MaslowCNC/Maslow_4/UI_UPDATED_DESIGN.md

# Connection Monitoring UI - Updated Design

## Changes Made (Based on PR Feedback)

1. ✅ Text is now static: "Connection Monitoring" (always the same)
2. ✅ Background color changes based on status
3. ✅ Warning icon "!" appears when there are issues
4. ✅ Detailed information moved to hover tooltip

## Visual Examples

### 1. Good Connection (Green - No Warning Icon)
```
┌─────────────────────────────┐
│   Connection Monitoring     │  <- Green background (#4aa85c)
└─────────────────────────────┘    White text, NO "!" icon

Hover tooltip shows:
┌──────────────────────────────────────┐
│ Connection Status: Good              │
│ Latency: 45ms                        │
│ Packet Loss: 0.5%                    │
│ Pings Sent: 124                      │
│ Pings Received: 123                  │
└──────────────────────────────────────┘
```

### 2. Degraded Connection (Orange - WITH Warning Icon)
```
┌─────────────────────────────┐
│   Connection Monitoring !   │  <- Orange background (#ffa500)
└─────────────────────────────┘    White text, WITH "!" icon

Hover tooltip shows:
┌──────────────────────────────────────┐
│ Connection Status: Degraded          │
│ Latency: 235ms                       │
│ Packet Loss: 8.2%                    │
│ Pings Sent: 200                      │
│ Pings Received: 183                  │
│ Pings Lost: 17                       │
└──────────────────────────────────────┘
```

### 3. Poor Connection (Dark Orange - WITH Warning Icon)
```
┌─────────────────────────────┐
│   Connection Monitoring !   │  <- Dark orange (#ff6600)
└─────────────────────────────┘    White text, WITH "!" icon

Hover tooltip shows:
┌──────────────────────────────────────┐
│ Connection Status: Poor              │
│ Packet Loss: 32.5%                   │
│ Pings Sent: 300                      │
│ Pings Received: 202                  │
│ Pings Lost: 98                       │
│                                      │
│ Consider checking your WiFi          │
│ connection.                          │
└──────────────────────────────────────┘
```

### 4. Connection Lost (Red - WITH Warning Icon)
```
┌─────────────────────────────┐
│   Connection Monitoring !   │  <- Red background (#ce654c)
└─────────────────────────────┘    White text, WITH "!" icon

Hover tooltip shows:
┌──────────────────────────────────────┐
│ Connection Status: LOST              │
│ Packet Loss: 78.3%                   │
│ Pings Sent: 150                      │
│ Pings Received: 32                   │
│ Pings Lost: 118                      │
│                                      │
│ Connection to machine may be lost!   │
└──────────────────────────────────────┘
```

### 5. Multiple Tabs Warning (Orange - WITH Warning Icon)
```
┌─────────────────────────────┐
│   Connection Monitoring !   │  <- Warning orange (#ff8c00)
└─────────────────────────────┘    White text, WITH "!" icon

Hover tooltip shows:
┌──────────────────────────────────────┐
│ WARNING: Multiple tabs detected!     │
│ 7 foreign pings received.            │
│ Only one tab should control the      │
│ machine at a time.                   │
└──────────────────────────────────────┘
```

### 6. Initializing (Starting - No Warning Icon)
```
┌─────────────────────────────┐
│   Connection Monitoring     │  <- Orange background (#ffa500)
└─────────────────────────────┘    White text, NO "!" icon

Hover tooltip shows:
┌──────────────────────────────────────┐
│ Initializing connection monitor...   │
└──────────────────────────────────────┘
```

## Key Improvements

### Before (Original Design):
- Text changed with every status update
- Hard to read at a glance
- Example: "✓ Connected (45ms, 0.5% loss)"
- Details always visible in button text

### After (Updated Design):
- Text is always "Connection Monitoring"
- Easy to identify at a glance
- Warning icon "!" clearly indicates issues
- Details hidden in tooltip (cleaner interface)
- Color-coded background for quick status check

## Color Scheme Summary

| Status | Background Color | Text Color | Warning Icon | Meaning |
|---|---|---|---|---|
| Good | Green (#4aa85c) | White | No | < 5% loss, < 500ms |
| Degraded | Orange (#ffa500) | White | Yes | 5-20% loss or 500-1000ms |
| Poor | Dark Orange (#ff6600) | White | Yes | 20-50% loss |
| Lost | Red (#ce654c) | White | Yes | > 50% loss |
| Multiple Tabs | Warning Orange (#ff8c00) | White | Yes | Foreign pings detected |
| Starting | Orange (#ffa500) | White | No | Initializing |

## User Experience Flow

1. **Normal Operation**: Green background, no warning icon, hover for details
2. **Minor Issues**: Orange background, warning icon appears, hover to see specifics
3. **Severe Issues**: Red background, warning icon, hover for troubleshooting info
4. **Critical Alert**: Orange with warning icon, hover shows multi-tab warning

The static text makes it clear what the indicator is for, while the color and warning icon provide immediate status feedback. Detailed metrics are available on hover for users who want to investigate further.
