MaslowCNC/Maslow_4/VISUAL_COMPARISON.md

# Visual Comparison: Before vs After

## BEFORE (Original Design)

The indicator text changed with every status update, making it harder to read:

```
┌──────────────────────────────────────────┐
│  ✓ Connected (45ms, 0.5% loss)          │  <- Text changes constantly
└──────────────────────────────────────────┘     Hard to read at a glance
    Green background, white text
```

```
┌──────────────────────────────────────────┐
│  ⚠️ Degraded (235ms, 8.2% loss)         │  <- Different text
└──────────────────────────────────────────┘     for each status
    Orange background, white text
```

```
┌──────────────────────────────────────────┐
│  ⚠️ Multiple tabs detected (7 foreign)  │  <- Long, detailed text
└──────────────────────────────────────────┘     in the button
    Orange background, white text
```

## AFTER (New Design) ✨

The indicator now has static text that's easy to read, with details on hover:

### Good Connection
```
┌──────────────────────────────┐
│   Connection Monitoring      │  <- Static, easy to read
└──────────────────────────────┘     
    🟢 Green background (#4aa85c)
    No warning icon

    Hover for tooltip:
    ┌────────────────────────────────┐
    │ Connection Status: Good        │
    │ Latency: 45ms                  │
    │ Packet Loss: 0.5%              │
    │ Pings Sent: 124                │
    │ Pings Received: 123            │
    └────────────────────────────────┘
```

### Degraded Connection (with Warning)
```
┌──────────────────────────────┐
│   Connection Monitoring !    │  <- Warning icon appears
└──────────────────────────────┘     
    🟠 Orange background (#ffa500)
    Warning icon "!" visible

    Hover for tooltip:
    ┌────────────────────────────────┐
    │ Connection Status: Degraded    │
    │ Latency: 235ms                 │
    │ Packet Loss: 8.2%              │
    │ Pings Sent: 200                │
    │ Pings Received: 183            │
    │ Pings Lost: 17                 │
    └────────────────────────────────┘
```

### Poor Connection (with Warning)
```
┌──────────────────────────────┐
│   Connection Monitoring !    │  <- Warning icon
└──────────────────────────────┘     
    🟠 Dark Orange background (#ff6600)
    Warning icon "!" visible

    Hover for tooltip:
    ┌────────────────────────────────┐
    │ Connection Status: Poor        │
    │ Packet Loss: 32.5%             │
    │ Pings Sent: 300                │
    │ Pings Received: 202            │
    │ Pings Lost: 98                 │
    │                                │
    │ Consider checking your WiFi    │
    │ connection.                    │
    └────────────────────────────────┘
```

### Connection Lost (with Warning)
```
┌──────────────────────────────┐
│   Connection Monitoring !    │  <- Warning icon
└──────────────────────────────┘     
    🔴 Red background (#ce654c)
    Warning icon "!" visible

    Hover for tooltip:
    ┌────────────────────────────────┐
    │ Connection Status: LOST        │
    │ Packet Loss: 78.3%             │
    │ Pings Sent: 150                │
    │ Pings Received: 32             │
    │ Pings Lost: 118                │
    │                                │
    │ Connection to machine may be   │
    │ lost!                          │
    └────────────────────────────────┘
```

### Multiple Tabs Warning
```
┌──────────────────────────────┐
│   Connection Monitoring !    │  <- Warning icon
└──────────────────────────────┘     
    🟠 Warning Orange (#ff8c00)
    Warning icon "!" visible

    Hover for tooltip:
    ┌────────────────────────────────┐
    │ WARNING: Multiple tabs         │
    │ detected!                      │
    │ 7 foreign pings received.      │
    │ Only one tab should control    │
    │ the machine at a time.         │
    └────────────────────────────────┘
```

## Key Improvements ✨

### ✅ Readability
- **Before**: Text like "✓ Connected (45ms, 0.5% loss)" was hard to read quickly
- **After**: "Connection Monitoring" is clear and easy to identify

### ✅ Consistency
- **Before**: Button text changed constantly, making it hard to find
- **After**: Static text makes it easy to locate the indicator

### ✅ Warning Visibility
- **Before**: Warning emoji mixed with other text
- **After**: Clean "!" icon that stands out clearly

### ✅ Information Density
- **Before**: All details crammed into button text
- **After**: Clean interface with details available on hover

### ✅ Professional Appearance
- **Before**: Looked cluttered with numbers and symbols
- **After**: Clean, professional status indicator

## Real-World Usage Example

### User Experience Flow:

1. **Quick Glance**: User sees green "Connection Monitoring" button
   - Status: Everything is OK ✓

2. **Notice Warning**: Color changes to orange, "!" appears
   - User immediately knows there's an issue
   - Text still readable: "Connection Monitoring !"

3. **Get Details**: User hovers over the button
   - Tooltip shows: "Latency: 235ms, Packet Loss: 8.2%"
   - User can diagnose the problem

4. **Take Action**: Based on tooltip info, user can:
   - Check WiFi signal
   - Close extra browser tabs
   - Move closer to router
   - Wait for connection to stabilize

## Technical Implementation

The JavaScript code now returns:
```javascript
{
    status: 'good',
    displayText: 'Connection Monitoring',  // Always the same
    tooltip: 'Connection Status: Good\n...',  // Details here
    color: '#4aa85c',  // Green
    showWarning: false  // No "!" icon
}
```

When issues are detected:
```javascript
{
    status: 'degraded',
    displayText: 'Connection Monitoring',  // Still the same
    tooltip: 'Connection Status: Degraded\n...',  // Details
    color: '#ffa500',  // Orange
    showWarning: true  // Show "!" icon
}
```

The UI code then:
1. Sets text: `displayText + (showWarning ? ' !' : '')`
2. Sets color: `indicator.style.backgroundColor = color`
3. Sets tooltip: `indicator.title = tooltip`

This creates a clean, professional interface that's easy to understand at a glance while still providing detailed information when needed.
