MaslowCNC/Maslow_4/.github/INDEXING_SUMMARY.md

# Repository Indexing Summary - Maslow_4

**Date**: 2024-12-04  
**Issue**: Request to refresh Copilot repository setup and re-index

## Important Information About Copilot Indexing

GitHub Copilot's repository indexing is **fully automatic** and happens when users interact with the repository through Copilot Chat. There is no manual "re-index" trigger or setup command.

### How to Get Updated Index (For Repository Users)

To ensure Copilot uses the latest repository state:

1. **Open Copilot Chat** in your IDE (VS Code, GitHub.com, etc.)
2. **Use repository context** (@workspace or repository selection)
3. **Start a conversation** - The index automatically refreshes in under 60 seconds

That's it! No configuration changes or setup commands are needed.

## Repository Configuration Status

This repository is properly configured for optimal Copilot performance:

### ✅ Language and Linter Configurations Present

- **`.clang-format`**: C++ code style definition (140 char limit, brace wrapping, etc.)
- **`.editorconfig`**: Universal editor settings (final newlines)
- **`.coderabbit.yaml`**: Automated code review with multiple linters enabled

### ✅ Copilot Instructions Available

- **`.github/copilot-instructions.md`**: Comprehensive 204-line guide covering:
  - Build system commands and timing (PlatformIO)
  - Project structure navigation
  - Development best practices
  - Testing and validation procedures
  - ESP32-S3 firmware specifics

### ✅ Repository Structure Documented

Primary source directories properly organized:
- `firmware/FluidNC/src/` - 311 C++ source files
- `firmware/` - ESP32 firmware and build system
- `docs/` - User documentation
- Python build scripts (8 files)

Build artifacts correctly excluded via `.gitignore`:
- `.pio/`, `build/`, `node_modules/`, `dist/`

## New Documentation Added

Created **`.github/COPILOT_INDEXING.md`** with detailed information about:
- How Copilot indexing works (automatic, instant refresh)
- Repository structure and file organization
- Language configurations and linters
- Best practices for using Copilot with this project
- Troubleshooting steps if indexing seems stale

## Action Items for Repository Owner

Since Copilot indexing is automatic, here's what you can do:

### Immediate Actions (Anyone with Copilot access)

1. **Test the refresh yourself**:
   - Open this repository in VS Code or GitHub.com
   - Start a new Copilot Chat session
   - Ask: "@workspace Can you explain the structure of firmware/FluidNC/src/?"
   - Copilot should index and provide accurate, current information

2. **Verify indexing is working**:
   - Ask Copilot about recent changes or newly added directories
   - Check if suggestions reference the correct file paths
   - Confirm it understands this is ESP32-S3 FluidNC firmware

### If Indexing Still Seems Stale

1. **Check indexing limits**:
   - Copilot Individual: 5 repositories max
   - Copilot Business: 50 repositories max
   - Copilot Enterprise: Unlimited
   - If at limit, may need to remove old indexes or upgrade

2. **Try troubleshooting steps**:
   - Restart IDE completely
   - Clear IDE cache
   - Log out and back into GitHub Copilot

3. **Contact GitHub Support** if issues persist:
   - Mention this is for the MaslowCNC/Maslow_4 repository
   - Describe what Copilot is getting wrong (outdated paths, missing directories, etc.)
   - Reference that indexing should be automatic but appears stuck

## Technical Details

### Languages Detected
- C/C++: Primary (311 files in src/)
- Python: Build scripts (8 files)
- JavaScript/HTML/CSS: Web UI
- YAML: Configuration files

### Build System
- **PlatformIO** for ESP32-S3 firmware
- **Node.js** for web UI build
- **Python** for build automation

### Code Style Enforced
- clang-format for C++ (configured)
- editorconfig for all files (basic)

## Conclusion

**No code changes are required to refresh Copilot indexing.** The indexing happens automatically when users interact with the repository via Copilot Chat.

This PR adds documentation to help users understand how indexing works and confirms that all repository configurations are in place for optimal Copilot performance.

### What This PR Does

✅ Adds comprehensive indexing documentation  
✅ Confirms language/linter configurations are present  
✅ Documents repository structure for reference  
✅ Provides troubleshooting guidance  

### What It Does NOT Do

❌ Does not trigger Copilot re-indexing (not possible via code changes)  
❌ Does not add new linters (existing ones are sufficient)  
❌ Does not change any source code (not necessary)  

The repository is ready for Copilot to index. Users just need to open Copilot Chat to trigger the automatic indexing process.
