MaslowCNC/Maslow_4/docs/calibration-simulation/data-parser.html

# Maslow Calibration Data Parser

Process real calibration measurements to find optimal anchor positions

### 📥 Calibration Data Input

Paste measurement data from your Maslow machine. Supports multiple formats:
• Plain: {tl:2051.76, tr:2053.05, bl:1942.31, br:1952.85},...
• CLBM: CLBM:[{bl:2960.58, br:3150.08, tr:3067.72, tl:3049.85},...]

Measurement Data:

Parse and Validate

### ⚓ Initial Anchor Positions

Starting estimates for anchor point positions. If the initial fitness is low or the frame is nearly square, the algorithm will automatically compute better starting positions using rectangular optimization (same as ESP3D-WEBUI).

Top Left X (mm)

Top Left Y (mm)

Top Right X (mm)

Top Right Y (mm)

Bottom Right X (mm)

### ⚙️ Computation

Compute Anchor Positions

#### 📊 Search Visualization

Red points: Phase 1 diagonal search | Blue points: Phase 2 arc search | Green star: Best configuration found

#### ✅ Optimized Anchor Positions

Top Left X

Top Left Y

Top Right X

Top Right Y

Bottom Right X

Fitness Score

### 📋 Output Log
