MaslowCNC/Maslow_4/firmware/FluidNC/data/maslow.yaml

board: Maslow
name: Maslow S3 Board
meta: 
Maslow_vertical: false
Maslow_calibration_grid_width_mm_X: 0.000000
Maslow_calibration_grid_height_mm_Y: 0.000000
Maslow_calibration_grid_size: 9
Maslow_Retract_Current_Threshold: 1300
Maslow_Acceptable_Calibration_Threshold: 0.450000
Maslow_Extend_Dist: 2600.000000
Maslow_Scale_X: 1.000000
Maslow_Scale_Y: 1.000000
Maslow_debugEnabled: false
MaslowAutoUpdate: false
MaslowUpdateURL: https://api.github.com/repos/BarbourSmith/FluidNC/releases/latest
Maslow_spoilboardThickness: 0.000000
Maslow_workThickness: 0.000000
Maslow_Park_Z: 2.000000
Maslow_Park_X: 0.000000
Maslow_Park_Y: 0.000000
stepping: 
  engine: Timed
  idle_ms: 240
  pulse_us: 4
  dir_delay_us: 0
  disable_delay_us: 0
  segments: 12

uart1: 
  txd_pin: gpio.1
  rxd_pin: gpio.2
  rts_pin: NO_PIN
  cts_pin: NO_PIN
  baud: 115200
  mode: 8N1

spi: 
  miso_pin: gpio.13
  mosi_pin: gpio.11
  sck_pin: gpio.12

sdcard: 
  cs_pin: gpio.10
  card_detect_pin: NO_PIN
  frequency_hz: 8000000

kinematics: 
  MaslowKinematics: 
    tlX: 139.199997
    tlY: 3230.600098
    tlZ: 100.000000
    trX: 4308.899902
    trY: 3230.699951
    trZ: 56.000000
    blX: 0.000000
    blY: 0.000000
    blZ: 34.000000
    brX: 4340.399902
    brY: 0.000000
    brZ: 78.000000
    beltEndExtension: 30.000000
    armLength: 123.400002
    beltToothSpacing: 1.998800
    encoderTeeth: 22.000000
    maxSegmentLength: 5.000000
    fixedZ: false

axes: 
  shared_stepper_disable_pin: NO_PIN
  shared_stepper_reset_pin: NO_PIN
  a: 
    steps_per_mm: 80.000000
    max_rate_mm_per_min: 2000.000000
    acceleration_mm_per_sec2: 50.000000
    max_travel_mm: 4000.000000
    soft_limits: false
    homing: 
      cycle: -1
      allow_single_axis: true
      positive_direction: true
      mpos_mm: 0.000000
      feed_mm_per_min: 50.000000
      seek_mm_per_min: 200.000000
      settle_ms: 250
      seek_scaler: 1.100000
      feed_scaler: 1.100000

    motor0: 
      limit_neg_pin: NO_PIN
      limit_pos_pin: NO_PIN
      limit_all_pin: NO_PIN
      hard_limits: false
      pulloff_mm: 1.000000
      null_motor: 

  b: 
    steps_per_mm: 80.000000
    max_rate_mm_per_min: 2000.000000
    acceleration_mm_per_sec2: 50.000000
    max_travel_mm: 4000.000000
    soft_limits: false
    homing: 
      cycle: -1
      allow_single_axis: true
      positive_direction: true
      mpos_mm: 0.000000
      feed_mm_per_min: 50.000000
      seek_mm_per_min: 200.000000
      settle_ms: 250
      seek_scaler: 1.100000
      feed_scaler: 1.100000

    motor0: 
      limit_neg_pin: NO_PIN
      limit_pos_pin: NO_PIN
      limit_all_pin: NO_PIN
      hard_limits: false
      pulloff_mm: 1.000000
      null_motor: 

  c: 
    steps_per_mm: 80.000000
    max_rate_mm_per_min: 2000.000000
    acceleration_mm_per_sec2: 50.000000
    max_travel_mm: 4000.000000
    soft_limits: false
    homing: 
      cycle: -1
      allow_single_axis: true
      positive_direction: true
      mpos_mm: 0.000000
      feed_mm_per_min: 50.000000
      seek_mm_per_min: 200.000000
      settle_ms: 250
      seek_scaler: 1.100000
      feed_scaler: 1.100000

    motor0: 
      limit_neg_pin: NO_PIN
      limit_pos_pin: NO_PIN
      limit_all_pin: NO_PIN
      hard_limits: false
      pulloff_mm: 1.000000
      null_motor: 

  d: 
    steps_per_mm: 80.000000
    max_rate_mm_per_min: 2000.000000
    acceleration_mm_per_sec2: 50.000000
    max_travel_mm: 4000.000000
    soft_limits: false
    homing: 
      cycle: -1
      allow_single_axis: true
      positive_direction: true
      mpos_mm: 0.000000
      feed_mm_per_min: 50.000000
      seek_mm_per_min: 200.000000
      settle_ms: 250
      seek_scaler: 1.100000
      feed_scaler: 1.100000

    motor0: 
      limit_neg_pin: NO_PIN
      limit_pos_pin: NO_PIN
      limit_all_pin: NO_PIN
      hard_limits: false
      pulloff_mm: 1.000000
      null_motor: 

  z: 
    steps_per_mm: 100.000000
    max_rate_mm_per_min: 400.000000
    acceleration_mm_per_sec2: 10.000000
    max_travel_mm: 100.000000
    soft_limits: false
    homing: 
      cycle: -1
      allow_single_axis: true
      positive_direction: true
      mpos_mm: 0.000000
      feed_mm_per_min: 50.000000
      seek_mm_per_min: 200.000000
      settle_ms: 250
      seek_scaler: 1.100000
      feed_scaler: 1.100000

    motor0: 
      limit_neg_pin: NO_PIN
      limit_pos_pin: NO_PIN
      limit_all_pin: NO_PIN
      hard_limits: false
      pulloff_mm: 1.000000
      null_motor:

    motor1: 
      limit_neg_pin: NO_PIN
      limit_pos_pin: NO_PIN
      limit_all_pin: NO_PIN
      hard_limits: false
      pulloff_mm: 1.000000
      null_motor:

control: 
  safety_door_pin: NO_PIN
  reset_pin: NO_PIN
  feed_hold_pin: NO_PIN
  cycle_start_pin: NO_PIN
  macro0_pin: NO_PIN
  macro1_pin: NO_PIN
  macro2_pin: NO_PIN
  macro3_pin: NO_PIN

coolant: 
  flood_pin: NO_PIN
  mist_pin: NO_PIN
  delay_ms: 0

probe: 
  pin: NO_PIN
  check_mode_start: true

macros: 
  startup_line0: 
  startup_line1: 
  macro0: 
  macro1: 
  macro2: 
  macro3: 

start: 
  must_home: true
  deactivate_parking: false
  check_limits: false

parking: 
  enable: false
  axis: Z
  target_mpos_mm: -5.000000
  rate_mm_per_min: 800.000000
  pullout_distance_mm: 5.000000
  pullout_rate_mm_per_min: 250.000000

user_outputs: 
  analog0_pin: NO_PIN
  analog1_pin: NO_PIN
  analog2_pin: NO_PIN
  analog3_pin: NO_PIN
  analog0_hz: 5000
  analog1_hz: 5000
  analog2_hz: 5000
  analog3_hz: 5000
  digital0_pin: NO_PIN
  digital1_pin: NO_PIN
  digital2_pin: NO_PIN
  digital3_pin: NO_PIN
  digital4_pin: NO_PIN
  digital5_pin: NO_PIN
  digital6_pin: NO_PIN
  digital7_pin: NO_PIN

SpindleBoard:
  phase_deg_per_mm: 45.000000
  max_rpm: 14000
  suction_power: 100
  tool_num: 0
  speed_map: 0=0.000% 14000=100.000%
  off_on_alarm: true
  uart:
    txd_pin: gpio.15
    rxd_pin: gpio.16
    rts_pin: NO_PIN
    cts_pin: NO_PIN
    baud: 115200
    mode: 8N1

arc_tolerance_mm: 0.002000
junction_deviation_mm: 0.010000
verbose_errors: false
report_inches: false
enable_parking_override_control: false
use_line_numbers: false
planner_blocks: 16
