MaslowCNC/Maslow_4/spindle/src/config.h

#pragma once

#include <Arduino.h>

// Motor parameters
const int   POLE_PAIRS = 1;
const float SUPPLY_VOLTAGE = 24.0f;

// Which way the spindle turns.  The two motors always run in OPPOSITE senses (the spindle is
// driven by the difference of their angles); this flips both at once, which reverses the
// spindle.  The Z axis is unaffected: it comes from the phase OFFSET, which updatePhaseOffset()
// applies as the same delta to both motors without consulting these signs, so homing, tool
// load and tool removal keep their existing directions.  Flip to +1 to spin the other way.
const int SPINDLE_DIRECTION = -1;

// Voltage limits
const float BASE_VOLTAGE = 1.3f;
// Open-loop ceiling, raised to the full 24V bus to give the sweep room up to 18,000 RPM.
// NOTE this also required raising the DRIVER limit to SUPPLY_VOLTAGE in motor_controller.cpp -
// BLDCDriver6PWM::setPwm() clamps every phase to driver.voltage_limit, which was
// SUPPLY_VOLTAGE*0.8 = 19.2V, so a 24V ceiling here alone would simply have been clipped there.
//
// Physical reality above ~12V: with SinePWM on a 24V bus the largest UNCLIPPED q-axis amplitude
// is voltage_power_supply/2 = 12V.  Past that the waveform clips, and at full square wave the
// fundamental tops out near (4/pi)(Vdc/2) = 15.3V.  So requesting 18-24V buys progressively less
// speed and progressively more harmonic current and heat - which is also what trips the
// MP6541A's fixed 16-20A OCP.  Expect the top of the LUT to flatten out somewhere in here.
// The calibration LUT must be rebuilt (run "CAL") after changing this.
const float MAX_VOLTAGE = 24.0f;

// PWM configuration.  The MP6541A adds no dead time of its own (HSx+LSx both high simply
// gives Hi-Z), so the dead zone below is the only shoot-through margin.
// NOTE: on the DRV8316 board these two values were assigned AFTER the driver was initialized,
// so they never reached SimpleFOC and the PWM actually ran at its 20kHz default - which is
// what the calibration LUT below was measured at.  They now take effect, so the value here is
// set to that same 20kHz to keep commutation identical to the old board.  Note the practical
// ceiling is ~26.7kHz, NOT the 50kHz that _constrain() in _configure6PWM suggests: the timer
// period is then clamped to _PWM_RES_MIN = 3000 counts, giving 160MHz/(2*3000).  Anything above
// that is silently rounded down to it.  Raise deliberately and re-run CAL, remembering that a
// higher carrier shrinks the ripple the sweep measures, so the same current target then
// corresponds to a higher real fundamental current.
const long  PWM_FREQUENCY = 20000;   // 20 kHz
const float DEAD_ZONE = 0.02f;       // ~2% deadtime

// Phase current sensing (MP6541A SOx -> board termination -> ESP32 ADC).
// SOx sources/sinks ILOAD/11000 into a 3.3k/3.3k divider across 3V3, so Rref = 1.65k and the
// nominal mid-point is 1.65V:  V = Vref + Rref * ILOAD / 11000  ->  0.15 V/A.
// (The preliminary MPQ6541 datasheet quotes 1/10,000, which would be 0.165 V/A - verify on
// the bench against a clamp meter before trusting the current-based trip points below.)
const float CSA_RREF_OHMS   = 1650.0f;
const float CSA_RATIO       = 11000.0f;
const float CSA_GAIN_V_PER_A = CSA_RREF_OHMS / CSA_RATIO;   // 0.15 V/A
const float CSA_VREF        = 1.65f;   // nominal zero-current level; measured at boot

// Fan PWM configuration
const long FAN_PWM_FREQUENCY = 25000;
const int  FAN_PWM_RESOLUTION_BITS = 8;
const int  FAN_PWM_CHANNEL = 7;
const uint8_t FAN_MIN_DUTY = 80;
const uint8_t FAN_MAX_DUTY = 255;
const int FAN_LEVEL_COUNT = 100;
const float FAN_PWM_RAMP_UNITS_PER_SEC = 320.0f;

// Velocity ramping
const float VELOCITY_RAMP_RATE = 20.0f;   // rad/s per second, used during calibration
// Spindle spin-up/down uses a single uniform ramp rate (matching the reference firmware, which
// reaches 14,000 RPM cleanly with one rate), applied by rampVelocity() every FOC iteration.
// The earlier speed-dependent dual-rate ramp was removed: it added complexity without being the
// cause of the high-speed fault.
const float SPINDLE_RAMP_RATE  = 500.0f;  // rad/s per second, spindle on/off spin-up/down rate

// --- FOC loop scheduling ---
// The FOC update (loopFOC + move) runs on its OWN task pinned to core 1 with nothing else in the
// loop body, so open-loop commutation runs at the highest, most uniform rate possible.  Everything
// that is not time-critical for commutation - current sensing (six analogReads, ~0.5 ms), the
// calibration sweep, serial command dispatch, fault checks, the tool state machine, fan, telemetry
// and status reporting - runs on a SEPARATE housekeeping task pinned to core 0, ticking every
// FOC_HOUSEKEEPING_INTERVAL_MS.  This keeps the expensive/slow work entirely off the FOC core so it
// can never lengthen a commutation step (the ~1.8 kHz-with-hiccups single-task design pulled the
// open-loop rotor out of sync at high RPM and tripped the driver's hardware OCP even with voltage
// headroom).
const uint32_t FOC_HOUSEKEEPING_INTERVAL_MS = 2;     // core-0 housekeeping task period

// Phase offset ramping
const float PHASE_OFFSET_STEP = 45.0f * PI / 180.0f;          // 45 deg per keypress
const float PHASE_OFFSET_RAMP_RATE = 400.0f * PI / 180.0f;    // 400 deg/s ramp

// Inter-board link (UART to FluidNC XY board)
const long    LINK_BAUD = 115200;          // baud rate for the XY <-> spindle link
const uint32_t LINK_STATUS_INTERVAL_MS = 50;  // how often to report status to the XY board
const int     MAX_COMMAND_RPM = 18000;     // clamp for spindle speed commands; keep in step with
                                           // CAL_MAX_RAD so the whole LUT is reachable over the link

// On-demand WiFi OTA.  The board normally keeps its radio off; when the XY board sends
// the 'W' link command (in response to $Spindle/EnableOTA) it joins the XY board's WiFi
// network and runs an ArduinoOTA server so it can be reflashed wirelessly with:
//   pio run -e esp32-s3-devkitc-1-ota -t upload
const char*    const OTA_HOSTNAME                = "maslow-spindle";  // mDNS -> maslow-spindle.local
const uint32_t       OTA_WIFI_CONNECT_TIMEOUT_MS = 20000;   // give up joining WiFi after 20 s
const uint32_t       OTA_IDLE_TIMEOUT_MS         = 300000;  // drop WiFi/OTA after 5 min idle
const int            OTA_RECEIVE_TIMEOUT_MS      = 15000;   // tolerate 15 s data gaps mid-flash
// The OTA request is persisted to NVS and the board reboots to service it from a clean,
// freshly booted state (the only state that reliably survives the WiFi radio's power-up
// current surge on 24 V-only power).  Each boot is one attempt: a bring-up that resets mid-surge
// OR a transfer that fails (which also reboots, since ArduinoOTA won't cleanly retry on the same
// boot) consumes one.  The flag survives across reboots so setup() resumes automatically, up to
// this many attempts before giving up so a truly unreachable network can't boot-loop forever.
const uint8_t        OTA_BOOT_MAX_ATTEMPTS       = 10;

// Current filtering
const float CURRENT_FILTER_ALPHA = 0.001f;      // Slow filter for DC-equivalent telemetry
const float PROTECTION_FILTER_ALPHA = 0.1f;     // Fast filter for stall detection

// Overcurrent protection
const float OVERCURRENT_THRESHOLD = 6.0f;       // Phase-RMS trip point (A), same during calibration
const int   OVERCURRENT_CONSECUTIVE_TRIPS = 100;

// Motor run timeout
const uint32_t MOTOR_RUN_DURATION = 6000000;     // 60 seconds in ms

// Z-axis (phase-offset) hold power-down.  When the spindle is not spinning, the two
// BLDC drivers only hold the Z position with current, which keeps them (and the
// cooling fan) energized even though nothing is moving.  Once the XY board reports the
// machine is idle (the 'D' command) and the phase ramp has settled to within this
// tolerance of its target, the drivers are powered down.
const float PHASE_MOVE_COMPLETE_EPS_RAD = 0.001f;   // within ~0.06 deg of target = move done

// Extra motor voltage applied while the relative phase between the two motors is
// changing (i.e. the Z axis is moving).  Changing the phase fights extra mechanical
// resistance in the Z drive, so give the drivers a little more headroom while moving.
const float Z_MOVE_VOLTAGE_BOOST = 1.0f;            // volts added during phase (Z) moves

// --- Z-axis power-up homing (top-of-travel beam break) ---
// On power-up, an already-blocked beam makes the Z lower until the beam clears.  Otherwise,
// the Z raises until the top-of-travel beam is interrupted, which establishes the home
// position and confirms a tool is loaded.  The Z is driven by the relative phase between
// the two BLDC motors; the XY board uses 45 deg of phase per mm of Z travel (its
// phase_deg_per_mm), so the mm limit below is converted with the same constant.  If the Z
// raises further than Z_HOMING_MAX_MM without the beam breaking, no tool is loaded.
const float PHASE_DEG_PER_MM   = 45.0f;   // must match the XY board's phase_deg_per_mm
const float Z_HOMING_MAX_MM    = 70.0f;   // give up (no tool loaded) past this much travel
const float Z_HOMING_PHASE_DIR = +1.0f;   // +1 raises the Z; flip to -1 if homing drives it down
const float Z_HOMING_MAX_RAD =
    Z_HOMING_MAX_MM * PHASE_DEG_PER_MM * PI / 180.0f;  // travel limit as a phase offset (rad)

// Delay the power-up Z-homing raise so the shared 24V rail and the other boards have time to
// come up first.  The homing raise energizes both BLDC motors (a heavy current surge); doing
// it the instant the app starts can sag a marginal supply.  Only the initial boot homing is
// delayed - an operator re-home ('G') happens long after boot so it is unaffected.
const uint32_t BOOT_HOMING_DELAY_MS = 1000;  // wait this long after boot before homing

// --- Z-axis tool loading (reverse of homing) ---
// While homing has left the board in the "no tool loaded" state, the top-of-travel beam
// is monitored.  When the operator inserts a tool it interrupts the beam, which starts a
// tool-loading move: the Z is lowered (opposite the homing direction) until the beam is no
// longer broken, at which point a tool is considered loaded.  The lowering move gives up
// (leaving the tool not loaded) once it travels this far without the beam clearing.
const float Z_TOOL_LOAD_MAX_MM = 200.0f;  // give up lowering past this much travel
const float Z_TOOL_LOAD_MAX_RAD =
    Z_TOOL_LOAD_MAX_MM * PHASE_DEG_PER_MM * PI / 180.0f;  // travel limit as a phase offset (rad)
// As the operator inserts a tool the beam can flicker (blocked, briefly clear, blocked) before
// the tool is pulled fully down and seated.  The lowering move keeps going until the beam has
// stayed clear for this long; any re-interruption during the window restarts the timer, so a
// momentary clear while the tool is still entering the beam is not mistaken for a seated tool.
const uint32_t Z_TOOL_LOAD_CONFIRM_MS = 400;  // beam must stay clear this long to finish loading

// --- Z-axis tool removal (raise to eject) ---
// Triggered on demand by the XY board's 'R' command (web UI "Remove Tool" button).  With a
// tool loaded the top-of-travel beam is interrupted; the Z raises (the homing direction)
// until the beam transitions from blocked (tool present) to clear (tool removed), at which
// point the board returns to the "no tool loaded" state.  The move gives up and stops once
// it travels this far without the beam clearing.
const float Z_TOOL_REMOVE_MAX_MM = 150.0f;  // give up raising past this much travel
const float Z_TOOL_REMOVE_MAX_RAD =
    Z_TOOL_REMOVE_MAX_MM * PHASE_DEG_PER_MM * PI / 180.0f;  // travel limit as a phase offset (rad)
// After the beam first clears the Z keeps raising for this long to confirm a clean removal;
// if the beam is interrupted again at any point during the window the timer restarts, so a
// tool flickering right on the edge of the beam is not mistaken for a completed removal.
const uint32_t Z_TOOL_REMOVE_CONFIRM_MS = 500;  // beam must stay clear this long to finish

// Calibration LUT
const int   CAL_LUT_SIZE = 180;                                     // 100, 200, ... 18000 RPM
const float CAL_TARGET_CURRENT = 2.625f;                            // Target phase-RMS current (A).
                                                                    // 75% of the 3.5A used on the DRV8316 board: the
                                                                    // MP6541A's hardware OCP is fixed at 16-20A (the
                                                                    // DRV8316 was configured for 24A), so the sweep
                                                                    // hunts to a lower current to keep the spin-up
                                                                    // transient clear of that lower ceiling.
const float CAL_CHECKPOINT_STEP_RAD = 100.0f * 2.0f * PI / 60.0f;  // 100 RPM step in rad/s
const float CAL_MAX_RAD = 18000.0f * 2.0f * PI / 60.0f;            // 18000 RPM in rad/s
const uint32_t CAL_SETTLE_MS = 500;                                 // ms to wait after reaching speed
const float CAL_HUNT_VOLTAGE_MARGIN = 0.9f;                         // Max extra volts above seeded LUT at each step
const float CAL_RAMP_VOLT_PER_RAD = 0.0025f;                        // Open-loop spin-floor slope (volts per rad/s).
                                                                    // Kept BELOW the real current-limited curve so the hunt
                                                                    // can converge; spin-up between steps relies on the
                                                                    // previous step's voltage carried forward, not this floor.
const uint32_t CAL_COOLDOWN_MS = 8000;                              // How long to coast (motor de-energized) after the driver
                                                                    // thermally shuts down before continuing the sweep.  At low
                                                                    // RPM the open-loop current sits on one or two FETs long
                                                                    // enough to heat the die (the package can still feel cool);
                                                                    // coasting to cool before advancing stops the heat cascading
                                                                    // up through the rest of the sweep.  The MP6541A has no
                                                                    // over-temperature WARNING and nFAULT is released once the
                                                                    // drivers sleep, so the die temperature cannot be polled
                                                                    // while cooling - this is a fixed wait.

// MP6541A fault detection (nFAULT, one open-drain pin per driver).
// The MP6541A reports two things on nFAULT, distinguished by shape rather than by any status
// register: an OVER-CURRENT disables the outputs and auto-retries after ~2ms, so it appears as
// a burst of falling EDGES (counted by an ISR - a 100ms poll would miss the pulses), while an
// OVER-TEMPERATURE shutdown holds the pin LOW continuously until the die cools by ~25C.
// Over-voltage and UVLO are NOT reported on nFAULT at all, so they can no longer be observed
// in firmware; the MP6541A still protects itself in hardware.
const int OCP_CONSEC_LIMIT = 5;  // 5 x 100ms = 500ms of repeated OCP retries -> disable
// An over-temperature must be seen held low across this many 100ms samples before it is
// treated as a genuine (latching) serious fault, so that the brief low of an over-current
// retry sampled at just the wrong moment is not mistaken for a thermal shutdown.
const int SERIOUS_CONSEC_LIMIT = 3;  // 3 x 100ms = 300ms sustained OT -> latch

// Over-current response: the motors run open-loop, so an over-current means the rotor has
// already slipped.  There is nothing to retry - the spindle stops at 0 RPM, latches fault
// code 2 (which alarms the XY board and stops a running job), and invalidates the Z reference
// until a homing cycle re-establishes it.  A fresh speed command is the deliberate restart.
