MaslowCNC/Maslow_4/firmware/FluidNC/src/Kinematics/MaslowKinematics.cpp

// Copyright (c) 2024 - Maslow CNC. All rights reserved.
// Use of this source code is governed by a GPLv3 license that can be found in the LICENSE file.

#include "MaslowKinematics.h"

#include "../Machine/MachineConfig.h"
#include "../Limit.h"
#include "../Machine/Homing.h"
#include "../Protocol.h"
#include "../System.h"
#include <cstring>
#include "../NutsBolts.h"
#include "../MotionControl.h"
#include <cmath>
#include <algorithm>
#include "../Maslow/Maslow.h"

/*
Default configuration for Maslow CNC:

kinematics:
  MaslowKinematics:
    tlX: -27.6
    tlY: 2064.9
    tlZ: 100.0
    trX: 2924.3
    trY: 2066.5
    trZ: 56.0
    blX: 0.0
    blY: 0.0
    blZ: 34.0
    brX: 2953.2
    brY: 0.0
    brZ: 78.0
    beltEndExtension: 30.0
    armLength: 123.4
    beltToothSpacing: 1.9988  # mm between adjacent belt teeth
    encoderTeeth: 22.0        # tooth count on the encoder roller
    spoilboardThickness: 0.0
    workThickness: 0.0
    maxSegmentLength: 5.0

This implements the cable-driven kinematics for the Maslow CNC system.
The system has 5 axes:
- A, B, C, D (belt motors: TL, TR, BL, BR mapped to motors 0-3)
- Z (cartesian Z coordinate mapped to motor 4)

The spoilboardThickness and workThickness parameters account for material thickness
placed on the cutting surface. Both values are added to all anchor point Z coordinates
during belt length calculations, effectively raising the reference height for all belts.

The maxSegmentLength parameter controls belt length synchronization during long moves.
Moves longer than this distance (in mm) will be automatically segmented to ensure
correct belt lengths are computed at intermediate points, preventing belt slack.
*/

namespace Kinematics {

    // Global pointer to the current MaslowKinematics instance
    static MaslowKinematics* g_maslowKinematics = nullptr;

    void MaslowKinematics::init() {
        calculateCenter();
        g_maslowKinematics = this;  // Set global pointer for access
        init_position();
    }

    void MaslowKinematics::init_position() {
        auto n_axis = config->_axes->_numberAxis;
        for (axis_t axis = X_AXIS; axis < n_axis; axis++) {
            set_steps(axis, 0);  // Set to zeros
        }
    }

    void MaslowKinematics::calculateCenter() {
        // Calculate center point of the frame for coordinate system transformation
        // Find the intersection of the diagonals of the rectangle (proper geometric center)
        float A = (anchor_location[_TR][Coord_Y] - anchor_location[_BL][Coord_Y]) /
                  (anchor_location[_TR][Coord_X] - anchor_location[_BL][Coord_X]);
        float B = (anchor_location[_BR][Coord_Y] - anchor_location[_TL][Coord_Y]) /
                  (anchor_location[_BR][Coord_X] - anchor_location[_TL][Coord_X]);
        _centerX = (anchor_location[_BR][Coord_Y] - (B * anchor_location[_BR][Coord_X]) + (A * anchor_location[_TR][Coord_X]) -
                    anchor_location[_TR][Coord_Y]) /
                   (A - B);
        _centerY = A * (_centerX - anchor_location[_TR][Coord_X]) + anchor_location[_TR][Coord_Y];

        //log_info("Maslow center calculated: X=" << _centerX << " Y=" << _centerY);
    }

    void MaslowKinematics::getFrameSize(float& width, float& height) const {
        width  = std::min(anchor_location[_TR][Coord_X] - anchor_location[_TL][Coord_X],
                         anchor_location[_BR][Coord_X] - anchor_location[_BL][Coord_X]);
        height = std::min(anchor_location[_TL][Coord_Y] - anchor_location[_BL][Coord_Y],
                          anchor_location[_TR][Coord_Y] - anchor_location[_BR][Coord_Y]);
    }

    void MaslowKinematics::getWorkArea(float& width, float& height) const {
        width  = Maslow.workAreaX;
        height = Maslow.workAreaY;
        if (width > 0 && height > 0) {
            return;
        }
        //Auto: about a 4x8 sheet on a standard ~3000 x 2100 mm frame
        float frameWidth, frameHeight;
        getFrameSize(frameWidth, frameHeight);
        if (width <= 0) {
            width = std::max(frameWidth * 0.8f, 0.0f);
        }
        if (height <= 0) {
            height = std::max(frameHeight * 0.6f, 0.0f);
        }
    }

    bool MaslowKinematics::cartesian_to_motors(float* target, plan_line_data_t* pl_data, float* position) {
        auto n_axis = config->_axes->_numberAxis;

        // Ensure we have the expected number of axes (5: A, B, C, D, Z)
        if (n_axis < 5) {
            log_error("MaslowKinematics requires at least 5 axes");
            return false;
        }

        // Apply work area constraints to the target position
        // Calculate work area bounds
        float workWidth, workHeight;
        getWorkArea(workWidth, workHeight);
        float halfWidth  = workWidth / 2.0f;
        float halfHeight = workHeight / 2.0f;
        float minX       = -halfWidth + Maslow.workAreaCenterOffsetX;
        float maxX       = halfWidth + Maslow.workAreaCenterOffsetX;
        float minY       = -halfHeight + Maslow.workAreaCenterOffsetY;
        float maxY       = halfHeight + Maslow.workAreaCenterOffsetY;

        // Constrain X and Y to work area
        if (target[X_AXIS] < minX) {
            target[X_AXIS] = minX;
        } else if (target[X_AXIS] > maxX) {
            target[X_AXIS] = maxX;
        }

        if (target[Y_AXIS] < minY) {
            target[Y_AXIS] = minY;
        } else if (target[Y_AXIS] > maxY) {
            target[Y_AXIS] = maxY;
        }

        // Calculate cartesian distance of the move (X,Y,Z only)
        float cartesian_distance = vector_distance(target, position, 3);  // Only X,Y,Z for cartesian

        // Check if this is a Z-only move by examining X,Y changes
        float xy_distance    = sqrt((target[X_AXIS] - position[X_AXIS]) * (target[X_AXIS] - position[X_AXIS]) +
                                 (target[Y_AXIS] - position[Y_AXIS]) * (target[Y_AXIS] - position[Y_AXIS]));
        bool  is_z_only_move = (xy_distance < 0.001f);  // Consider moves < 0.001mm as Z-only

        // For long XY moves, segment the path to maintain belt length synchronization
        // This prevents linear interpolation in motor space from causing belt slack
        // Only segment if we're not already in a segmentation to prevent recursion
        // Apply to both feed moves and rapid moves to ensure consistent belt tension
        if (!_isSegmenting && !is_z_only_move && cartesian_distance > _maxSegmentLength) {
            // Calculate initial segments using base segment length
            uint16_t segments = uint16_t(ceilf(cartesian_distance / _maxSegmentLength));

            // For very long moves, ensure we don't exceed segment limit while maintaining reasonable segmentation
            if (segments > 1000) {
                // Cap at 1000 segments and adjust segment length accordingly
                segments = 1000;
            } else if (cartesian_distance > 100.0f && segments > 100) {
                // For long moves (>100mm), use finer segmentation to minimize belt slack
                // but ensure we don't create an excessive number of segments
                uint16_t desiredSegments = std::min(uint16_t(cartesian_distance / 2.0f), uint16_t(1000));
                segments                 = std::max(segments, desiredSegments);
            }

            if (segments > 1 && segments <= 1000) {  // Increased limit for better belt synchronization
                // Set flag to prevent recursion
                _isSegmenting = true;

                // Similar to arc segmentation in MotionControl.cpp
                // Multiply inverse feed_rate to compensate for the fact that this movement is approximated
                // by a number of discrete segments. The inverse feed_rate should be correct for the sum of
                // all segments.
                if (pl_data->motion.inverseTime) {
                    pl_data->feed_rate *= segments;
                    pl_data->motion.inverseTime = 0;  // Force as feed absolute mode over segments.
                }

                // Calculate increments per segment
                float increment_per_segment[MAX_N_AXIS];
                for (size_t axis = 0; axis < n_axis && axis < MAX_N_AXIS; axis++) {
                    increment_per_segment[axis] = (target[axis] - position[axis]) / segments;
                }

                // Current position for segmentation
                float segment_position[MAX_N_AXIS];
                for (size_t axis = 0; axis < n_axis && axis < MAX_N_AXIS; axis++) {
                    segment_position[axis] = position[axis];
                }

                float original_feedrate = pl_data->feed_rate;  // Save original for proper distribution

                // Submit each segment except the last one
                for (uint16_t i = 1; i < segments; i++) {
                    // Calculate intermediate target position
                    float intermediate_target[MAX_N_AXIS];
                    for (size_t axis = 0; axis < n_axis && axis < MAX_N_AXIS; axis++) {
                        intermediate_target[axis] = position[axis] + (increment_per_segment[axis] * i);
                    }

                    // Create a copy of plan data for this segment
                    plan_line_data_t segment_pl_data = *pl_data;
                    segment_pl_data.feed_rate        = original_feedrate;  // Reset to original before scaling

                    // Submit this segment to the motion controller in cartesian space
                    // This is similar to how arc segmentation works - use mc_linear()
                    // which will call cartesian_to_motors() for proper kinematics transformation
                    if (!mc_linear(intermediate_target, &segment_pl_data, segment_position)) {
                        return false;  // If any segment fails, fail the whole move
                    }

                    // Update segment position for next iteration
                    for (size_t axis = 0; axis < n_axis && axis < MAX_N_AXIS; axis++) {
                        segment_position[axis] = intermediate_target[axis];
                    }
                }

                // Fall through to handle the final segment to the target position
                // Update position to be the last segment position for final segment calculation
                for (size_t axis = 0; axis < n_axis && axis < MAX_N_AXIS; axis++) {
                    position[axis] = segment_position[axis];
                }

                // Reset feed rate for final segment
                pl_data->feed_rate = original_feedrate;

                // Clear the segmentation flag
                _isSegmenting = false;
            }
        }

        // Handle the final segment (or the entire move if no segmentation was needed)
        float motors[n_axis];
        transform_cartesian_to_motors(motors, target);

        // Feedrate scaling removed: feedrate now stays in XY coordinates
        // The machine will move at the set feedrate in XY coordinates rather than scaling to belt space

        return mc_move_motors(motors, pl_data);
    }

    void MaslowKinematics::motors_to_cartesian(float* cartesian, float* motors, axis_t n_axis) {
        /* 
        Forward kinematics for Maslow CNC - convert belt lengths back to X,Y,Z coordinates.
        
        With ABCDZX axis mapping:
        motors[0] = A axis = Top Left belt length
        motors[1] = B axis = Top Right belt length  
        motors[2] = C axis = Bottom Left belt length
        motors[3] = D axis = Bottom Right belt length
        motors[4] = Z axis = Router position
        motors[5] = X axis = (not used)
        */

        // The Z coordinate is straightforward - it's just the Z motor position
        cartesian[Z_AXIS] = motors[4];  // Z from Z axis (index 4 in ABCDZX)

        // For X,Y coordinates, we use the TL and TR belt lengths to solve the forward kinematics
        // We need to convert the raw belt lengths to XY plane distances first
        float tlBeltLength = motors[0];  // Top Left belt length (A axis)
        float trBeltLength = motors[1];  // Top Right belt length (B axis)

        // Calculate complete z-components including spoilboard and work thickness
        // This must match the z-component calculation used in forward kinematics
        float z        = motors[4];
        float tlTotalZ = 0.0f - (z + anchor_location[_TL][Coord_Z] + _spoilboardThickness + _workThickness);
        float trTotalZ = 0.0f - (z + anchor_location[_TR][Coord_Z] + _spoilboardThickness + _workThickness);

        // Convert angled belt measurements to XY plane distances using complete z-components
        float tlXYDistance = measurementToXYPlane(tlBeltLength, fabs(tlTotalZ));
        float trXYDistance = measurementToXYPlane(trBeltLength, fabs(trTotalZ));

        // Solve for X,Y position using intersection of circles
        float x, y;
        if (computeXYfromBeltLengths(tlXYDistance, trXYDistance, x, y) && !std::isnan(x) && !std::isnan(y)) {
            // Apply inverse scale factors to convert from scaled motor space back to cartesian space
            cartesian[X_AXIS] = x / Maslow.scaleX;
            cartesian[Y_AXIS] = y / Maslow.scaleY;
        } else {
            // If we can't solve the kinematics, fall back to (0,0)
            // This can happen if belt lengths are inconsistent or zero
            cartesian[X_AXIS] = 0.0f;
            cartesian[Y_AXIS] = 0.0f;
        }

        // Copy any additional axes directly (none expected beyond Z for now)
        for (int axis = 3; axis < n_axis && axis < MAX_N_AXIS; axis++) {
            if (axis < 3) {  // Only copy if within valid cartesian range
                cartesian[axis] = motors[axis];
            }
        }
    }

    bool MaslowKinematics::transform_cartesian_to_motors(float* motors, float* cartesian) {
        // In this implementation, FluidNC axis order is ABCDZX:
        // motors[0] = A axis = Top Left belt length
        // motors[1] = B axis = Top Right belt length
        // motors[2] = C axis = Bottom Left belt length
        // motors[3] = D axis = Bottom Right belt length
        // motors[4] = Z axis = Router position
        // motors[5] = X axis = (not used, keep as 0)

        // Extract X, Y, Z coordinates from cartesian space and apply scale factors
        float x = cartesian[X_AXIS] * Maslow.scaleX;  // Apply X scale factor
        float y = cartesian[Y_AXIS] * Maslow.scaleY;  // Apply Y scale factor
        float z = cartesian[Z_AXIS];                  // Z_AXIS = 2 (no scaling for Z)

        // Check if belts are ready to cut - if not, don't compute belt movements
        // This allows the Z-axis to move independently when belts are not calibrated
        if (Maslow.calibration.currentState == READY_TO_CUT) {
            // Compute belt lengths for each corner and assign to correct axis
            motors[0] = computeTL(x, y, z);  // Top Left -> A axis
            motors[1] = computeTR(x, y, z);  // Top Right -> B axis
            motors[2] = computeBL(x, y, z);  // Bottom Left -> C axis
            motors[3] = computeBR(x, y, z);  // Bottom Right -> D axis
        } else {
            // When belts are not ready, keep them at their current positions
            // This prevents the motion planner from synchronizing Z-axis with large belt movements
            motors[0] = steps_to_motor_pos(get_axis_steps(static_cast<axis_t>(0)), 0);  // Keep TL at current position
            motors[1] = steps_to_motor_pos(get_axis_steps(static_cast<axis_t>(1)), 1);  // Keep TR at current position
            motors[2] = steps_to_motor_pos(get_axis_steps(static_cast<axis_t>(2)), 2);  // Keep BL at current position
            motors[3] = steps_to_motor_pos(get_axis_steps(static_cast<axis_t>(3)), 3);  // Keep BR at current position
        }

        motors[4] = z;     // Z position -> Z axis (pass through)
        motors[5] = 0.0f;  // X axis not used

        // Handle any additional axes beyond the 6 we know about
        auto n_axis = config->_axes->_numberAxis;
        for (size_t axis = 6; axis < n_axis; axis++) {
            motors[axis] = cartesian[axis];
        }
        return true;
    }

    // Belt length calculation functions - moved from Maslow.cpp
    float MaslowKinematics::compute(int arm, float x, float y, float z) {
        // Move from lower left corner coordinates to centered coordinates
        x       = x + _centerX;
        y       = y + _centerY;
        float a = anchor_location[arm][Coord_X] - x;  // X dist from corner to router center
        float b = anchor_location[arm][Coord_Y] - y;  // Y dist from corner to router center
        // When fixedZ is true, don't use current Z position - only use fixed anchor Z values
        float effectiveZ = _fixedZ ? 0.0f : z;
        float c          = 0.0f - (effectiveZ + anchor_location[arm][Coord_Z] + _spoilboardThickness +
                          _workThickness);  // Z dist from corner to router center (includes material thickness)

        float XYlength = sqrt(a * a + b * b);  // Get the distance in the XY plane from the corner to the router center
        float XYBeltLength =
            XYlength - (_beltEndExtension + _armLength);           // Subtract the belt end extension and arm length to get the belt length
        float length = sqrt(XYBeltLength * XYBeltLength + c * c);  // Get the angled belt length

        return length;
    }

    bool MaslowKinematics::canHome(AxisMask axisMask) {
        // For Maslow CNC, homing is typically done by retracting all belts
        // until they reach full retraction, then calibrating the system
        return true;
    }

    // Forward kinematics - compute X,Y from belt lengths
    bool MaslowKinematics::computeXYfromBeltLengths(float tlLength, float trLength, float& x, float& y) const {
        // Find the intersection of two circles centered at TL and TR anchor points
        // with radii equal to the belt lengths

        double d = sqrt((anchor_location[_TL][Coord_X] - anchor_location[_TR][Coord_X]) *
                            (anchor_location[_TL][Coord_X] - anchor_location[_TR][Coord_X]) +
                        (anchor_location[_TL][Coord_Y] - anchor_location[_TR][Coord_Y]) *
                            (anchor_location[_TL][Coord_Y] - anchor_location[_TR][Coord_Y]));
        if (d > tlLength + trLength || d < abs(tlLength - trLength)) {
            // Don't spam the console when belts are at zero length - this is expected behavior
            if (!(tlLength == 0.0f || trLength == 0.0f)) {
                log_info("Unable to determine machine position from belt lengths");
            }
            return false;
        }

        double a    = (tlLength * tlLength - trLength * trLength + d * d) / (2 * d);
        double h    = sqrt(tlLength * tlLength - a * a);
        double x0   = anchor_location[_TL][Coord_X] + a * (anchor_location[_TR][Coord_X] - anchor_location[_TL][Coord_X]) / d;
        double y0   = anchor_location[_TL][Coord_Y] + a * (anchor_location[_TR][Coord_Y] - anchor_location[_TL][Coord_Y]) / d;
        double rawX = x0 + h * (anchor_location[_TR][Coord_Y] - anchor_location[_TL][Coord_Y]) / d;
        double rawY = y0 - h * (anchor_location[_TR][Coord_X] - anchor_location[_TL][Coord_X]) / d;

        // Adjust to the centered coordinates (convert from frame coordinates to centered coordinates)
        x = rawX - _centerX;
        y = rawY - _centerY;

        return true;
    }

    // Convert angled belt measurement to XY plane distance
    float MaslowKinematics::measurementToXYPlane(float measurement, float zHeight) const {
        float squaredDiff = measurement * measurement - zHeight * zHeight;
        if (squaredDiff < 0.0f) {
            // Belt length is shorter than z-height component - geometrically invalid.
            // Return 0 so computeXYfromBeltLengths will detect an impossible configuration
            // and fall back to a safe default position instead of producing NaN.
            return 0.0f;
        }
        float lengthInXY = sqrtf(squaredDiff);
        return lengthInXY + _beltEndExtension + _armLength;  // Add belt end extension and arm length
    }

    void MaslowKinematics::releaseMotors(AxisMask axisMask, MotorMask motors) {
        // Release the specified motors
        // This is handled by the base motor system
    }

    bool MaslowKinematics::limitReached(AxisMask& axisMask, MotorMask& motors, MotorMask limited) {
        // For Maslow CNC, limits are based on the frame boundaries and belt lengths
        // This is handled by the motor system and limit switches
        return false;
    }

    void MaslowKinematics::group(Configuration::HandlerBase& handler) {
        handler.item("tlX", anchor_location[_TL][Coord_X]);
        handler.item("tlY", anchor_location[_TL][Coord_Y]);
        handler.item("tlZ", anchor_location[_TL][Coord_Z]);
        handler.item("trX", anchor_location[_TR][Coord_X]);
        handler.item("trY", anchor_location[_TR][Coord_Y]);
        handler.item("trZ", anchor_location[_TR][Coord_Z]);
        handler.item("blX", anchor_location[_BL][Coord_X]);
        handler.item("blY", anchor_location[_BL][Coord_Y]);
        handler.item("blZ", anchor_location[_BL][Coord_Z]);
        handler.item("brX", anchor_location[_BR][Coord_X]);
        handler.item("brY", anchor_location[_BR][Coord_Y]);
        handler.item("brZ", anchor_location[_BR][Coord_Z]);
        handler.item("beltEndExtension", _beltEndExtension);
        handler.item("armLength", _armLength);
        handler.item("beltToothSpacing", _beltToothSpacing);
        handler.item("encoderTeeth", _encoderTeeth);
        handler.item("maxSegmentLength", _maxSegmentLength);
        handler.item("fixedZ", _fixedZ);
    }

    void MaslowKinematics::afterParse() {
        // Recalculate center coordinates after configuration has been loaded
        // This is important when calibration results are saved and reloaded
        calculateCenter();
        Maslow.setEncoderGeometry(_beltToothSpacing, _encoderTeeth);
        log_debug("Center coordinates recalculated after configuration load: X=" << _centerX << " Y=" << _centerY);
    }

    // Setter methods for calibration system to update frame parameters
    void MaslowKinematics::setFrameSize(float frameSize) {
        // Update anchor coordinates for a square frame of size frameSize x frameSize
        // Bottom anchors at Y=0, Top anchors at Y=frameSize
        // Left anchors at X=0, Right anchors at X=frameSize
        // Keep the same Z coordinates

        // Set X coordinates: left anchors at 0, right anchors at frameSize
        anchor_location[_BL][Coord_X] = 0.0f;
        anchor_location[_TL][Coord_X] = 0.0f;
        anchor_location[_BR][Coord_X] = frameSize;
        anchor_location[_TR][Coord_X] = frameSize;

        // Set Y coordinates: bottom anchors at 0, top anchors at frameSize
        anchor_location[_BL][Coord_Y] = 0.0f;
        anchor_location[_BR][Coord_Y] = 0.0f;
        anchor_location[_TL][Coord_Y] = frameSize;
        anchor_location[_TR][Coord_Y] = frameSize;

        // Recalculate center coordinates
        calculateCenter();
    }

    void MaslowKinematics::setCalibrationAnchors(float tlX, float tlY, float trX, float trY, float brX) {
        anchor_location[_TL][Coord_X] = tlX;
        anchor_location[_TL][Coord_Y] = tlY;
        anchor_location[_TR][Coord_X] = trX;
        anchor_location[_TR][Coord_Y] = trY;
        anchor_location[_BL][Coord_X] = 0.0f;
        anchor_location[_BL][Coord_Y] = 0.0f;
        anchor_location[_BR][Coord_X] = brX;
        anchor_location[_BR][Coord_Y] = 0.0f;
        calculateCenter();
    }

    void MaslowKinematics::setSpoilboardThickness(float thickness) {
        if (_spoilboardThickness != thickness) {
            _spoilboardThickness = thickness;
            log_info("Spoilboard thickness set to " << thickness << " mm");
        }
    }

    void MaslowKinematics::setWorkThickness(float thickness) {
        if (_workThickness != thickness) {
            _workThickness = thickness;
            log_info("Work thickness set to " << thickness << " mm");
        }
    }

    void MaslowKinematics::validate() {
        validateAndCorrectAnchorCoordinates();
    }

void MaslowKinematics::validateAndCorrectAnchorCoordinates() {
    const float TOLERANCE            = 0.1f;  // Allow small floating point differences
    bool        coordinatesCorrected = false;

    // Default reasonable values (rounded for clarity that these are placeholder values)
    const float DEFAULT_TLX = -30.0f;
    const float DEFAULT_TLY = 2100.0f;
    const float DEFAULT_TRX = 2950.0f;
    const float DEFAULT_TRY = 2100.0f;
    const float DEFAULT_BLX = 0.0f;
    const float DEFAULT_BLY = 0.0f;
    const float DEFAULT_BRX = 3000.0f;
    const float DEFAULT_BRY = 0.0f;

    // Check that blX, blY, and brY should be zero (or very close to zero)
    if (std::abs(anchor_location[_BL][Coord_X]) > TOLERANCE) {
        log_warn("Bottom left X coordinate (blX) should be 0.0, but is " << anchor_location[_BL][Coord_X] << ". Correcting to 0.0.");
        anchor_location[_BL][Coord_X] = 0.0f;
        coordinatesCorrected          = true;
    }

    if (std::abs(anchor_location[_BL][Coord_Y]) > TOLERANCE) {
        log_warn("Bottom left Y coordinate (blY) should be 0.0, but is " << anchor_location[_BL][Coord_Y] << ". Correcting to 0.0.");
        anchor_location[_BL][Coord_Y] = 0.0f;
        coordinatesCorrected          = true;
    }

    if (std::abs(anchor_location[_BR][Coord_Y]) > TOLERANCE) {
        log_warn("Bottom right Y coordinate (brY) should be 0.0, but is " << anchor_location[_BR][Coord_Y] << ". Correcting to 0.0.");
        anchor_location[_BR][Coord_Y] = 0.0f;
        coordinatesCorrected          = true;
    }

    // Check that tlX < trX (left should be to the left of right)
    if (anchor_location[_TL][Coord_X] >= anchor_location[_TR][Coord_X]) {
        log_warn("Top left X coordinate (tlX=" << anchor_location[_TL][Coord_X] << ") should be less than top right X coordinate (trX="
                                               << anchor_location[_TR][Coord_X] << "). Correcting to reasonable defaults.");
        anchor_location[_TL][Coord_X] = DEFAULT_TLX;
        anchor_location[_TR][Coord_X] = DEFAULT_TRX;
        coordinatesCorrected          = true;
    }

    // Check that top points are above bottom points
    if (anchor_location[_TL][Coord_Y] <= anchor_location[_BL][Coord_Y] || anchor_location[_TR][Coord_Y] <= anchor_location[_BR][Coord_Y]) {
        char* buffer = getLogBuffer();
        snprintf(buffer,
                 1400,
                 "Top anchor points should be above bottom anchor points. tlY=%g should be > blY=%g, trY=%g should be > brY=%g. "
                 "Correcting to reasonable defaults.",
                 anchor_location[_TL][Coord_Y],
                 anchor_location[_BL][Coord_Y],
                 anchor_location[_TR][Coord_Y],
                 anchor_location[_BR][Coord_Y]);
        log_warn(buffer);
        releaseLogBuffer();
        anchor_location[_TL][Coord_Y] = DEFAULT_TLY;
        anchor_location[_TR][Coord_Y] = DEFAULT_TRY;
        coordinatesCorrected          = true;
    }

    // Check side lengths - minimum 400mm, maximum 5500mm
    const float MIN_SIDE_LENGTH = 400.0f;
    const float MAX_SIDE_LENGTH = 5500.0f;

    // Calculate distances for each side of the frame
    float topSideLength = sqrt(
        (anchor_location[_TR][Coord_X] - anchor_location[_TL][Coord_X]) * (anchor_location[_TR][Coord_X] - anchor_location[_TL][Coord_X]) +
        (anchor_location[_TR][Coord_Y] - anchor_location[_TL][Coord_Y]) * (anchor_location[_TR][Coord_Y] - anchor_location[_TL][Coord_Y]));
    float rightSideLength = sqrt(
        (anchor_location[_BR][Coord_X] - anchor_location[_TR][Coord_X]) * (anchor_location[_BR][Coord_X] - anchor_location[_TR][Coord_X]) +
        (anchor_location[_BR][Coord_Y] - anchor_location[_TR][Coord_Y]) * (anchor_location[_BR][Coord_Y] - anchor_location[_TR][Coord_Y]));
    float bottomSideLength = sqrt(
        (anchor_location[_BR][Coord_X] - anchor_location[_BL][Coord_X]) * (anchor_location[_BR][Coord_X] - anchor_location[_BL][Coord_X]) +
        (anchor_location[_BR][Coord_Y] - anchor_location[_BL][Coord_Y]) * (anchor_location[_BR][Coord_Y] - anchor_location[_BL][Coord_Y]));
    float leftSideLength = sqrt(
        (anchor_location[_TL][Coord_X] - anchor_location[_BL][Coord_X]) * (anchor_location[_TL][Coord_X] - anchor_location[_BL][Coord_X]) +
        (anchor_location[_TL][Coord_Y] - anchor_location[_BL][Coord_Y]) * (anchor_location[_TL][Coord_Y] - anchor_location[_BL][Coord_Y]));

    // Check if any side length is outside the valid range
    if (topSideLength < MIN_SIDE_LENGTH || topSideLength > MAX_SIDE_LENGTH || rightSideLength < MIN_SIDE_LENGTH ||
        rightSideLength > MAX_SIDE_LENGTH || bottomSideLength < MIN_SIDE_LENGTH || bottomSideLength > MAX_SIDE_LENGTH ||
        leftSideLength < MIN_SIDE_LENGTH || leftSideLength > MAX_SIDE_LENGTH) {
        // Frame dimensions are out of bounds - this is a critical error that cannot be auto-corrected
        // Operating with incorrect anchor points could damage the machine
        char* buffer = getLogBuffer();
        snprintf(buffer,
                 1400,
                 "Frame side lengths are outside valid range (400-5500mm). "
                 "Top=%gmm, Right=%gmm, Bottom=%gmm, Left=%gmm. Calibration cannot proceed with these dimensions.",
                 topSideLength,
                 rightSideLength,
                 bottomSideLength,
                 leftSideLength);
        log_error(buffer);
        releaseLogBuffer();
        String errorMsg = "Frame dimensions out of bounds. Top=" + String(topSideLength, 1) + "mm, Right=" + String(rightSideLength, 1) +
                          "mm, Bottom=" + String(bottomSideLength, 1) + "mm, Left=" + String(leftSideLength, 1) + "mm";
        Maslow.eStop(errorMsg);
    }

    // Sanity check for reasonable coordinate values (not negative for most coordinates, not excessively large)
    const float MAX_REASONABLE_COORD = 10000.0f;  // 10 meters should be more than enough for any Maslow frame

    if (anchor_location[_TL][Coord_Y] < 0 || anchor_location[_TR][Coord_Y] < 0 || anchor_location[_TL][Coord_Y] > MAX_REASONABLE_COORD ||
        anchor_location[_TR][Coord_Y] > MAX_REASONABLE_COORD || anchor_location[_BL][Coord_X] < 0 || anchor_location[_BR][Coord_X] < 0 ||
        anchor_location[_BR][Coord_X] > MAX_REASONABLE_COORD) {
        log_warn("Anchor coordinates contain unrealistic values. Resetting to reasonable defaults.");
        anchor_location[_TL][Coord_X] = DEFAULT_TLX;
        anchor_location[_TL][Coord_Y] = DEFAULT_TLY;
        anchor_location[_TR][Coord_X] = DEFAULT_TRX;
        anchor_location[_TR][Coord_Y] = DEFAULT_TRY;
        anchor_location[_BL][Coord_X] = DEFAULT_BLX;
        anchor_location[_BL][Coord_Y] = DEFAULT_BLY;
        anchor_location[_BR][Coord_X] = DEFAULT_BRX;
        anchor_location[_BR][Coord_Y] = DEFAULT_BRY;
        coordinatesCorrected          = true;
    }

    if (coordinatesCorrected) {
        char* buffer = getLogBuffer();
        snprintf(buffer,
                 1400,
                 "Anchor coordinates corrected. New values: tlX=%g tlY=%g trX=%g trY=%g blX=%g blY=%g brX=%g brY=%g",
                 anchor_location[_TL][Coord_X],
                 anchor_location[_TL][Coord_Y],
                 anchor_location[_TR][Coord_X],
                 anchor_location[_TR][Coord_Y],
                 anchor_location[_BL][Coord_X],
                 anchor_location[_BL][Coord_Y],
                 anchor_location[_BR][Coord_X],
                 anchor_location[_BR][Coord_Y]);
        log_info(buffer);
        releaseLogBuffer();
        // Recalculate center coordinates after correction
        calculateCenter();
    }
}

// Destructor - clear global pointer
MaslowKinematics::~MaslowKinematics() {
    if (g_maslowKinematics == this) {
        g_maslowKinematics = nullptr;
    }
}

// Configuration registration
namespace {
    KinematicsFactory::InstanceBuilder<MaslowKinematics> registration("MaslowKinematics");
}

// Global accessor function to get the current MaslowKinematics instance
MaslowKinematics* getMaslowKinematics() {
    return g_maslowKinematics;
}
}
