MaslowCNC/Maslow_4/firmware/FluidNC/src/MotionControl.cpp

// Copyright (c) 2014-2016 Sungeun K. Jeon for Gnea Research LLC
// Copyright (c) 2009-2011 Simen Svale Skogsrud
// Copyright (c) 2018 -	Bart Dring
// Use of this source code is governed by a GPLv3 license that can be found in the LICENSE file.

#include "MotionControl.h"

#include "Machine/MachineConfig.h"
#include "Machine/Homing.h"  // run_cycles
#include "Limit.h"           // limits_soft_check
#include "Report.h"          // report_over_counter
#include "Protocol.h"        // protocol_execute_realtime
#include "Planner.h"         // plan_reset, etc
#include "Platform.h"        // WEAK_LINK
#include "Settings.h"        // coords
#include "State.h"           // State

#include <cmath>

// M_PI is not defined in standard C/C++ but some compilers
// support it anyway.  The following suppresses Intellisense
// problem reports.
#ifndef M_PI
#    define M_PI 3.14159265358979323846
#endif

// mc_pl_data_inflight keeps track of a jog command sent to mc_move_motors() so we can cancel it.
// this is needed if a jogCancel comes along after we have already parsed a jog and it is in-flight.
static volatile void* mc_pl_data_inflight;  // holds a plan_line_data_t while mc_move_motors has taken ownership of a line motion

static volatile bool mc_drop_motion = false;  // see mc_set_drop_motion()
void                 mc_set_drop_motion(bool drop) {
    mc_drop_motion = drop;
}

void mc_init() {
    mc_pl_data_inflight = NULL;
}

// Execute linear motor motion in absolute millimeter coordinates. Feed rate given in
// millimeters/second unless invert_feed_rate is true.
// Then the feed_rate means that the motion should be completed in (1 minute)/feed_rate time.
//
// NOTE: This operates in the motor space rather than cartesian space. If a cartesian linear motion
// is desired, please see mc_linear() which will translate from cartesian to motor operations via
// kinematics.
//
// NOTE: This is the primary gateway to the planner. All line motions, including arc line
// segments, must pass through this routine before being passed to the planner. The separation of
// mc_linear and plan_buffer_line is done primarily to place non-planner-type functions from being
// in the planner and to let backlash compensation or canned cycle integration simple and direct.
// returns true if line was submitted to planner, or false if intentionally dropped.
bool mc_move_motors(float* target, plan_line_data_t* pl_data) {
    bool submitted_result = false;
    // A paused job was stopped: the rest of the line it was in the middle of must not move.
    if (mc_drop_motion) {
        return submitted_result;
    }
    // store the plan data so it can be cancelled by the protocol system if needed
    mc_pl_data_inflight = pl_data;

    // If in check gcode mode, prevent motion by blocking planner. Soft limits still work.
    if (state_is(State::CheckMode)) {
        mc_pl_data_inflight = NULL;
        return submitted_result;  // Bail, if system abort.
    }
    // NOTE: Backlash compensation may be installed here. It will need direction info to track when
    // to insert a backlash line motion(s) before the intended line motion and will require its own
    // plan_check_full_buffer() and check for system abort loop. Also for position reporting
    // backlash steps will need to be also tracked, which will need to be kept at a system level.
    // There are likely some other things that will need to be tracked as well. However, we feel
    // that backlash compensation should NOT be handled by the firmware itself, because there are a myriad
    // of ways to implement it and can be effective or ineffective for different CNC machines. This
    // would be better handled by the interface as a post-processor task, where the original g-code
    // is translated and inserts backlash motions that best suits the machine.
    // NOTE: Perhaps as a middle-ground, all that needs to be sent is a flag or special command that
    // indicates to the firmware what is a backlash compensation motion, so that the move is executed
    // without updating the machine position values. Since the position values used by the g-code
    // parser and planner are separate from the system machine positions, this is doable.
    // If the buffer is full: good! That means we are well ahead of the robot.
    // Remain in this loop until there is room in the buffer.

    while (plan_check_full_buffer()) {
        // While we are waiting for room in the buffer, look for realtime
        // commands and other situations that could cause state changes.
        protocol_execute_realtime();
        protocol_auto_cycle_start();  // Auto-cycle start when buffer is full.
        if (sys.abort() || mc_drop_motion) {
            mc_pl_data_inflight = NULL;
            return submitted_result;  // Bail, if system abort or the job was stopped.
        }
    }

    // Plan and queue motion into planner buffer
    if (mc_pl_data_inflight == pl_data && !mc_drop_motion) {
        plan_buffer_line(target, pl_data);
        submitted_result = true;
    }
    mc_pl_data_inflight = NULL;
    return submitted_result;
}

void mc_cancel_jog() {
    if (mc_pl_data_inflight != NULL && ((plan_line_data_t*)mc_pl_data_inflight)->is_jog) {
        mc_pl_data_inflight = NULL;
    }
}

// Execute linear motion in absolute millimeter coordinates. Feed rate given in millimeters/second
// unless invert_feed_rate is true. Then the feed_rate means that the motion should be completed in
// (1 minute)/feed_rate time.

// mc_linear_no_check() is used by mc_arc() which pre-checks the arc limits using
// a fast algorithm, so checking each segment is unnecessary.
static bool mc_linear_no_check(float* target, plan_line_data_t* pl_data, float* position) {
    return config->_kinematics->cartesian_to_motors(target, pl_data, position);
}
bool mc_linear(float* target, plan_line_data_t* pl_data, float* position) {
    if (!pl_data->is_jog && !pl_data->limits_checked) {  // soft limits for jogs have already been dealt with
        if (config->_kinematics->invalid_line(target)) {
            return false;
        }
    }
    return mc_linear_no_check(target, pl_data, position);
}

// Execute an arc in offset mode format. position == current xyz, target == target xyz,
// offset == offset from current xyz, axis_X defines circle plane in tool space, axis_linear is
// the direction of helical travel, radius == circle radius, isclockwise boolean. Used
// for vector transformation direction.
// The arc is approximated by generating a huge number of tiny, linear segments. The chordal tolerance
// of each segment is configured in the arc_tolerance setting, which is defined to be the maximum normal
// distance from segment to the circle when the end points both lie on the circle.
void mc_arc(float*            target,
            plan_line_data_t* pl_data,
            float*            position,
            float*            offset,
            float             radius,
            axis_t            axis_0,
            axis_t            axis_1,
            axis_t            axis_linear,
            bool              is_clockwise_arc,
            uint32_t          rotations) {
    float center[3] = { position[axis_0] + offset[axis_0], position[axis_1] + offset[axis_1], 0 };

    // The first two axes are the circle plane and the third is the orthogonal plane
    axis_t caxes[3] = { axis_0, axis_1, axis_linear };
    if (config->_kinematics->invalid_arc(target, pl_data, position, center, radius, caxes, is_clockwise_arc, rotations)) {
        return;
    }

    // Radius vector from center to current location
    float radii[2] = { -offset[axis_0], -offset[axis_1] };
    float rt[2]    = { target[axis_0] - center[0], target[axis_1] - center[1] };

    auto n_axis = Axes::_numberAxis;

    float previous_position[MAX_N_AXIS] = { 0.0f };
    for (size_t i = 0; i < n_axis; i++) {
        previous_position[i] = position[i];
    }

    // CCW angle between position and target from circle center. Only one atan2() trig computation required.
    float angular_travel = atan2f(radii[0] * rt[1] - radii[1] * rt[0], radii[0] * rt[0] + radii[1] * rt[1]);
    if (is_clockwise_arc) {  // Correct atan2 output per direction
        if (angular_travel >= -ARC_ANGULAR_TRAVEL_EPSILON) {
            angular_travel -= 2 * float(M_PI);
        }
        // See https://linuxcnc.org/docs/2.6/html/gcode/gcode.html#sec:G2-G3-Arc
        // The P word specifies the number of extra rotations.  Missing P, P0 or P1
        // is just the programmed arc.  Pn adds n-1 rotations
        if (rotations > 1) {
            angular_travel -= (rotations - 1) * 2 * float(M_PI);
        }
    } else {
        if (angular_travel <= ARC_ANGULAR_TRAVEL_EPSILON) {
            angular_travel += 2 * float(M_PI);
        }
        if (rotations > 1) {
            angular_travel += (rotations - 1) * 2 * float(M_PI);
        }
    }

    // NOTE: Segment end points are on the arc, which can lead to the arc diameter being smaller by up to
    // (2x) arc_tolerance. For 99% of users, this is just fine. If a different arc segment fit
    // is desired, i.e. least-squares, midpoint on arc, just change the mm_per_arc_segment calculation.
    // For most uses, this value should not exceed 2000.
    uint16_t segments =
        uint16_t(floorf(fabsf(0.5F * angular_travel * radius) / sqrtf(config->_arcTolerance * (2 * radius - config->_arcTolerance))));
    if (segments) {
        // Multiply inverse feed_rate to compensate for the fact that this movement is approximated
        // by a number of discrete segments. The inverse feed_rate should be correct for the sum of
        // all segments.
        if (pl_data->motion.inverseTime) {
            pl_data->feed_rate *= segments;
            pl_data->motion.inverseTime = 0;  // Force as feed absolute mode over arc segments.
        }
        float theta_per_segment = angular_travel / segments;
        float linear_per_segment[MAX_N_AXIS];
        linear_per_segment[axis_linear] = (target[axis_linear] - position[axis_linear]) / segments;
        for (size_t i = A_AXIS; i < n_axis; i++) {
            linear_per_segment[i] = (target[i] - position[i]) / segments;
        }
        /* Vector rotation by transformation matrix: r is the original vector, r_T is the rotated vector,
           and phi is the angle of rotation. Solution approach by Jens Geisler.
               r_T = [cos(phi) -sin(phi);
                      sin(phi)  cos(phi] * r ;

           For arc generation, the center of the circle is the axis of rotation and the radius vector is
           defined from the circle center to the initial position. Each line segment is formed by successive
           vector rotations. Single precision values can accumulate error greater than tool precision in rare
           cases. So, exact arc path correction is implemented. This approach avoids the problem of too many very
           expensive trig operations [sin(),cos(),tan()] which can take 100-200 usec each to compute.

           Small angle approximation may be used to reduce computation overhead further. A third-order approximation
           (second order sin() has too much error) holds for most, if not, all CNC applications. Note that this
           approximation will begin to accumulate a numerical drift error when theta_per_segment is greater than
           ~0.25 rad(14 deg) AND the approximation is successively used without correction several dozen times. This
           scenario is extremely unlikely, since segment lengths and theta_per_segment are automatically generated
           and scaled by the arc tolerance setting. Only a very large arc tolerance setting, unrealistic for CNC
           applications, would cause this numerical drift error. However, it is best to set N_ARC_CORRECTION from a
           low of ~4 to a high of ~20 or so to avoid trig operations while keeping arc generation accurate.

           This approximation also allows mc_arc to immediately insert a line segment into the planner
           without the initial overhead of computing cos() or sin(). By the time the arc needs to be applied
           a correction, the planner should have caught up to the lag caused by the initial mc_arc overhead.
           This is important when there are successive arc motions.
        */
        // Computes: cos_T = 1 - theta_per_segment^2/2, sin_T = theta_per_segment - theta_per_segment^3/6) in ~52usec
        float cos_T = 2.0f - theta_per_segment * theta_per_segment;
        float sin_T = theta_per_segment * 0.16666667f * (cos_T + 4.0f);
        cos_T *= 0.5;
        float    sin_Ti;
        float    cos_Ti;
        uint16_t i;
        size_t   count             = 0;
        float    original_feedrate = pl_data->feed_rate;  // Kinematics may alter the feedrate, so save an original copy
        for (i = 1; i < segments; i++) {                  // Increment (segments-1).
            if (count < N_ARC_CORRECTION) {
                // Apply vector rotation matrix. ~40 usec
                float ri = radii[0] * sin_T + radii[1] * cos_T;
                radii[0] = radii[0] * cos_T - radii[1] * sin_T;
                radii[1] = ri;
                count++;
            } else {
                // Arc correction to radius vector. Computed only every N_ARC_CORRECTION increments. ~375 usec
                // Compute exact location by applying transformation matrix from initial radius vector(=-offset).
                cos_Ti   = cosf(i * theta_per_segment);
                sin_Ti   = sinf(i * theta_per_segment);
                radii[0] = -offset[axis_0] * cos_Ti + offset[axis_1] * sin_Ti;
                radii[1] = -offset[axis_0] * sin_Ti - offset[axis_1] * cos_Ti;
                count    = 0;
            }
            // Update arc_target location
            position[axis_0] = center[0] + radii[0];
            position[axis_1] = center[1] + radii[1];
            position[axis_linear] += linear_per_segment[axis_linear];
            for (size_t i = A_AXIS; i < n_axis; i++) {
                position[i] += linear_per_segment[i];
            }
            pl_data->feed_rate = original_feedrate;  // This restores the feedrate kinematics may have altered
            mc_linear(position, pl_data, previous_position);
            previous_position[axis_0]      = position[axis_0];
            previous_position[axis_1]      = position[axis_1];
            previous_position[axis_linear] = position[axis_linear];
            // Bail mid-circle on system abort. Runtime command check already performed by mc_linear.

            if (sys.abort() || state_is(State::Alarm)) {
                return;
            }
        }
    }
    // Ensure last segment arrives at target location.
    mc_linear(target, pl_data, previous_position);
}

// Execute dwell in seconds.
bool mc_dwell(int32_t milliseconds) {
    if (milliseconds < 0 || state_is(State::CheckMode)) {
        return false;
    }
    protocol_buffer_synchronize();
    return dwell_ms(milliseconds, DwellMode::Dwell);
}

volatile bool probing;

bool probe_succeeded = false;

// Perform tool length probe cycle. Requires probe switch.
// NOTE: Upon probe failure, the program will be stopped and placed into ALARM state.
GCUpdatePos mc_probe_cycle(float* target, plan_line_data_t* pl_data, bool away, bool no_error, AxisMask offsetAxis, float offset) {
    if (!config->_probe->exists()) {
        log_error("Probe pin is not configured");
        return GCUpdatePos::None;
    }
    // TODO: Need to update this cycle so it obeys a non-auto cycle start.
    if (state_is(State::CheckMode)) {
        return config->_probe->_check_mode_start ? GCUpdatePos::None : GCUpdatePos::Target;
    }
    // Finish all queued commands and empty planner buffer before starting probe cycle.
    protocol_buffer_synchronize();
    if (sys.abort()) {
        return GCUpdatePos::None;  // Return if system reset has been issued.
    }

    Stepping::beginLowLatency();

    // Initialize probing control variables
    probe_succeeded = false;  // Re-initialize probe history before beginning cycle.
    config->_probe->set_direction(away);
    // After syncing, check if probe is already triggered. If so, halt and issue alarm.
    // NOTE: This probe initialization error applies to all probing cycles.
    if (config->_probe->tripped()) {
        send_alarm(ExecAlarm::ProbeFailInitial);
        protocol_execute_realtime();
        Stepping::endLowLatency();
        return GCUpdatePos::None;  // Nothing else to do but bail.
    }
    // Setup and queue probing motion. Auto cycle-start should not start the cycle.
    mc_linear(target, pl_data, gc_state.position);
    // Activate the probing state monitor in the stepper module.
    probing = true;
    // Perform probing cycle. Wait here until probe is triggered or motion completes.
    protocol_send_event(&cycleStartEvent);
    do {
        protocol_execute_realtime();
        if (sys.abort()) {
            Stepping::endLowLatency();
            return GCUpdatePos::None;  // Check for system abort
        }
    } while (!state_is(State::Idle));

    Stepping::endLowLatency();

    // Probing cycle complete!
    // Set state variables and error out, if the probe failed and cycle with error is enabled.
    if (probing) {
        if (no_error) {
            get_steps(probe_steps);
        } else {
            send_alarm(ExecAlarm::ProbeFailContact);
        }
    } else {
        probe_succeeded = true;  // Indicate to system the probing cycle completed successfully.
    }
    probing = false;              // Ensure probe state monitor is disabled.
    protocol_execute_realtime();  // Check and execute run-time commands
    // Reset the stepper and planner buffers to remove the remainder of the probe motion.
    Stepper::reset();      // Reset step segment buffer.
    plan_reset();          // Reset planner buffer. Zero planner positions. Ensure probing motion is cleared.
    plan_sync_position();  // Sync planner position to current machine position.
    if (MESSAGE_PROBE_COORDINATES) {
        // All done! Output the probe position as message.
        report_probe_parameters(allChannels);
    }

    if (probe_succeeded) {
        if (offset != __FLT_MAX__) {
            auto  n_axis = Axes::_numberAxis;
            float coord_data[MAX_N_AXIS];
            float probe_contact[MAX_N_AXIS];

            steps_to_mpos(probe_contact, probe_steps);
            coords[gc_state.modal.coord_select]->get(coord_data);  // get a copy of the current coordinate offsets
            for (axis_t axis = X_AXIS; axis < n_axis; axis++) {    // find the axis specified. There should only be one.
                if (offsetAxis & (1 << axis)) {
                    coord_data[axis] = probe_contact[axis] - offset;
                    break;
                }
            }
            log_info("Probe offset applied:");
            coords[gc_state.modal.coord_select]->set(coord_data);  // save it
            copyAxes(gc_state.coord_system, coord_data);
            report_wco_counter = 0;
        }

        return GCUpdatePos::System;  // Successful probe cycle.
    } else {
        return GCUpdatePos::Target;  // Failed to trigger probe within travel. With or without error.
    }
}

void mc_override_ctrl_update(Override override_state) {
    // Finish all queued commands before altering override control state
    protocol_buffer_synchronize();
    if (sys.abort()) {
        return;
    }
    sys.set_override_ctrl(override_state);
}

// Method to ready the system to reset by setting the realtime reset command and killing any
// active processes in the system. This also checks if a system reset is issued while in
// motion state. If so, kills the steppers and sets the system alarm to flag position
// lost, since there was an abrupt uncontrolled deceleration. Called at an interrupt level by
// realtime abort command and hard limits. So, keep to a minimum.
void mc_critical(ExecAlarm alarm) {
    if (inMotionState() || sys.step_control.executeHold || sys.step_control.executeSysMotion) {
        Stepper::reset();  // Stop stepping immediately, possibly losing position
        //        Stepper::stop_stepping();  // Stop stepping immediately, possibly losing position
    }
    send_alarm(alarm);
}
