MaslowCNC/Maslow_4/firmware/FluidNC/src/Maslow/Maslow.h

// Copyright (c) 2024 Maslow CNC. All rights reserved.
// Use of this source code is governed by a GPLv3 license that can be found in the LICENSE file with
// following exception: it may not be used for any reason by MakerMade or anyone with a business or personal connection to MakerMade

#pragma once
#include <Arduino.h>
#include <string>
#include "MaslowEnums.h"
#include "MotorUnit.h"
#include "Calibration.h"
#include "../System.h"  // sys.*
#include "../Planner.h"
#include <nvs.h>
#include "FreeRTOS.h"
#include "semphr.h"

#define TCAADDR 0x70

// Set to 1 to bench-test the controller without motors and encoders attached.
// When 1, the boot self-test does not latch an error for missing hardware, and
// the runtime encoder-read watchdog is suppressed (no spammy failure warnings and
// no panic when encoders cannot be read). Set back to 0 for normal operation.
#ifndef MASLOW_DISABLE_BOOT_SELFTEST
#    define MASLOW_DISABLE_BOOT_SELFTEST 0
#endif

#define CALIBRATION_GRID_SIZE_MAX (10 * 10) + 2

#define MASLOW_TELEM_FILE "M4_telemetry.bin"

// Common Default strings - especially used by config
const std::string M = "Maslow";
// Non-volatile storage name
//const char * nvs_t = "maslow";

struct TelemetryFileHeader {
    unsigned int structureSize;  // 4 bytes
    char         version[10];    // 10
    // if you add to the header take bytes from this
    char _unused[64];  // 64 bytes
};

struct TelemetryData {
    unsigned long timestamp;
    // motors - indexed by MaslowArm enum
    double Current[ARM_COUNT];
    double Power[ARM_COUNT];
    double Speed[ARM_COUNT];
    double Pos[ARM_COUNT];
    int    State[ARM_COUNT];
    bool   extended[ARM_COUNT];

    bool extendingALL;
    bool complyALL;
    bool takeSlack;

    bool   safetyOn;
    double targetX;
    double targetY;
    double targetZ;
    double x;
    double y;
    double z;

    bool          test;
    int           pointCount;
    int           waypoint;
    int           calibrationGridSize;
    unsigned long holdTimer;
    bool          holding;
    unsigned long holdTime;
    float         centerX;
    float         centerY;
    unsigned long lastCallToPID;
    unsigned long lastMiss;
    unsigned long lastCallToUpdate;
    unsigned long extendCallTimer;
    unsigned long complyCallTimer;
    unsigned int  panicCount;
};

class Maslow_ {
private:
    Maslow_() = default;  // Make constructor private

public:
    static Maslow_& getInstance();  // Accessor for singleton instance

    Maslow_(const Maslow_&)            = delete;  // no copying
    Maslow_& operator=(const Maslow_&) = delete;

public:
    //main utility functions
    void   begin(void (*sys_rt)());
    void   update();
    void   blinkIPAddress();
    void   print_motor_currents();
    bool   updateEncoderPositions();
    void   setTargets(float xTarget, float yTarget, float zTarget, bool tl = true, bool tr = true, bool bl = true, bool br = true);
    void   setEncoderGeometry(float beltToothSpacing, float encoderTeeth);
    double getTargetX();
    double getTargetY();
    double getTargetZ();
    void   recomputePID();

    //Save and load z-axis position, set z-stop
    void saveZPos();
    void loadZPos();
    void logLoadZPosDebug();
    /** Sets the 'bottom' Z position, this is a 'stop' beyond which travel cannot continue */
    void setZStop();

    //Save and load belt positions
    void saveBeltPositions();
    void loadBeltPositions();
    void markBeltPositionsStale();

    void stopMotors();
    /** Switches the spindle off as M5 would (used by every stop path) */
    void stopSpindle();
    /** Raises Z axis to Z home + 2mm to prevent workpiece damage after stop */
    void raiseZ();
    // The non-blocking first half of raiseZ(): end the job, clear the planner and stepper, hold the
    // belts where they are, clear any feed hold and go Idle.  Safe to call from inside the hold.
    void haltMotion();
    // Make the belt step counts match the encoders and clear the belt PIDs, so the next move
    // starts from where the belts really are.  Call with stepping stopped.
    void syncBeltsToEncoders();
    // True if this belt's length is known (see Maslow.cpp); reported in the status report's BL.
    bool beltLengthKnown(int arm);
    // Belts whose saved length was restored at boot (loadBeltPositions); each is checked alone.
    bool beltRestored[ARM_COUNT] = { false, false, false, false };
    // The belt lengths and encoder angles saved in NVS, as read at boot.  Apply Tension from
    // UNKNOWN uses them to restore the belts that weren't restored at boot.
    float   savedBeltPos[ARM_COUNT]       = { 0, 0, 0, 0 };
    int32_t savedBeltAngle[ARM_COUNT]     = { 0, 0, 0, 0 };
    bool    savedBeltAvailable[ARM_COUNT] = { false, false, false, false };
    bool    savedAngleAvailable[ARM_COUNT] = { false, false, false, false };
    // Restore one belt's length from its saved value if its encoder is within 1/4 turn of the
    // saved angle (the difference is added).  Returns false, leaving the belt alone, otherwise.
    bool restoreBeltFromSaved(int arm);
    // Whether Apply Tension can recover the unknown belts from UNKNOWN; if not, why.
    bool beltRecoveryPossible(std::string& why);

    void   stop();
    void   eStop(String message = "Emergency stop triggered.");
    void   panic();
    void   resetUpdateWatchdog();
    unsigned long lastUpdateMs() const { return lastCallToUpdate; }  // millis() of the last update() or watchdog reset

    /** Clears a latched error or watchdog condition and turns the red LED off.
     *  Called when the user clears the alarm with $X.  Returns true if a latched
     *  condition was actually cleared.  Before this existed both latches were
     *  permanent and the only recovery was a power cycle. */
    bool   clearError();

    /** True while a latched error or a fired watchdog is making update() return before the
     *  motion state machine runs.  Commands that start motion ask this first: without it
     *  they are accepted, switch the state to Homing, and then sit there forever because
     *  nothing downstream ever runs. */
    bool   motionBlocked() const { return error || watchdogFired; }

    /** Why motion is blocked, phrased for the user and ending in the recovery step. */
    String motionBlockedReason() const;

    // Set true during file/firmware uploads to suppress the update-loop watchdog.
    // Flash write operations stall both CPU cores; without this flag the 100 ms
    // watchdog fires spuriously and latches the red LED until a power cycle.
    volatile bool uploadInProgress = false;
    String axis_id_to_label(int axis_id);
    void   safety_control();
    bool   axis_homed[4] = { false, false, false, false };

    bool extended[ARM_COUNT] = { false, false, false, false };

    bool takeSlack = false;

    bool safetyOn = true;

    Calibration calibration;

    void getInfo();
    bool telemetry_enabled = false;
    // TODO: probably need to use this for all fields in telemetry, but we'll try without first
    // SemaphoreHandle_t telemetry_mutex = xSemaphoreCreateMutex();
    TelemetryData get_telemetry_data();
    // turns on or off telemetry gathering
    void set_telemetry(bool enabled);
    void dump_telemetry(const char* filename);
    // writes whatever is in teh telemetry buffer to SD card
    void write_telemetry_buffer(uint8_t* buffer, size_t length);

    //These are the current targets set by the setTargets function used for moving the machine during normal operations
    double targetX = 0;
    double targetY = 0;
    double targetZ = 0;

    MotorUnit axis[ARM_COUNT];

    bool readingFromSD = false;  //Used to turn off reading from the encoders when reading from the - i dont think we need this anymore TODO
    bool using_default_config = false;
    // Set once begin() has completed; update() is a no-op before that because
    // protocol_execute_realtime() can pump update() during setup, before the
    // I2C bus and motor units exist.
    bool initialized = false;
    // Diagnostics: how many times update() has run, and how far it got
    volatile uint32_t updateCount = 0;
    volatile uint32_t homeCallCount = 0;

    // Consumed by the Maslow web UI / updater; parsed here so the keys in
    // maslow.yaml are recognized by the config system.
    bool        autoUpdate = true;
    std::string updateURL  = "";
    QWIICMUX I2CMux;

    bool   error = false;
    String errorMessage;
    // errorMessage used to be wiped as soon as it was logged, which left nothing to tell the
    // user why motion was refused minutes later.  Keep the text and track the logging
    // separately so the reason survives for as long as the latch does.
    bool errorMessageLogged = false;

    void test_();
    void reset_all_axis();
    //keep track of where Maslow actually is
    double x;
    double y;
    float  scaleX = 1.0;
    float  scaleY = 1.0;

    // Work area constraints. 0 (the default) sizes that axis from the frame, see MaslowKinematics::getWorkArea()
    float workAreaX             = 0.0;
    float workAreaY             = 0.0;
    float workAreaCenterOffsetX = 0.0;
    float workAreaCenterOffsetY = 0.0;

    // Park position (machine coordinates, Z moved first)
    float parkZ = 2.0;
    float parkX = 0.0;
    float parkY = 0.0;

    // Dust collection fan speed (0-100, 0 = off) used whenever the fan runs: during moves and
    // while the spindle is on.  Streamed live to the spindle board, so changes apply at once.
    int32_t dustFanSpeed = 100;

    bool test         = false;
    bool debugEnabled = false;

private:
    //Used to keep track of how often the PID controller is updated
    unsigned long lastCallToPID    = millis();
    unsigned long lastMiss         = millis();
    unsigned long lastCallToUpdate = millis();
    unsigned long extendCallTimer  = millis();
    unsigned long complyCallTimer  = millis();
    unsigned int  panicCount       = 0;
    bool          watchdogFired    = false;

    //Servo fault pin state, so the fault is reported when it starts and ends rather than every PID cycle
    bool          servoFaultActive  = false;
    unsigned long servoFaultStartMs = 0;

    //Stores a reference to the global system runtime function to be called when blocking operations are needed
    void (*_sys_rt)() = nullptr;

    // Stream Z, the fan level and the belt-cooling request to the spindle board and read its replies.
    void updateSpindleBoard(bool beltMotionActive);

    //Used to overide and drive motors directly...dangerous
    bool          TLIOveride   = false;
    bool          TRIOveride   = false;
    bool          BLIOveride   = false;
    bool          BRIOveride   = false;
    bool          TLOOveride   = false;
    bool          TROOveride   = false;
    bool          BLOOveride   = false;
    bool          BROOveride   = false;
    unsigned long overideTimer = millis();

    bool HeartBeatEnabled = true;
    void log_telem_hdr_csv();
    void log_telem_pt_csv(TelemetryData data);
    float currentZHome() const;
};

extern Maslow_& Maslow;

// actual task loop for gathering telemetry data (runs on utility core)
void telemetry_loop(void* unused);

// Shared scratch buffer for snprintf-style log formatting, protected by a
// mutex.  Kept from the pre-merge Maslow logging code; upstream FluidNC no
// longer provides these.
char* getLogBuffer();
void  releaseLogBuffer();
