MaslowCNC/Maslow_4/ESP3D-WEBUI/www/js/toolpath-displayer.js

// Display the XY-plane projection of a GCode toolpath on a 2D canvas

var root = window;

const canvas = document.getElementById("small-toolpath");
const scale = window.devicePixelRatio;
const width = window.innerWidth;
canvas.width = width * scale;
canvas.height = (width / 2) * scale;
var tp = canvas.getContext("2d", { willReadFrequently: true });
var tpRect;

tp.lineWidth = 0.1;
tp.lineCap = 'round';
tp.strokeStyle = 'black';

// Arc detection epsilon - matches FluidNC firmware (Config.h:179, MotionControl.cpp:144,154)
// See firmware/FluidNC/src/Config.h:179 and MotionControl.cpp:142-160
var ARC_ANGULAR_TRAVEL_EPSILON = 5e-7;

// Constants for arc calculations
const TWO_PI = Math.PI * 2;
const CARDINAL_ANGLES = [0, Math.PI/2, Math.PI, 3*Math.PI/2]; // 0°, 90°, 180°, 270°

var cameraAngle = 2; // Default to top-down view

// Default fallback values (will be replaced by actual configuration values)
var tlX = -8.339;
var tlY = 2209;
var trX = 3505;
var trY = 2209;
var blX = 0;
var blY = 0;
var brX = 3505;
var brY = 0;

// Function to update anchor points from configuration
function updateAnchorPointsFromConfig() {
    if (globalThis.initialGuess) {
        if (globalThis.initialGuess.tl) {
            tlX = globalThis.initialGuess.tl.x || tlX;
            tlY = globalThis.initialGuess.tl.y || tlY;
        }
        if (globalThis.initialGuess.tr) {
            trX = globalThis.initialGuess.tr.x || trX;
            trY = globalThis.initialGuess.tr.y || trY;
        }
        if (globalThis.initialGuess.bl) {
            blX = globalThis.initialGuess.bl.x || blX;
            blY = globalThis.initialGuess.bl.y || blY;
        }
        if (globalThis.initialGuess.br) {
            brX = globalThis.initialGuess.br.x || brX;
            brY = globalThis.initialGuess.br.y || brY;
        }
    }
}

//Draw buttons
const tlC = document.getElementById("tlBtn").getContext("2d");
tlC.fillStyle = "#b69fcb";
tlC.fillRect(0, 0, 500, 500);
tlC.beginPath();
tlC.moveTo(90, 40);
tlC.lineTo(90, 140);
tlC.lineTo(230, 40);
tlC.lineTo(90, 40);
tlC.closePath();
tlC.lineWidth = 5;
tlC.strokeStyle = 'white';
tlC.fillStyle = 'white';
tlC.fill();
tlC.stroke();

const trC = document.getElementById("trBtn").getContext("2d");
trC.fillStyle = "#b69fcb";
trC.fillRect(0, 0, 500, 500);
trC.beginPath();
trC.moveTo(90, 40);
trC.lineTo(230, 140);
trC.lineTo(230, 40);
trC.lineTo(90, 40);
trC.closePath();
trC.lineWidth = 5;
trC.strokeStyle = 'white';
trC.fillStyle = 'white';
trC.fill();
trC.stroke();

const blC = document.getElementById("blBtn").getContext("2d");
blC.fillStyle = "#b69fcb";
blC.fillRect(0, 0, 500, 500);
blC.beginPath();
blC.moveTo(90, 40);
blC.lineTo(230, 140);
blC.lineTo(90, 140);
blC.lineTo(90, 40);
blC.closePath();
blC.lineWidth = 5;
blC.strokeStyle = 'white';
blC.fillStyle = 'white';
blC.fill();
blC.stroke();

const brC = document.getElementById("brBtn").getContext("2d");
brC.fillStyle = "#b69fcb";
brC.fillRect(0, 0, 500, 500);
brC.beginPath();
brC.moveTo(90, 140);
brC.lineTo(230, 140);
brC.lineTo(230, 40);
brC.lineTo(90, 140);
brC.closePath();
brC.lineWidth = 5;
brC.strokeStyle = 'white';
brC.fillStyle = 'white';
brC.fill();
brC.stroke();

const upC = document.getElementById("upBtn").getContext("2d");
upC.fillStyle = "#9d88c0";
upC.fillRect(0, 0, 500, 500);
// #rect441
upC.beginPath();
upC.fillStyle = 'white';
upC.lineWidth = 1;
upC.rect(60+49.213840, 99.622299, 93.976021, 74.721062);
upC.fill();

// #path608
upC.beginPath();
upC.strokeStyle = 'white';
upC.lineWidth = 1;
upC.lineCap = 'butt';
upC.lineJoin = 'miter';
upC.moveTo(60+5.109692, 104.666810);
upC.lineTo(60+94.679220, 4.145211);
upC.lineTo(60+189.305070, 103.959000);
upC.lineTo(60+5.109692, 104.666810);
upC.closePath();
upC.stroke();
upC.fill();



const dnC = document.getElementById("dnBtn").getContext("2d");
dnC.fillStyle = "#9d88c0";
dnC.fillRect(0, 0, 500, 500);
// #rect441
dnC.save();
dnC.transform(1.000000, 0.000000, 0.000000, -1.000000, 0.000000, 0.000000);
dnC.fillStyle = 'white';
dnC.lineWidth = 1;
dnC.rect(60 + 49.213840, -75.901474, 93.976021, 74.721062);
dnC.fill();
dnC.restore();

// #path608
dnC.beginPath();
dnC.strokeStyle = 'white';
dnC.fillStyle = 'white';
dnC.lineWidth = 1;
dnC.lineCap = 'butt';
dnC.lineJoin = 'miter';
dnC.moveTo(60 + 5, 70 - 20);
dnC.lineTo(60 + 94, 171 - 20);
dnC.lineTo(60 + 189, 71 - 20);
dnC.lineTo(60 + 5, 70 - 20);
dnC.closePath();
dnC.stroke();
dnC.fill();

const rC = document.getElementById("rBtn").getContext("2d");
rC.fillStyle = "#9d88c0";
rC.fillRect(0, 0, 500, 500);
// #g1100
rC.save();
rC.transform(0.000000, 1.000000, -1.000000, 0.000000, 187.481000, 0.273690);

// #rect441
rC.fillStyle = 'white';
rC.lineWidth = 1;
rC.rect(-20 + 49.213840, 99.622299 - 80, 93.976021, 74.721062);
rC.fill();

// #path608
rC.beginPath();
rC.strokeStyle = 'white';
rC.lineWidth = 1;
rC.lineCap = 'butt';
rC.lineJoin = 'miter';
rC.moveTo(-20+5.109692, 104.666810 - 80);
rC.lineTo(-20+94.679220, 4.145213 - 80);
rC.lineTo(-20+189.305070, 103.959000 - 80);
rC.closePath();
rC.stroke();
rC.fill();
rC.restore();


const lC = document.getElementById("lBtn").getContext("2d");
lC.fillStyle = "#9d88c0";
lC.fillRect(0, 0, 500, 500);
// #g1100
lC.save();
lC.transform(0.000000, 1.000000, 1.000000, 0.000000, 11.957500, 0.273690);

// #rect441
lC.fillStyle = 'white';
lC.lineWidth = 1;
lC.rect(-20 + 49.213840, 99.622299, 93.976021, 74.721062);
lC.fill();

// #path608
lC.beginPath();
lC.strokeStyle = 'white';
lC.lineWidth = 1;
lC.lineCap = 'butt';
lC.lineJoin = 'miter';
lC.moveTo(-20 + 5.109692, 104.666810);
lC.lineTo(-20 + 94.679220, 4.145213);
lC.lineTo(-20 + 189.305070, 103.959000);
lC.closePath();
lC.stroke();
lC.fill();
lC.restore();

const hC = document.getElementById("hBtn").getContext("2d");

const xO = 55;
const yO = -45;

// #path5094
hC.beginPath();
hC.fillStyle = 'rgb(183, 161, 208)';
hC.strokeStyle = 'rgb(0, 0, 0)';
hC.lineWidth = 0.472615;
hC.lineCap = 'butt';
hC.lineJoin = 'miter';
hC.moveTo(xO + 55.719343, 197.549650 + yO);
hC.lineTo(xO + 152.150650, 197.549650 + yO);
hC.lineTo(xO + 152.609520, 74.078285 + yO);
hC.lineTo(xO + 132.404810, 73.680279 + yO);
hC.lineTo(xO + 131.393420, 110.310850 + yO);
hC.lineTo(xO + 103.475730, 84.035976 + yO);
hC.lineTo(xO + 54.341657, 131.433070 + yO);
hC.fill();
hC.stroke();

// #rect1898
hC.beginPath();
hC.fillStyle = 'rgb(218, 208, 230)';
hC.lineWidth = 0.472615;
hC.rect(xO + 74.087212, 146.169600 + yO, 29.847790, 50.981743);
hC.fill();

// #path13430
hC.beginPath();
hC.fillStyle = 'rgb(151, 132, 181)';
hC.strokeStyle = 'rgb(0, 0, 0)';
hC.lineWidth = 0.472615;
hC.lineCap = 'butt';
hC.lineJoin = 'miter';
hC.moveTo(xO + 103.475730, 84.035976 + yO);
hC.lineTo(xO + 167.304170, 144.974770 + yO);
hC.lineTo(xO + 181.080090, 132.229340 + yO);
hC.lineTo(xO + 103.016580, 56.951581 + yO);
hC.lineTo(xO + 24.953156, 131.432760 + yO);
hC.lineTo(xO + 40.565818, 144.974770 + yO);
hC.fill();
hC.stroke();

//---------------------------

const playC = document.getElementById("playBtn").getContext("2d");
playC.fillStyle = "#4aa85c";
playC.fillRect(0, 0, 500, 500);

playC.beginPath();
playC.strokeStyle = 'white';
playC.fillStyle = 'white';
playC.lineWidth = 1;
playC.lineCap = 'butt';
playC.lineJoin = 'miter';
playC.moveTo(60 + 44.053484, 147.608260 - 35);
playC.lineTo(60 + 44.053484, 68.502834 - 35);
playC.lineTo(60 + 112.311470, 106.828610 - 35);
playC.closePath();
playC.fill();
playC.stroke();


const stopC = document.getElementById("stopBtn").getContext("2d");
stopC.fillStyle = "#cd654c";
stopC.fillRect(0, 0, 500, 500);

stopC.strokeStyle = 'white';
stopC.fillStyle = 'white';
stopC.beginPath();
stopC.fillStyle = 'white';
stopC.lineWidth = 1;
stopC.rect(60 + 44, 65 - 35, 100, 80);
stopC.fill();
stopC.stroke();

var tpUnits = 'G21';

var tpBbox = {
    min: {
        x: Infinity,
        y: Infinity,
        z: Infinity
    },
    max: {
        x: -Infinity,
        y: -Infinity,
        z: -Infinity
    }
};

// Bounding box for the work area rectangle only (excludes belt anchor points)
var workAreaBbox = {
    min: { x: Infinity, y: Infinity },
    max: { x: -Infinity, y: -Infinity }
};

// Separate tracking for just the job/gcode bounding box (excluding machine bounds)
var jobBbox = {
    min: {
        x: Infinity,
        y: Infinity,
        z: Infinity
    },
    max: {
        x: -Infinity,
        y: -Infinity,
        z: -Infinity
    }
};

// Storage for toolpath points to compute convex hull
var jobToolpathPoints = [];
var jobEnvelopePoints = []; // Simplified convex hull points (up to 100)

var bboxIsSet = false;
var jobBboxIsSet = false;
var initialMovesForBbox = true; // Track if we're still in initial positioning phase
var findAnchorsTracePoints = [];

var clearFindAnchorsTrace = function() {
    findAnchorsTracePoints = [];
}

var addFindAnchorsTracePoint = function(x, y) {
    if (!isFinite(x) || !isFinite(y)) {
        return;
    }

    const lastPoint = findAnchorsTracePoints[findAnchorsTracePoints.length - 1];
    if (lastPoint && lastPoint.x === x && lastPoint.y === y) {
        return;
    }

    findAnchorsTracePoints.push({ x: x, y: y });
}

var includeFindAnchorsTraceInBbox = function() {
    if (findAnchorsTracePoints.length === 0) {
        return;
    }

    for (let i = 0; i < findAnchorsTracePoints.length; i++) {
        const p = projection({ x: findAnchorsTracePoints[i].x, y: findAnchorsTracePoints[i].y, z: 0 });
        tpBbox.min.x = Math.min(tpBbox.min.x, p.x);
        tpBbox.min.y = Math.min(tpBbox.min.y, p.y);
        tpBbox.max.x = Math.max(tpBbox.max.x, p.x);
        tpBbox.max.y = Math.max(tpBbox.max.y, p.y);
        bboxIsSet = true;
    }
}

var resetBbox = function() {
    tpBbox.min.x = Infinity;
    tpBbox.min.y = Infinity;
    tpBbox.min.z = Infinity;
    tpBbox.max.x = -Infinity;
    tpBbox.max.y = -Infinity;
    tpBbox.max.z = -Infinity;
    bboxIsSet = false;

    // Reset work area bbox
    workAreaBbox.min.x = Infinity;
    workAreaBbox.min.y = Infinity;
    workAreaBbox.max.x = -Infinity;
    workAreaBbox.max.y = -Infinity;

    // Also reset job bounding box
    jobBbox.min.x = Infinity;
    jobBbox.min.y = Infinity;
    jobBbox.min.z = Infinity;
    jobBbox.max.x = -Infinity;
    jobBbox.max.y = -Infinity;
    jobBbox.max.z = -Infinity;
    jobBboxIsSet = false;
    initialMovesForBbox = true;

    // Reset toolpath points
    jobToolpathPoints = [];
    jobEnvelopePoints = [];
}

// Helper functions for job bounding box
var jobBboxExists = function() {
    return jobBboxIsSet &&
           isFinite(jobBbox.min.x) && isFinite(jobBbox.min.y) && isFinite(jobBbox.min.z) &&
           isFinite(jobBbox.max.x) && isFinite(jobBbox.max.y) && isFinite(jobBbox.max.z);
}

var getJobBoundingBox = function() {
    if (!jobBboxExists()) {
        return null;
    }
    return {
        min: { x: jobBbox.min.x, y: jobBbox.min.y, z: jobBbox.min.z },
        max: { x: jobBbox.max.x, y: jobBbox.max.y, z: jobBbox.max.z }
    };
}

// Convex Hull algorithm (Andrew's monotone chain)
var computeConvexHull = function(points) {
    if (points.length < 3) {
        return points;
    }

    // Sort points lexicographically (first by x, then by y)
    var sorted = points.slice().sort(function(a, b) {
        return a.x !== b.x ? a.x - b.x : a.y - b.y;
    });

    // Build lower hull
    var lower = [];
    for (var i = 0; i < sorted.length; i++) {
        while (lower.length >= 2 &&
               crossProduct(lower[lower.length - 2], lower[lower.length - 1], sorted[i]) <= 0) {
            lower.pop();
        }
        lower.push(sorted[i]);
    }

    // Build upper hull
    var upper = [];
    for (var i = sorted.length - 1; i >= 0; i--) {
        while (upper.length >= 2 &&
               crossProduct(upper[upper.length - 2], upper[upper.length - 1], sorted[i]) <= 0) {
            upper.pop();
        }
        upper.push(sorted[i]);
    }

    // Remove last point of each half because it's repeated
    lower.pop();
    upper.pop();

    return lower.concat(upper);
}

// Cross product for convex hull
var crossProduct = function(o, a, b) {
    return (a.x - o.x) * (b.y - o.y) - (a.y - o.y) * (b.x - o.x);
}

// Douglas-Peucker algorithm for simplifying polylines
var simplifyPolyline = function(points, maxPoints) {
    if (points.length <= maxPoints) {
        return points;
    }

    // Use iterative approach to reduce points to maxPoints
    var epsilon = 0.1; // Start with small tolerance
    var simplified = points;

    // Increase epsilon until we have <= maxPoints
    while (simplified.length > maxPoints && epsilon < 1000) {
        simplified = douglasPeucker(points, epsilon);
        epsilon *= 1.5;
    }

    return simplified;
}

// Douglas-Peucker recursive algorithm
var douglasPeucker = function(points, epsilon) {
    if (points.length < 3) {
        return points;
    }

    // Find the point with maximum distance
    var dmax = 0;
    var index = 0;
    var end = points.length - 1;

    for (var i = 1; i < end; i++) {
        var d = perpendicularDistance(points[i], points[0], points[end]);
        if (d > dmax) {
            index = i;
            dmax = d;
        }
    }

    // If max distance is greater than epsilon, recursively simplify
    var result = [];
    if (dmax > epsilon) {
        var recResults1 = douglasPeucker(points.slice(0, index + 1), epsilon);
        var recResults2 = douglasPeucker(points.slice(index), epsilon);

        // Concatenate results
        result = recResults1.slice(0, -1).concat(recResults2);
    } else {
        result = [points[0], points[end]];
    }

    return result;
}

// Calculate perpendicular distance from point to line
var perpendicularDistance = function(point, lineStart, lineEnd) {
    var dx = lineEnd.x - lineStart.x;
    var dy = lineEnd.y - lineStart.y;

    var mag = Math.sqrt(dx * dx + dy * dy);
    if (mag === 0) {
        return Math.sqrt((point.x - lineStart.x) * (point.x - lineStart.x) +
                        (point.y - lineStart.y) * (point.y - lineStart.y));
    }

    var u = ((point.x - lineStart.x) * dx + (point.y - lineStart.y) * dy) / (mag * mag);

    var ix = lineStart.x + u * dx;
    var iy = lineStart.y + u * dy;

    return Math.sqrt((point.x - ix) * (point.x - ix) + (point.y - iy) * (point.y - iy));
}

// Compute the job envelope from collected toolpath points
var computeJobEnvelope = function() {
    if (jobToolpathPoints.length < 3) {
        jobEnvelopePoints = [];
        return;
    }

    // Compute convex hull
    var hull = computeConvexHull(jobToolpathPoints);

    // Simplify to at most 100 points
    jobEnvelopePoints = simplifyPolyline(hull, 100);
}

// Project the 3D toolpath onto the 2D Canvas
// The coefficients determine the type of projection
// Matrix multiplication written out
var xx = 0.707;
var xy = 0.707;
var xz = 0.0;
var yx = -0.707/2;
var yy = 0.707/2;
var yz = 1.0;
var isoView = function() {
    xx = 0.707;
    xy = 0.707;
    xz = 0.0;
    yx = -0.707;
    yy = 0.707;
    yz = 1.0;
}
var obliqueView = function() {
    xx = 0.707;
    xy = 0.707;
    xz = 0.0;
    yx = -0.707/2;
    yy = 0.707/2;
    yz = 1.0;
}
var topView = function() {
    xx = 1.0;
    xy = 0.0;
    xz = 0.0;
    yx = 0.0;
    yy = 1.0;
    yz = 0.0;
}
const projection = (wpos) => ({ x: wpos.x * xx + wpos.y * xy + wpos.z * xz, y: wpos.x * yx + wpos.y * yy + wpos.z * yz });

var formatLimit = function(mm) {
    return (tpUnits == 'G20') ? (mm/25.4).toFixed(3)+'"' : mm.toFixed(2)+'mm';
}

var toolX = null;
var toolY = null;
var toolSave = null;
var toolRadius = 6;
var toolRectWH = toolRadius*2 + 4;  // Slop to encompass the entire image area

var drawTool = function(dpos) {
    // Convert work coordinates to machine coordinates if WCO is available
    // This ensures the tool position stays consistent when home position changes
    const wco = WCO;
    let toolPos;

    if (wco && Array.isArray(wco) && wco.length >= 2) {
        // WCO is available, convert WPOS to MPOS: MPOS = WPOS + WCO
        const mpos = {
            x: dpos.x + wco[0],
            y: dpos.y + wco[1],
            z: dpos.z + (wco[2] || 0)
        };
        toolPos = projection(mpos);
    } else {
        // WCO not available, project work coordinates directly (original behavior)
        toolPos = projection(dpos);
    }

    pp = toolPos;
    toolX = xToPixel(pp.x)-toolRadius-2;
    toolY = yToPixel(pp.y)-toolRadius-2;

    // Validate coordinates before calling getImageData to prevent canvas errors
    if (!isFinite(toolX) || !isFinite(toolY)) {
        return; // Skip drawing if coordinates are invalid
    }

    toolSave = tp.getImageData(toolX, toolY, toolRectWH, toolRectWH);

    tp.beginPath();
    tp.strokeStyle = 'magenta';
    tp.fillStyle = 'magenta';
    tp.arc(pp.x, pp.y, toolRadius/scaler, 0, Math.PI*2, true);
    tp.fill();
    tp.stroke();
}

var drawOrigin = function(radius) {
    // Work origin is at WPOS (0,0,0) on the work surface
    // Convert to MPOS if WCO is available: MPOS = WPOS + WCO
    // Always use Z=0 for work surface plane regardless of WCO[2]
    const wco = WCO;
    let originPos;

    if (wco && Array.isArray(wco) && wco.length >= 2) {
        // WCO available, work origin is at MPOS = WCO, but Z=0 for work surface
        const originMPOS = {x: wco[0], y: wco[1], z: 0};
        originPos = projection(originMPOS);
    } else {
        // WCO not available, project work origin directly at work surface (original behavior)
        originPos = projection({x: 0, y: 0, z: 0});
    }

    po = originPos;
    tp.beginPath();
    tp.strokeStyle = 'red';
    tp.lineWidth = 2.0 / scaler;
    tp.arc(po.x, po.y, radius, 0, Math.PI*2, false);
    tp.moveTo(po.x - radius*1.5, po.y);
    tp.lineTo(po.x + radius*1.5, po.y);
    tp.moveTo(po.x, po.y - radius*1.5);
    tp.lineTo(po.x, po.y + radius*1.5);
    tp.stroke();
}

var drawFindAnchorsTrace = function() {
    if (findAnchorsTracePoints.length === 0) {
        return;
    }

    tp.beginPath();
    tp.strokeStyle = '#ff7f0e';
    tp.lineWidth = 2.0 / scaler;

    const firstPoint = projection({ x: findAnchorsTracePoints[0].x, y: findAnchorsTracePoints[0].y, z: 0 });
    tp.moveTo(firstPoint.x, firstPoint.y);

    for (let i = 1; i < findAnchorsTracePoints.length; i++) {
        const p = projection({ x: findAnchorsTracePoints[i].x, y: findAnchorsTracePoints[i].y, z: 0 });
        tp.lineTo(p.x, p.y);
    }
    tp.stroke();

    tp.fillStyle = '#ff7f0e';
    for (let i = 0; i < findAnchorsTracePoints.length; i++) {
        const p = projection({ x: findAnchorsTracePoints[i].x, y: findAnchorsTracePoints[i].y, z: 0 });
        tp.beginPath();
        tp.arc(p.x, p.y, 3.0 / scaler, 0, Math.PI * 2);
        tp.fill();
    }

    tp.lineWidth = 0.5 / scaler;
}

var drawJobBoundingBox = function() {
    if (!bboxIsSet || !jobBboxExists()) {
        return;
    }

    // Get the job bounding box
    var bbox = getJobBoundingBox();
    if (!bbox) {
        return;
    }

    // Convert work coordinates to machine coordinates if WCO is available
    const wco = WCO;
    const hasWCO = wco && Array.isArray(wco) && wco.length >= 2;

    // Use envelope points if available (shaped boundary), otherwise fall back to rectangle
    if (jobEnvelopePoints.length > 0) {
        // Draw the shaped envelope
        tp.beginPath();
        tp.strokeStyle = 'blue';
        tp.lineWidth = 2.0 / scaler;

        // Project and draw the first point
        let firstPoint;
        if (hasWCO) {
            const firstMPOS = {x: jobEnvelopePoints[0].x + wco[0], y: jobEnvelopePoints[0].y + wco[1], z: bbox.min.z + (wco[2] || 0)};
            firstPoint = projection(firstMPOS);
        } else {
            firstPoint = projection({x: jobEnvelopePoints[0].x, y: jobEnvelopePoints[0].y, z: bbox.min.z});
        }
        tp.moveTo(firstPoint.x, firstPoint.y);

        // Draw lines to all other envelope points
        for (var i = 1; i < jobEnvelopePoints.length; i++) {
            let p;
            if (hasWCO) {
                const pMPOS = {x: jobEnvelopePoints[i].x + wco[0], y: jobEnvelopePoints[i].y + wco[1], z: bbox.min.z + (wco[2] || 0)};
                p = projection(pMPOS);
            } else {
                p = projection({x: jobEnvelopePoints[i].x, y: jobEnvelopePoints[i].y, z: bbox.min.z});
            }
            tp.lineTo(p.x, p.y);
        }

        // Close the path
        tp.lineTo(firstPoint.x, firstPoint.y);
        tp.stroke();
    } else {
        // Fallback to simple rectangle
        // Project the corners of the job bounding box
        let p0, p1, p2, p3;
        if (hasWCO) {
            // Convert WPOS to MPOS: MPOS = WPOS + WCO
            p0 = projection({x: bbox.min.x + wco[0], y: bbox.min.y + wco[1], z: bbox.min.z + (wco[2] || 0)});
            p1 = projection({x: bbox.max.x + wco[0], y: bbox.min.y + wco[1], z: bbox.min.z + (wco[2] || 0)});
            p2 = projection({x: bbox.max.x + wco[0], y: bbox.max.y + wco[1], z: bbox.min.z + (wco[2] || 0)});
            p3 = projection({x: bbox.min.x + wco[0], y: bbox.max.y + wco[1], z: bbox.min.z + (wco[2] || 0)});
        } else {
            p0 = projection({x: bbox.min.x, y: bbox.min.y, z: bbox.min.z});
            p1 = projection({x: bbox.max.x, y: bbox.min.y, z: bbox.min.z});
            p2 = projection({x: bbox.max.x, y: bbox.max.y, z: bbox.min.z});
            p3 = projection({x: bbox.min.x, y: bbox.max.y, z: bbox.min.z});
        }

        // Draw the bounding box rectangle
        tp.beginPath();
        tp.strokeStyle = 'blue';
        tp.lineWidth = 2.0 / scaler;
        tp.moveTo(p0.x, p0.y);
        tp.lineTo(p1.x, p1.y);
        tp.lineTo(p2.x, p2.y);
        tp.lineTo(p3.x, p3.y);
        tp.lineTo(p0.x, p0.y);
        tp.stroke();
    }

    // Restore line width
    tp.lineWidth = 0.5 / scaler;
}
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
