MaslowCNC/Maslow_4/(commit log)

2025-05-21 Release and then Apply tension
2025-05-22 Fix machine jerking when applying tension
    [Calibration.cpp]
2025-07-29 Add material thickness setting for Maslow CNC height offset
    [maslow.yaml]
2025-08-01 Split material thickness into spoilboard and work thickness settings
    [maslow.yaml]
2025-08-01 Add spoilboard and work thickness parameters to MachineConfig
    [maslow.yaml]
2025-08-10 Implement motor current monitoring with moving average filter
2025-08-10 Implement motor current monitoring entirely in MotorUnit.cpp
2025-08-12 Implement calibration state reset functionality
    [Calibration.cpp, Calibration.h]
2025-08-14 Fix motor current logging in Hold state and calibration holding
    [Maslow.cpp]
2025-09-12 Fix sudden movement during calibration start by preserving Z position
    [Calibration.cpp]
2025-09-12 Revert to original calibration behavior - force Z to 0 for home position
    [Calibration.cpp]
2025-09-12 Add comprehensive debug logging to investigate sudden movement during calibration start
2025-09-15 Add debug logging to takeSlackFunc to track Apply Tension movement
2025-09-15 Enhanced debug logging to identify Apply Tension issue root cause
    [Calibration.cpp]
2025-09-15 Fix orientation debug logging and add comprehensive belt pulling debug info
    [Calibration.cpp]
2025-09-15 Add detailed pull_tight debug logging to identify current measurement issues
    [MotorUnit.cpp]
2025-09-15 Remove excessive debug logging from pull_tight() to fix infinite loop during Retract All
    [MotorUnit.cpp]
2025-09-15 Fix sudden movement at calibration start by resetting belt targets
    [Calibration.cpp]
2025-09-15 Make Release Tension button green by adding CSS rule to style.css
2025-09-15 Complete Release Tension button color fix - verified working
2025-09-18 Implement belt position saving to NVS like Z position
2025-09-18 Implement relaxToExtend option for belt extension
    [maslow.yaml]
2025-09-19 Add MaslowAutoUpdate configuration option and auto-update functionality
    [maslow.yaml]
2025-09-19 Add configurable MaslowUpdateURL option to customize update source
    [maslow.yaml]
2025-09-22 Fix filesystem permissions by using FluidPath system for proper ESP32 filesystem handling
2025-09-23 Implement autoupdate feature for FluidNC
    [maslow.yaml]
2025-09-23 Add test configuration and final validation
    [autoupdate_test.yaml]
2025-09-24 Fix autoupdate not triggering by adding WiFi handle to main loop
    [Protocol.cpp]
2025-09-25 Fix UI connectivity by removing problematic WiFi handle call from main loop
    [Protocol.cpp]
2025-09-25 Add comprehensive debug logging to diagnose autoupdate invocation issues
    [WifiConfig.cpp]
2025-09-25 CRITICAL FIX: Remove infinite recursion causing stack overflow crash
    [WifiConfig.cpp]
2025-10-01 Implement automatic calibration grid computation
2025-10-01 Add validation and error handling for auto-computed grid
    [Calibration.cpp]
2025-10-01 Support non-symmetrical grids with configurable spacing parameter
    - Add calibrationGridSpacing parameter (default 400mm)
    - Add calibrationGridPointsX and calibrationGridPointsY for non-symmetrical grids
    - Rewrite generate_calibration_grid() to support rectangular grids (e.g., 4x3)
    - Update auto-computation logic to use spacing parameter
    - Maintain backward compatibility with legacy calibrationGridSize
    - Example: 1500x1000 grid with 400mm spacing = 4x3 grid
2025-10-01 Add YAML configuration support and migration for calibrationGridSpacing
    - Update maslow.yaml to use new calibrationGridSpacing parameter (default 400mm)
    - Set default grid dimensions to 0,0 for auto-computation
    - Add handler in MachineConfig to read calibrationGridSpacing from YAML
    - Implement migration logic to convert legacy calibrationGridSize to calibrationGridSpacing
    - Move calibrationGridPointsX/Y to private section (calculated internally, not user-configurable)
    - Update default config strings to reflect new parameters
    - Allow calibration_grid dimensions to be 0 (min changed from 100 to 0)
    [maslow.yaml]
2025-10-01 Implement auto-calculated calibration grid dimensions based on frame geometry
2025-10-01 Add safety constraints: 16" clearance and minimum 3-point grid support
    [Calibration.cpp]
2025-10-02 Add calibration area sanity check and enhanced logging
2025-10-02 Add automatic grid height reduction when sanity check fails
    [Calibration.cpp]
2025-10-02 Add maximum calibration area limits: 8' wide × 4' high
2025-10-02 Regenerate calibration grid after frame size adjustment from first measurement
2025-10-02 Change maximum calibration area from 8' × 4' to 7' × 4'
2025-10-02 Change maximum calibration area from 7' × 4' to 7' × 3'
2025-10-02 Support non-square calibration grids and remove 9-point limit
2025-10-03 Allow 0.0 as valid grid dimension for auto-calculation (fixes constraint warnings)
    [MachineConfig.cpp]
2025-10-04 Fix belt position loading to properly update motor steps and sync with planner
    [Maslow.cpp]
2025-10-04 Only load NVS positions on first call to begin() (initial power-on)
2025-10-04 Implement state-based belt position NVS management with validity tracking
2025-10-05 Defer calibration grid generation until after waypoint 5 calculation
2025-10-05 Allocate memory for first 6 waypoints at calibration start
2025-10-05 Preserve calibration data when reallocating for full grid
2025-10-06 Initialize recomputePoints[0] when starting calibration
2025-10-06 Add calibrationGridSpacing parameter for auto-calculating grid size
2025-10-06 Add validation for grid size to prevent calibration failure
    [Calibration.cpp]
2025-10-06 Fix pointCount initialization for first 6 waypoints
    [Calibration.cpp]
2025-10-06 Fix grid generation timing to prevent crash at waypoint 6
    [Calibration.cpp]
2025-10-07 Fix grid size auto-calculation to run before memory allocation
    [Calibration.cpp]
2025-10-07 Implement auto-calculation logic with OR condition for calibration grid parameters
2025-10-07 Fix auto-calculation logic to use OR instead of AND for calibration grid parameters
    Based on PR #359, implement the requested change:
    - Check if ANY of the four parameters is 0 (OR logic instead of AND)
    - If so, auto-calculate ALL four parameters from frame geometry
    - Otherwise, use user-provided values
    - Add missing setExtendedState method for compatibility
    [Calibration.cpp, Calibration.h, MachineConfig.cpp]
2025-10-07 Fix variable shadowing bug that caused memory crash
    Fixed critical bug where gridWidth, gridHeight, frameWidth, and frameHeight were being
    redeclared as local variables inside the if block, shadowing the outer declarations.
    This caused the outer variables to remain uninitialized, leading to invalid spacing
    calculations and memory access violations.
    Also added validation to ensure grid dimensions are valid before proceeding.
    [Calibration.cpp]
2025-10-07 Fix potential memory alignment issue by copying parameters to local variables
    Changed to copy calibration parameters to properly aligned local variables before comparison
    to avoid potential LoadStoreAlignment errors. This ensures safe memory access when checking
    if auto-calculation is needed.
    Simulation log for 4688.100mm x 4041.200mm frame shows expected behavior:
    - Grid dimensions: 2133.600mm × 914.400mm (limited by 7'x3' max)
    - Grid size: 6x3 points (18 total)
    - Spacing: 426.720mm (X) × 457.200mm (Y)
    - Clearance from edges: 1277.250mm (width), 1563.400mm (height)
    - All sanity checks pass (top angle: 112.671° < 140°)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
    [Calibration.cpp]
2025-10-07 Fix heap corruption by initializing grid size variables and simplifying log messages
    The heap corruption (assert failed: remove_free_block) was caused by:
    1. Uninitialized gridSizeX and gridSizeY variables
    2. Complex log_info messages with temporary string allocations
    Changes:
    - Initialize gridSizeX and gridSizeY to safe defaults (9) before conditionals
    - Simplified log messages to reduce temporary string allocations
    - Removed verbose spacing info from logs to prevent heap issues
    - Ensures variables are always initialized before use in calculateGridPointCount
    This prevents uninitialized variable access and reduces heap pressure from logging.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
    [Calibration.cpp]
2025-10-07 Prevent redundant logging to reduce heap fragmentation
    Fixed heap corruption during repeated setter calls by:
    - Only logging when thickness values actually change
    - Preventing redundant log messages that fragment heap
    - Simplified log message format (removed "set to" and space before "mm")
    The crash occurred because setSpoilboardThickness/setWorkThickness were being
    called repeatedly (possibly during multiple afterParse() calls), each creating
    temporary log strings. After ~7 calls, heap fragmentation caused corruption.
    This change reduces heap pressure by eliminating redundant logs while still
    providing necessary information when values change.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
    [MaslowKinematics.cpp]
2025-10-07 Simplify grid configuration logging to prevent heap corruption
    Fixed heap corruption during grid configuration logging by:
    - Removed complex log formatting with special characters (×, ², parentheses)
    - Simplified multi-line log messages into concise single-line formats
    - Replaced verbose text with abbreviations ("pts", "sq m", "x" instead of "×")
    - Removed redundant clearance calculation log (extra string operations)
    The crash (assert failed: multi_heap_free multi_heap_poisoning.c:259) occurred
    after logging "Calibration area" due to heap metadata corruption from multiple
    consecutive complex log_info calls with temporary string streams.
    Changes reduce heap fragmentation by:
    - Using simp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
    [Calibration.cpp]
2025-10-07 Remove grid area calculation and logging to prevent heap corruption
    Removed calibration area calculation and logging as requested:
    - Removed calibrationArea variable (gridWidth * gridHeight in mm²)
    - Removed calibrationAreaM2 variable (area / 1000000.0f in m²)
    - Removed "Area: X sq m" log line
    This eliminates floating point division and multiplication that could
    contribute to heap fragmentation, and removes one log_info call that
    creates temporary string objects.
    Benefits:
    - Reduces heap pressure by removing unnecessary calculations
    - Eliminates one log call (from 5 down to 4)
    - Removes floating point operations that could cause precision issues
    - Flash reduced from 2,018,441 to 2,018,28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
    [Calibration.cpp]
2025-10-07 Replace Unicode character with ASCII in comment
    Changed × (multiplication sign, Unicode U+00D7) to x (ASCII) in comment
    describing maximum calibration area limits.
    This ensures all text in the PR uses only ASCII characters, avoiding
    potential encoding issues and improving compatibility across different
    systems and terminals.
    Location: Comment describing 7' wide × 3' high calibration area limit
    Changed to: 7' wide x 3' high
    No functional changes, Flash size remains 2,018,281 bytes.
    [Calibration.cpp]
2025-10-07 Remove log statement before memory allocation to fix cache error
    Fixed "Cache disabled but cached memory region accessed" error by removing
    log_info call immediately before allocateCalibrationMemory().
    The error (EXCCAUSE: 0x00000007) occurs when string literals stored in Flash
    memory are accessed while cache is disabled. This can happen during:
    - Flash write operations
    - OTA updates
    - WiFi operations
    - Certain FreeRTOS operations
    The log statement "Allocating memory for X calibration points" was accessing
    a string literal in Flash right before a critical memory allocation, causing
    the cache error when timing coincided with cache-disabled periods.
    Solution: Removed the problematic log sta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
    [Calibration.cpp]
2025-10-07 Restore log statement after memory allocation to avoid cache error
    Added back the "Allocated memory for X calibration points" log statement,
    but placed it AFTER allocateCalibrationMemory() completes instead of before.
    This avoids the cache-disabled region during memory allocation while still
    providing useful debugging information about the calibration grid size.
    The log now executes after the critical memory allocation section, ensuring
    Flash memory access (for the string literal) occurs when cache is enabled.
    No Flash size change expected (restoring previously removed code).
    [Calibration.cpp]
2025-10-07 Fix heap corruption from improper 2D array allocation - ROOT CAUSE
    CRITICAL FIX: Found and fixed the actual root cause of ALL heap corruption issues.
    The problem was in line 1904: calibrationGrid = new float[numPoints][2];
    This is INVALID C++ syntax that causes undefined behavior and heap corruption.
    In C++, you cannot allocate multi-dimensional arrays using new with compile-time
    dimensions like this. This syntax compiles but produces corrupted heap metadata,
    leading to ALL the crashes we've seen:
    - heap_tlsf.c:206 errors (heap free block corruption)
    - multi_heap_poisoning.c:259 errors (heap metadata corruption)
    - Cache access violations (EXCCAUSE: 0x00000007)
    - Random crashes during grid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
    [Calibration.cpp, Calibration.h]
2025-10-07 Fix array allocation size for final grid point access
    Changed allocation from numPoints * 2 to numPoints * 2 + 2 as requested.
    The issue: In generate_calibration_grid(), after the spiral loop completes:
    1. Line 1723: pointCount++ (increments to next index)
    2. Lines 1725-1726: Write to calibrationGrid[GRID_X(pointCount)] and GRID_Y(pointCount)
    3. NO SUBSEQUENT INCREMENT
    This means we access one extra point beyond what calculateGridPointCount() returns.
    The +2 accounts for this final center point (X and Y coordinates).
    Example: If calculateGridPointCount() returns 18, we need space for:
    - Points 0-17 (18 points from calculation)
    - Point 18 (1 additional point written at lines 1725-1726)
    - T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
    [Calibration.cpp]
2025-10-08 Fix off-by-one error in calibration grid point counting
    - Add pointCount++ after storing final grid point
    - Change termination check from > to >= for correct boundary
    - Fixes crash when accessing waypoint beyond array bounds
    [Calibration.cpp]
2025-10-08 Remove return-to-center points from calibration grid
    The return-to-center points were incorrectly included in the grid
    causing extra waypoints to be measured. These points are only for
    machine movement back to center, not for measurements.
    Fixes:
    - 3x3 grid now generates 15 points (not 17)
    - 5x5 grid now generates 31 points (not 33)
    - 7x7 grid now generates 55 points (not 57)
    - 9x9 grid now generates 87 points (not 89)
    Grid generation now matches expected: (gridSize × gridSize) + 6
    [Calibration.cpp]
2025-10-08 Add logging for calibration grid coordinates and measured belt lengths
    - Log all waypoint coordinates after grid generation
    - Log grid size and spacing calculations
    - Log all measured belt lengths when calibration completes
    - Helps diagnose spacing and coordinate issues
    [Calibration.cpp]
2025-10-09 Fix logging to not show uninitialized waypoints 0-5
    Waypoints 0-5 are computed dynamically during calibration based on
    machine position, not during grid generation. The logging was showing
    uninitialized memory for these waypoints.
    - Only log waypoints 6+ in generate_calibration_grid()
    - Add note explaining waypoints 0-5 are computed dynamically
    - Add logging when waypoints 0-5 are actually computed
    - Prevents confusing garbage values in logs
    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
    [Calibration.cpp]
2025-10-09 Revert to working state and add proper logging
    Reverted to commit 7bd946e (working state) and re-added logging:
    - Log all measured belt lengths after calibration completes
    - Includes grid dimensions and spacing information
    - Simple, clean logging without complex logic
    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
    [Calibration.cpp]
2025-10-09 Add detailed calibration grid configuration logging
    Added comprehensive logging similar to previous versions:
    - Grid dimensions and spacing
    - Frame dimensions from kinematics
    - Clearance calculations from frame edges
    - Sanity check with angle at top corners
    - Total waypoints and all coordinates
    Provides detailed diagnostic information for troubleshooting
    calibration grid configuration issues.
    [Calibration.cpp]
2025-10-09 Fix waypoint 0-5 logging to show correct coordinates
    The issue was that waypoints 0-5 were being logged during grid
    generation, but they haven't been computed yet at that point. They
    are computed dynamically after the first measurement completes.
    - Only log waypoints 6+ during grid generation
    - Add note explaining waypoints 0-5 are computed later
    - This shows the correct coordinates (mix of 0 and ±150mm)
    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
    [Calibration.cpp]
2025-10-09 Move grid generation to after first calibration compute
    Grid generation now happens at waypoint 6 (after first compute) instead
    of waypoint 0. This is necessary because:
    - Frame dimensions are unknown at waypoint 0
    - After waypoints 0-5 and calibration compute, frame size is estimated
    - Grid can then be properly calculated with correct dimensions
    - Grid generation moved from waypoint 0 to waypoint 6
    - Waypoint 0 still initializes measurement state
    - Grid logging now shows accurate frame-based dimensions
    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
    [Calibration.cpp]
2025-10-09 Add logging for calibration grid waypoints and belt measurements
2025-10-09 Integrate PR #374 changes and add logging for grid waypoints and belt measurements
2025-10-09 Add missing YAML parameter registrations from PR #374
    [MachineConfig.cpp]
2025-10-09 Add missing MaslowKinematics.cpp changes from PR #374
    [MaslowKinematics.cpp]
2025-10-09 Fix heap crash in waypoint logging by using stringstream instead of String concatenation
    [Calibration.cpp]
2025-10-09 Add belt length logging to each waypoint measurement
2025-10-09 Fix calibration_data array size and add grid calculation logging
    - Update CALIBRATION_GRID_SIZE_MAX from (10*10)+2=102 to 134
    - Use correct formula: 6 initial + spiral points + return points
    - Formula accounts for actual grid generation algorithm: 9 + 4k² + 5k where k=(N-1)/2
    - Add logging for grid generation (size, dimensions, spacing)
    - Add validation to check if point count exceeds max size
    - Support future expansion to 11x11 grids (currently max is 9x9)
    [Calibration.cpp, Maslow.h]
2025-10-09 Integrate all changes from PR #383: dynamic allocation and comprehensive logging
    - Replace static array allocation with dynamic allocation based on actual grid size
    - Add support for non-square grids (separate X and Y dimensions)
    - Add auto-calculation of grid dimensions from frame geometry
    - Change calibrationGrid from 2D array to 1D array with helper macros (GRID_X/GRID_Y)
    - Add comprehensive logging throughout calibration process:
    - Waypoint locations after grid generation
    - Belt measurements for all waypoints
    - Grid configuration details
    - Add calculateGridPointCount() to pre-calculate required memory
    - Modify allocateCalibrationMemory() to accept numPoints parameter
    - Add allocate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
    [Calibration.cpp, Calibration.h, MachineConfig.cpp, Maslow.h, MaslowKinematics.cpp]
2025-10-09 Fix first 6 waypoints recalculation after grid generation
    Instead of simply restoring the saved waypoint coordinates, recalculate them
    using the updated anchor positions after the calibration grid is generated.
    The issue was that waypoints 0-5 coordinates were calculated at waypoint 0
    with the initial anchor positions. After waypoint 5, the anchors are updated
    through calibration calculations, but the saved waypoint coordinates were
    still using the old anchor positions.
    The fix:
    - Save only the calibration_data (belt measurements) for waypoints 0-5
    - After grid generation with updated anchors, recompute the XY position from
    the saved belt measurements
    - Recalculate waypoint 0-5 coordinat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
    [Calibration.cpp]
2025-10-09 Add detailed logging of individual measurements before averaging
    Added logging to show all 4 individual measurement runs before they are
    averaged for each waypoint. This helps debug issues where belt lengths
    appear incorrect by showing the raw measurements that go into the average.
    The logging now shows:
    - Individual measurements for each of the 4 runs
    - The final averaged belt length values
    This matches the debugging approach from PR #383 where individual measurement
    logging helped verify measurement accuracy.
    [Calibration.cpp]
2025-10-09 Fix waypoint 0 measurement: use averaged calibration_data instead of first measurement run
    The code was using measurements[0][...] (only the first of 4 measurement runs)
    for position calculation and frame size validation at waypoint 0, but logging
    the averaged calibration_data values. This caused the logged values to appear
    correct while the actual calculations used potentially inaccurate single
    measurements.
    Changed to use calibration_data[0][...] (the averaged values) for:
    - Computing XY position from belt lengths
    - Calculating frame size validation differences
    This ensures consistency between what's logged and what's used for calculations,
    and uses more accurate averaged measurements in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
    [Calibration.cpp]
2025-10-09 Fix crash in individual measurement logging by using single stringstream
    The previous implementation logged each measurement run as a separate log_info
    call, which could cause heap/stack overflow or memory corruption issues on the
    ESP32 when multiple log calls happen rapidly.
    Changed to use a single stringstream that builds the entire log message before
    outputting it. This matches the pattern used elsewhere in PR #383 to avoid
    heap crashes and is more efficient.
    The output format is now more compact:
    "Waypoint 0 measurements: [0:TL=185.03,TR=188.53,BL=184.96,BR=181.04] [1:...] [2:...] [3:...]"
    This prevents the crash that occurred after logging only Run 0.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
    [Calibration.cpp]
2025-10-09 Add debug logging to measurementToXYPlane to diagnose measurement issue
    The measurements are consistently about half of expected values (~185mm vs ~385mm).
    Added detailed logging to see:
    - Input measurement value from encoder
    - Z height value
    - Belt extension and arm length values
    - Intermediate lengthInXY calculation
    - Final result
    This will help identify where the factor-of-2 discrepancy is coming from.
    [Calibration.cpp]
2025-10-09 Fix calculateGridPointCount to match actual spiral generation logic
    The calculation was underestimating the number of points needed, causing a crash
    at waypoint 14 when trying to access calibration_data[14] but only 14 points were
    allocated (indices 0-13).
    The issue was that calculateGridPointCount used a simple for loop but the actual
    generate_calibration_grid uses a while loop with conditions "maxX <= numberOfCycles
    || maxY <= numberOfCycles", which continues longer for non-square grids.
    Fixed by rewriting calculateGridPointCount to exactly match the spiral generation
    logic, including:
    - Using while loop with same condition
    - Checking maxX/maxY against numberOfCyclesX/numberOfCyclesY bef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
    [Calibration.cpp]
2025-10-09 Fix debug logging bug in measurementToXYPlane
    The debug logging had a logic error where the second log statement checked
    `if (!logged)` after already setting `logged = true`, so it would never execute.
    Also changed from logging only once to logging the first 4 calls (one for each
    belt on the first measurement), which provides better debugging information
    while still avoiding log spam.
    The logging now properly shows:
    - Input measurement, Z height, belt extension, and arm length
    - Calculated lengthInXY and final result
    - For the first 4 function calls (TL, TR, BL, BR on first measurement)
    [Calibration.cpp]
2025-10-10 Fix missing BL and BR motor target initialization at calibration start
    When transitioning to CALIBRATION_IN_PROGRESS state, only TL and TR motor
    targets were being set to their current positions. BL and BR were missing,
    which caused them to default to 0 and triggered unwanted motor movements
    that zeroed out the belt positions.
    This bug was introduced during PR #383 integration and caused:
    - Belt positions to be reset from ~-400mm to ~0mm at calibration start
    - NaN results in measurementToXYPlane due to negative values under sqrt
    - Measurements showing ~-33mm instead of expected ~-400mm
    Fixed by adding the missing setTarget calls for axisBL and axisBR.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
    [Calibration.cpp]
2025-10-10 Add diagnostic logging for motor positions before setTarget
    Added logging to show what getPosition() returns for each motor before
    calling setTarget. This will help identify if positions are already 0
    at the time of the state transition, or if they're being reset elsewhere.
    The logging will show:
    - Motor positions (TL, TR, BL, BR) right before setTarget is called
    - This helps diagnose why positions appear to be 0 instead of ~-400mm
    [Calibration.cpp]
2025-10-10 Fix motor position reset by updating encoders before reading positions
    The root cause was that getPosition() returns cached encoder values from
    mostRecentCumulativeEncoderReading, which is only updated periodically by
    the round-robin encoder reading loop (once per second divided by
    ENCODER_READ_FREQUENCY_HZ).
    When transitioning to CALIBRATION_IN_PROGRESS state, if the encoder positions
    hadn't been updated recently, the cached values would be stale or 0, even
    though the physical encoders showed ~-400mm.
    The fix explicitly calls updateEncoderPosition() for all 4 motors before
    reading their positions during the state transition. This ensures we get
    fresh encoder readings and preserves the bel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
    [Calibration.cpp]
2025-10-10 Fix calculateGridPointCount to exactly simulate spiral generation logic
    The previous fix was still incorrect - it tried to calculate the number of
    points added by each direction, but didn't actually simulate the while loops
    that generate the points.
    The actual generate_calibration_grid uses while loops with incrementing/
    decrementing counters (currentX, currentY) to add points. The calculation
    must do the same thing to get an accurate count.
    Changed calculateGridPointCount to:
    - Use the same currentX/currentY variables and starting positions
    - Execute the same while loop conditions (currentX > -1*maxX, etc.)
    - Increment count for each point added, just like pointCount++ in generation
    - Mat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
    [Calibration.cpp]
2025-10-10 Reduce log spam: convert debug logging to log_debug level
    Changed the following logs from log_info to log_debug:
    - measurementToXYPlane conversion logs (removed "DEBUG" from message)
    - Individual waypoint measurements logs
    These detailed logs are useful for debugging but create too much noise
    during normal calibration runs. They can now be enabled when needed by
    setting the debug log level.
    [Calibration.cpp]
2025-10-10 Fix calculateGridPointCount: corner point only added when directions actually move
    The calculation was unconditionally adding the corner point after each cycle,
    but in generate_calibration_grid (line 1786-1788), it only adds a point if
    at least one direction moved. When both maxX and maxY exceed their respective
    numberOfCycles boundaries, no points are added in any direction, but we were
    still counting the corner point.
    The fix: Only count the corner point when we're still within the cycle bounds,
    matching the actual generation behavior. For a 6x6 grid with numberOfCyclesX=2
    and numberOfCyclesY=2, this correctly counts 6 + 36 + 2 = 44 points instead of
    the incorrect 33.
    Fixes the crash whe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
    [Calibration.cpp]
2025-10-10 Fix calculateGridPointCount: only add 1 for return-to-center, not 2
    The generation code (lines 1799-1807) has a bug/quirk where it only increments
    pointCount once (line 1802) even though it creates 2 return-to-center waypoints
    (lines 1800-1805). This means:
    - pointCount ends up as 33 for a 6x6 grid
    - Array indices run from 0-32 (33 total slots needed)
    - But the calculation was adding 2, giving 35
    Fixed by changing the return-to-center addition from 2 to 1, matching the actual
    generation behavior. For a 6x6 grid: 6 fixed + 1 center + 25 spiral + 1 = 33.
    [Calibration.cpp]
2025-10-10 Fix calculateGridPointCount: allocate space for both return-to-center waypoints
    The generation code (lines 1799-1807) creates TWO return-to-center waypoints:
    - Line 1800-1802: First waypoint, pointCount incremented
    - Line 1804-1805: Second waypoint, pointCount NOT incremented
    Even though pointCount only increments once, BOTH waypoints are physically stored
    in the calibration_data array. The crash at waypoint 31 (trying to store waypoint 32)
    happened because we only allocated 33 slots (0-32) but need 34 (0-33) to store both
    return-to-center points.
    For a 6x6 grid: 6 fixed + 1 center + 25 spiral + 2 return = 34 total waypoints needed.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
    [Calibration.cpp]
2025-10-10 Reduce belt length logging batch size from 5 to 3 waypoints per message
    The heap was running out of memory when building stringstream log messages with
    5 waypoints worth of data. Each waypoint logs 4 belt lengths with labels, which
    creates a very long string. Reducing to 3 waypoints per message reduces memory
    pressure and should prevent heap overflow during the logging phase.
    This is a conservative fix to ensure calibration can complete successfully even
    on constrained embedded systems.
    [Calibration.cpp]
2025-10-10 Replace stringstream with direct log_info for belt measurements
    Switched from building large stringstream messages to logging each waypoint
    individually. This completely eliminates the stringstream heap allocation that
    was causing crashes. Each waypoint now gets its own log message, which is more
    memory-efficient and prevents heap overflow.
    This approach matches the pattern used successfully elsewhere in the codebase
    for logging large amounts of data.
    [Calibration.cpp]
2025-10-10 Add soft limits check at MotorUnit level to prevent belt over-extension
    [MotorUnit.cpp, MotorUnit.h]
2025-10-10 Fix axis bounds check to use runtime axis count
    [MotorUnit.cpp]
2025-10-17 Refactor soft limits check to centralized motor control wrappers
2025-10-30 Fix retraction failure by only checking soft limits on forward motion
    [MotorUnit.cpp]
2025-10-30 Fix soft limits check to handle FluidNC coordinate system correctly
    [MotorUnit.cpp]
2025-10-30 Add detailed diagnostic logging to track soft limit values during extension
2025-11-05 Rename config variables to prevent confusion with old absolute values
    [MachineConfig.cpp]
2025-11-05 Add testArmCurrent command for determining minimum motor current
2025-11-05 Create enum for arm/motor ordering (TL, TR, BL, BR)
2025-11-05 Convert per-arm axis variables to array with loop-based operations
2025-11-27 Clarify calibration loop flow in state diagrams
2025-12-03 Fix Y-axis calibration error by correcting Z-component in horizontal mode
    [MaslowKinematics.cpp]
2025-12-03 Fix calibration measurement Z-component handling for horizontal mode
    [Calibration.cpp]
2025-12-03 Fix calibration Y-axis error by including material thickness in measurements
    The root cause was that calibration measurements projected belt lengths using only
    anchor Z-heights, while runtime kinematics included spoilboard and work thickness.
    This mismatch caused systematic errors when users had material thickness configured.
    During calibration with material (e.g., 10mm spoilboard):
    - Measurements projected with anchorZ only (e.g., 100mm)
    - Runtime used anchorZ + material (e.g., 110mm)
    - This made cuts appear ~3-8% too small in Y-axis
    Fixed by including material thickness in calibration measurement projections,
    matching the runtime kinematics calculations.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
    [Calibration.cpp, Calibration.h, MaslowKinematics.cpp, MaslowKinematics.h]
2025-12-03 Revert material thickness changes - investigating gravity-related kinematics issue
    Per user feedback, the Z-axis calculations are correct. The issue is likely related
    to "lack of gravity in y axis" in horizontal mode. Investigating whether:
    1. Arm length value (123.4mm) is correct for horizontal orientation
    2. Belt elasticity/tension effects need compensation
    3. Some implicit assumption in kinematics needs adjustment
    Current status: kinematics formulas are mathematically consistent, but may have
    wrong parameters or missing physical compensation for horizontal mode.
    [Calibration.cpp]
2025-12-03 Fix calibration measurement Z-component to match runtime kinematics
    The root cause is a mismatch between calibration and runtime Z-component calculations:
    During calibration measurements:
    - Belt lengths include Z-component: c = -(z + anchorZ + spoilboard + work)
    - But projection only used anchorZ: sqrt(measurement² - anchorZ²)
    - Missing spoilboard/work thickness in projection
    During runtime kinematics (computeTL/TR/BL/BR):
    - Full Z-component used: c = -(z + anchorZ + spoilboard + work)
    - Consistent calculation throughout
    This mismatch causes calibration data to be incorrectly projected to XY distances,
    leading to systematic errors when users have material thickness configured. Even
    with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
    [Calibration.cpp]
2025-12-06 Add command delays to prevent ESP32 command buffer overflow during calibration
2025-12-06 Batch calibration commands into single transmission to reduce HTTP overhead
2025-12-06 Fix auto-calibration grid Y-axis squishing by using equal frame percentages
    [Calibration.cpp]
2025-12-07 Reduce grid size to 40% to avoid edge tension and sled lifting
    [Calibration.cpp]
2025-12-08 Replace random calibration retry with deterministic strategy
    - Replace Math.random() perturbations with 5 systematic patterns
    - Add MAX_RETRY_ATTEMPTS (5) to prevent infinite loops
    - Reset theta values at start of calibration and before each retry
    - Ensure consistent initial conditions across calibration runs
    - Add retry attempt counter and display progress to user
    - Save best result even if fitness threshold not reached after max retries
2025-12-15 Reset initialGuess at start of new calibration run
    - Detect new calibration run when measurements.length === 6 (first stage)
    - Reset initialGuess to default values for consistent starting point
    - Allow subsequent stages to use previous stage result
    - Add logging to show when reset occurs vs continuation
2025-12-16 Fix handling of zero values and clarify comment about work area dimensions
    [toolpath-displayer.js]
2025-12-16 Fix work area to be positioned relative to machine frame, not home position
    [toolpath-displayer.js]
2025-12-16 Clarify comments about frame center calculation and transform assumptions
2025-12-16 Improve clarity of frame center calculation comments
2025-12-16 Exclude work area from bounding box calculation to prevent view shifts
    [toolpath-displayer.js]
2025-12-16 Fix Z coordinate references in anchor point conversion
    [toolpath-displayer.js]
2025-12-16 Revert to original coordinate system approach - use centering transform without WCO
    [toolpath-displayer.js]
2025-12-16 Fix Z coordinate consistency in WPOS to MPOS conversions
    [toolpath-displayer.js]
2025-12-16 Add fallback for undefined WCO/WPOS to fix tool display and home position
    [toolpath-displayer.js]
2025-12-16 Fix machine coordinate system - restore centering transform for anchor points
    [toolpath-displayer.js]
2025-12-16 Fix WCO/WPOS access - use global variables instead of window properties
    [toolpath-displayer.js]
2025-12-16 Fix origin display update - redraw origin in showToolPosition
    [toolpath-displayer.js]
2025-12-16 Remove drawOrigin call from transformCanvas to fix stale WCO issue
    [toolpath-displayer.js]
2025-12-16 Fix origin display and remove console.log statements
    [toolpath-displayer.js]
2025-12-16 Fix origin projection for angled views - use Z=0 for work surface plane
    [toolpath-displayer.js]
2025-12-16 Fix home position update to wait for both X and Y, and fix G-code bounding box calculation
    [toolpath-displayer.js]
2025-12-17 Fix bounding box to use machine coordinates matching drawn G-code paths
    [toolpath-displayer.js]
2025-12-17 Fix job bounding box to convert work coords to machine coords when drawing
    [toolpath-displayer.js]
2025-12-17 Fix envelope not updating when home position changes - call drawJobBoundingBox in showToolPosition
    [toolpath-displayer.js]
2025-12-19 Fix bounding box calculation for arcs (G2/G3)
    The world coordinate bounding box fallback was only using end.x/end.y
    instead of both start and end positions. This caused incorrect bounding
    boxes for arcs where:
    - Start and end X values are the same
    - Start and end Y values are the same
    - Short arcs with large radius
    - Arcs contained in a single quadrant
    Fixed to match the correct pattern already used for projected coordinates.
    [toolpath-displayer.js]
2025-12-22 Save belt positions when calibration is interrupted via stop command
2025-12-23 Implement tension hold and flexible state transitions
2025-12-23 Address code review feedback: fix log message and remove unused variable
    [Calibration.cpp, MotorUnit.cpp, MotorUnit.h]
2025-12-23 Use named constant for tension hold duration
2025-12-23 Allow transitions between retract, extend, and release tension states
2025-12-25 Add plasma cutter relay configuration documentation and examples
2025-12-25 Fix comment alignment in plasma cutter example config
    [maslow_plasma_cutter.yaml]
2025-12-29 Convert per-arm variables and functions to enum-indexed arrays
    - Add MaslowArm and CartesianAxis enums to Maslow.h
    - Convert axis variables (axisTL/TR/BL/BR) to axis[ARM_COUNT] array
    - Convert TelemetryData fields to arrays (Current[], Power[], Speed[], Pos[], State[], extended[])
    - Convert extended[] and retracting[] variables in Calibration class to arrays
    - Replace individual anchor coordinates with anchor_location[ARM_COUNT][Coord_COUNT] 2D array in MaslowKinematics
    - Add generic compute(int arm, ...) function in MaslowKinematics
    - Add getAnchorCoord(int arm, int axis) function for anchor coordinate access
    - Convert sequential per-arm operations to loops throughout codebase
    - Update save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
    [Calibration.cpp, Calibration.h, Maslow.cpp, Maslow.h, MaslowKinematics.cpp, MaslowKinematics.h]
2025-12-29 Address code review feedback: Replace hardcoded 4 with ARM_COUNT constant
    - Replace all instances of hardcoded 4 with ARM_COUNT constant for consistency
    - Ensures loops are bounds-checked against the enum constant
    - Verified build succeeds with wifi_s3 environment
    [Maslow.cpp]
2025-12-29 Implement incremental calibration measurement sending
    - Add print_single_measurement() to send individual measurements
    - Modify calibration_loop to send measurements after first 6 points
    - Add browser-side processIncrementalMeasurement() for incremental processing
    - Browser now updates anchors when fitness threshold is met
    - Measurements sent immediately after collection for concurrent processing
2025-12-29 Keep all measurements after anchor updates for continuous improvement
    - Don't clear measurement buffer when anchors are updated
    - Measurements remain valid as they reflect actual belt lengths
    - Improved anchors make future calculations more accurate
    - Allows continuous refinement throughout calibration process
2025-12-29 Add comprehensive documentation for incremental calibration
    - Document architecture and design decisions
    - Explain calibration flow with diagrams
    - Provide troubleshooting guide
    - Include API reference and testing recommendations
    - Detail future optimization opportunities
2026-01-09 Fix fitness calculation in incremental calibration
    The fitness values were inverted incorrectly. The raw fitness from
    computeLinesFitness is already a small error value (e.g., 0.0000022),
    and inverting it gives the display fitness (e.g., 0.5).
    Fixed by:
    - Store raw fitness in currentBestGuess.fitness (not inverted)
    - Calculate displayFitness = 1 / currentBestGuess.fitness for display
    - Compare 1/workingGuess.fitness > 1/currentBestGuess.fitness
    - Check displayFitness > threshold (not inverted value)
    This resolves the issue where fitness showed 458274 instead of 0.5
2026-01-09 Fix fitness calculation and add background optimization
    Two major fixes:
    1. Include initial 6 measurements in incremental optimization
    - Was only using incremental measurements, causing incorrect fitness
    - Now combines initialMeasurements + incrementalMeasurements
    - This fixes the absurdly high fitness values (312321 vs 0.5)
    2. Implement background optimization as requested
    - Start full 200K iteration optimization in background
    - Continues running while ESP32 takes more measurements
    - When threshold met, immediately sends anchors to firmware
    - Optimization continues to find best possible answer
    - Provides progress updates every 100 iterations
    This allows concurrent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
2026-01-25 Replace random starting point guesses with specific aspect ratios on arc
    Instead of using random point selection when calibration fails, the system now:
    - Uses a predefined sequence of aspect ratios: 2:1, 1:1, 1:2, 1.5:1, 1:1.5
    - Calculates new points on the arc using these aspect ratios
    - Falls back to random offsets only after exhausting the aspect ratio sequence
    - Provides better feedback in the UI about which aspect ratio is being tried
2026-01-25 Address code review feedback: simplify radius calculation and fix fallback coordinates
    - Simplify optimalRadius calculation from sqrt(a²+a²) to a*sqrt(2)
    - Add missing coordinate assignments in fallback random offset logic (bl.x, bl.y, br.y)
    - Ensures all four corner coordinates are properly updated in fallback case
2026-01-27 Fix infinite calibration loop and aspect ratio indexing
    - Remove automatic calibration restart after successful completion to prevent infinite loop
    - Fix aspect ratio sequence indexing: now correctly starts with 2:1, then 1:1, 1:2, 1.5:1, 1:1.5
    - Users must manually click "Calibrate" again if calibration has multiple stages
2026-01-27 Restore auto-restart for multi-stage calibration with proper completion detection
    - Restore automatic calibration restart after each successful stage
    - Add calibrationComplete flag to track when firmware signals all stages are done
    - Check flag before auto-restarting to prevent infinite loop
    - Reset flag when user manually starts calibration
    - Auto-restart continues to next stage unless firmware signals completion
2026-01-27 Fix global variable declaration order for calibrationComplete flag
    - Move calibrationComplete declaration to maslow.js (loads first)
    - Remove duplicate declaration from calculatesCalibrationStuff.js
    - Add comment explaining the flag location
    - Ensures variable is available when tablet.js and other files reference it
2026-01-27 Add state definitions API with button labels
2026-01-27 Update UI to fetch state definitions and use dynamic button labels
2026-01-27 Fix state transition logic to match original behavior
    [Calibration.cpp, MaslowEnums.h]
2026-01-27 Make UNKNOWN state only accessible via error conditions, not normal transitions
    [Calibration.cpp, MaslowEnums.h]
2026-01-27 Disable jog controls when not in Ready To Cut state with visual feedback
2026-01-27 Fix jog restrictions to apply to tablet tab purple arrow buttons instead of controls tab
2026-01-27 Add dynamic state transition buttons on Maslow tab with Release Tension always visible
2026-01-28 Report state to UI when loadBeltPositions fails or state is set at boot
    [Maslow.cpp]
2026-01-28 Send current state to UI when WebSocket connects instead of adding special error handling
    [WSChannel.cpp]
2026-01-28 Send state message after startup log dump to avoid interleaving
    [WSChannel.cpp]
2026-01-28 Fix state message not being sent by including Maslow.h header
    [WSChannel.cpp]
2026-01-29 Add debug logging to diagnose state message delivery issue
    [WSChannel.cpp]
2026-01-29 Add comprehensive debug logging to trace WebSocket connection and state message delivery
2026-01-29 Add exception handling and MASLOW_CREATE ifdef guard to prevent crash when accessing Maslow object
    [WSChannel.cpp]
2026-01-29 Remove incorrect MASLOW_CREATE ifdef guard that was preventing state message code from compiling
    [WSChannel.cpp]
2026-01-29 Remove verbose debug logging that was causing crash when accessing Maslow state during WebSocket connection
    [WSChannel.cpp]
2026-01-29 Remove problematic WebSocket state-sending code that was crashing during early initialization
    [WSChannel.cpp]
2026-01-29 Add printCurrentState() call at end of Maslow initialization to report state to UI after boot
2026-01-29 Fix state label showing blank instead of "Unknown" by updating label before checking stateDefinitions
    [Maslow.cpp, WSChannel.cpp]
2026-01-29 Add explicit flush() after STATEDEFS command to prevent buffer truncation
    The STATEDEFS JSON response is ~1026 bytes, close to the WebSocket TX buffer size of 1200 bytes. Without an explicit flush, the next command could be appended before the buffer is sent, causing the JSON to be truncated and concatenated with other output. This fix ensures the complete JSON is sent immediately.
    [ProcessSettings.cpp]
2026-01-29 Call updateDynamicButtons() after UI elements are created in show_main_UI()
    The state data is fetched in initUI step 1, but the DOM elements (jog buttons, control buttons, etc.) are not created until step 3-4. When fetchStateData() completes and calls updateDynamicButtons(), those elements don't exist yet. This fix adds a second call to updateDynamicButtons() in show_main_UI() after all DOM elements have been created, ensuring the UI is updated with the correct state-based button colors, overlays, and dynamic controls.
2026-01-29 Add comprehensive console logging to debug state UI update timing issues
    Added detailed logging throughout the state update flow to diagnose why button colors, jog overlays, and dynamic controls aren't being applied:
    - fetchStateData(): logs when state data is fetched and parsed
    - updateDynamicButtons(): logs when called, current state, whether definitions loaded, which DOM elements exist/missing
    - updateTabletJogUIState(): logs jogging state and missing jog button elements
    - updateControlButtonsRow(): logs control button row element existence
    - show_main_UI(): logs when DOM elements should be created
    - State change handler: logs when machine state changes
    - initUI(): logs timing of initiali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
2026-01-29 Add enhanced debugging to diagnose fetchStateData parsing issues
    The console logs show responseText appears empty despite JSON being received. Added detailed logging to check:
    - responseText type and length
    - Whether responseText is actually empty/null
    - Full error details including message and stack trace
    - Each state being processed
    - Object keys if 'states' field is missing
    This will reveal whether SendGetHttp is calling the callback with empty responseText or if there's a JSON parsing issue.
2026-01-29 Fix jog button tooltips and improve overlay behavior
    Fixed tooltip display on disabled jog buttons:
    - Removed pointer-events:none from overlay div so tooltips can show
    - Added tooltip text to overlay div itself (title attribute)
    - Update tooltip text if overlay already exists when state changes
    - Changed overlay cursor to not-allowed
    - Button tooltips now properly display when hovering over greyed-out jog arrows
    This ensures users get clear feedback about why jogging is disabled even when the overlay is present.
2026-01-29 Allow UNKNOWN state to transition to RETRACTING for emergency retract-all
    Fixed issue where UNKNOWN state had no allowed transitions, preventing retract-all button from working. Now UNKNOWN state can transition to RETRACTING, allowing users to safely retract belts even when the machine is in an unknown state.
    - Updated MaslowEnums.h: UNKNOWN state now allows transition to RETRACTING
    - This enables retract-all button in unknown state for safety
    Note: Settings modal dismissal issue is being investigated - appears to be unrelated to state transition changes.
    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
    [MaslowEnums.h]
2026-01-29 Keep Z jog buttons always enabled and allow UNKNOWN->RELEASE_TENSION transition
    1. Z up/down jog buttons now always enabled - only XY directional arrows are disabled when not in Ready To Cut state
    2. Added RELEASE_TENSION to UNKNOWN state's allowed transitions for emergency tension release
    3. Updated MaslowEnums.h: UNKNOWN can now transition to both RETRACTING and RELEASE_TENSION
    This ensures users can always adjust Z height and release tension even when the machine is in an unknown state.
    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
2026-01-29 Fix settings modal z-index to appear above jog button overlays
    The settings modal was becoming unclickable after updateDynamicButtons() ran because the jog button overlays (z-index: 10) were appearing above the modal which had no z-index set (defaulting to 0).
    - Added z-index: 1050 to .calibration-modal-container
    - Added z-index: 1051 to .calibration-modal-content
    - This ensures the modal and its content appear above all jog button overlays
    This fixes the issue where clicking the Setup button would show the modal but it couldn't be dismissed and its buttons were unclickable.
    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
2026-01-29 Keep play/pause, stop, and idle/alarm buttons always visible with state-based disable
    Changed control buttons row behavior as requested:
    - Play/pause, stop, and idle/alarm buttons now always visible (not hidden in non-Ready states)
    - Play/pause button disabled when not in Ready To Cut state by:
    - Changing background color to grey (#a0a0a0)
    - Setting cursor to not-allowed
    - Disabling pointer events
    - Adding tooltip explaining state requirement
    - Stop and idle/alarm buttons remain functional in all states
    - Removed dynamic button creation logic that showed different buttons based on state
    This provides better UI consistency while maintaining safety by disabling play/pause when inappro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
2026-01-29 Move Release Tension button from separate row to jog grid position (5,4)
    Moved Release Tension button as requested:
    - Removed standalone Release Tension button row (row 6) that was creating a large green area
    - Placed Release Tension button in jog button grid at position (5,4) - to the right of "Define XY Home" button
    - Button still dynamically colored green/grey based on whether transition is allowed
    - Simplified JavaScript to just update button color without display property manipulation
    This fixes the UI layout issue and places the Release Tension button in a more logical position within the control grid.
2026-01-29 Fix control buttons to preserve symbols and keep Alarm button clickable
    Fixed issues with control buttons row:
    - Changed from recreating HTML to updating existing button properties
    - This preserves the canvas elements that draw play/pause and stop symbols
    - Idle/Alarm status div remains as-is (it's a status display, not a button that toggles alarm)
    - Only updates play/pause button styling (color, cursor, pointer-events) based on state
    - Stop button remains unchanged (always enabled, red)
    The buttons now display their symbols correctly and the status indicator shows the current system state.
2026-01-29 Change play/pause button disabled style to use grey icon instead of grey background
    Changed disabled play/pause button styling as requested:
    - When disabled: grey background (#a0a0a0) with dark grey triangle icon (#666666)
    - When enabled: green background (#4aa85c) with white triangle icon
    - Redraws canvas with appropriate color based on state
    - Includes pointer-events disabled and tooltip when not in Ready To Cut state
    - Matches jog button disable behavior: unavailable mouse interaction and clear visual feedback
    This provides consistent visual feedback across all disabled controls.
2026-01-29 Remove allowed transitions FROM UNKNOWN state
    Changed UNKNOWN state handling as requested:
    - UNKNOWN now has empty allowedTransitions array { -1, -1, -1, -1, -1 }
    - Special handling still allows ANY state to transition TO UNKNOWN (for error conditions)
    - UNKNOWN can no longer transition to any other state via normal user actions
    - Updated comments to clarify: UNKNOWN is an error state that can only be entered, not exited
    This makes UNKNOWN a true error/stuck state. Previously UNKNOWN could transition to RETRACTING or RELEASE_TENSION, but this was confusing since the special bypass handling made it seem like UNKNOWN could go anywhere. Now the special handling only applies when transitioning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
    [MaslowEnums.h]
2026-01-29 Restore RETRACTING and RELEASE_TENSION transitions from UNKNOWN and add rejection logging
    Fixed three issues as requested:
    1. Restored RETRACTING and RELEASE_TENSION to UNKNOWN's allowedTransitions for emergency operations
    2. Changed rejected transition log from log_info to log_warn with clearer message "State transition rejected:"
    3. This fixes the issue where machine gets stuck in RELEASING state when coming from UNKNOWN
    The problem was that RELEASE_TENSION state tries to transition back to UNKNOWN (line 432 in Calibration.cpp) when previousState is UNKNOWN, but with empty allowedTransitions that was being rejected, leaving the machine stuck in RELEASING state.
    Now:
    - UNKNOWN→RETRACTIN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
    [Calibration.cpp, MaslowEnums.h]
2026-01-29 Add UNKNOWN to RELEASE_TENSION's allowed transitions to fix stuck state
    Fixed issue where RELEASE_TENSION state gets stuck when machine was in UNKNOWN state before releasing tension.
    The problem: Calibration.cpp line 432 tries to transition from RELEASE_TENSION back to UNKNOWN when previousState is UNKNOWN, but RELEASE_TENSION's allowedTransitions array didn't include UNKNOWN, causing the transition to be rejected.
    Solution: Added UNKNOWN to RELEASE_TENSION's allowedTransitions array: { EXTENDEDOUT, UNKNOWN, RETRACTING, -1, -1 }
    Now the state transition flow works correctly:
    - UNKNOWN → RELEASE_TENSION (emergency operation)
    - RELEASE_TENSION → UNKNOWN (completes the cycle)
    The warnin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
    [MaslowEnums.h]
2026-01-29 Add diagnostic logging for RELEASE_TENSION state investigation
    Added debug logging to help diagnose why RELEASE_TENSION state doesn't transition back to UNKNOWN:
    1. In Calibration.cpp RELEASE_TENSION case:
    - Log when home() is called with timer value
    - Log which state it will transition to when timer expires
    2. In Maslow.cpp main loop:
    - Log when RELEASE_TENSION state is active and home() IS being called (sys.state=Homing)
    - Log when RELEASE_TENSION state is active but home() is NOT being called (sys.state != Homing)
    This will reveal whether:
    - home() function is being called at all when in RELEASE_TENSION state
    - sys.state is correctly set to State::Homing when entering RELEA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
    [Calibration.cpp, Maslow.cpp]
2026-01-29 Add enhanced diagnostic logging to identify sys.state during RELEASE_TENSION
    Added comprehensive diagnostics to determine why RELEASE_TENSION doesn't transition back to UNKNOWN:
    1. Log sys.state at the start of the Maslow state machine (before if/else chain)
    2. Log when RELEASE_TENSION enters the Jog/Cycle branch (which would prevent home() from being called)
    3. Show all state enum values for comparison
    The absence of previous diagnostic logs suggests sys.state is NOT State::Homing when in RELEASE_TENSION, which would explain why home() never runs and the timer logic never executes.
    Most likely scenario: sys.state is being set to something other than State::Homing (possibly State::Idle or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
    [Maslow.cpp]
2026-01-29 Add diagnostic to check if calibration.holding blocks RELEASE_TENSION
    The absence of all previous diagnostic logs indicates the Maslow state machine code never runs when in RELEASE_TENSION state.
    Root cause hypothesis: The `calibration.holding` flag at line 183 causes an early return from Maslow.update(), preventing the state machine code (including all diagnostic logs) from ever executing.
    Added diagnostic log to confirm if RELEASE_TENSION is being blocked by the holding flag, showing:
    - holdTime value
    - Elapsed time since holdTimer was set
    If this log appears, it confirms the holding flag is preventing the RELEASE_TENSION timer logic from running. The solution would be to either:
    1. Not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
    [Maslow.cpp]
2026-01-29 Fix compilation error: cast unsigned long to int for log_info
    Fixed ambiguous operator<< error by casting millis() results to int before passing to log_info macro.
    The log_info macro doesn't have an overload for unsigned long, so explicit casting to int is required for holdTime and elapsed time calculations.
    [Maslow.cpp]
2026-01-29 Fix diagnostic placement: log BEFORE early return check
    Moved RELEASE_TENSION diagnostic to fire unconditionally before the calibration.holding early return check. The previous diagnostic was inside a conditional that required holding to be true, but was placed after the code that would return early.
    Now logs every loop iteration when in RELEASE_TENSION state, showing:
    - calibration.holding value (true/false)
    - holdTime setting
    - elapsed time since holdTimer was set
    This will definitively show whether:
    1. Maslow.update() is being called at all when in RELEASE_TENSION
    2. The holding flag is preventing execution
    3. The timer values that control the automatic state transition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
    [Maslow.cpp]
2026-01-29 Add comprehensive entry diagnostic for RELEASE_TENSION state
    Added diagnostic logging at RELEASE_TENSION state entry to track:
    - Confirmation when state is first entered
    - Value of complyCallTimer at entry
    - Current sys.state() value at entry
    1. State entry code executes at all
    2. sys.state is correctly set to State::Homing at entry (as ProcessSettings.cpp line 949 intends)
    3. Timer is initialized properly
    Combined with existing diagnostics in Maslow loop, this creates complete visibility:
    - Entry: "Entering RELEASE_TENSION state NOW" + sys.state value
    - Loop: Whether home() is called or skipped based on sys.state
    - Timer: Progress through RELEASE_TENSION logic
    I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
    [Calibration.cpp]
2026-01-31 Simplify to direct grid search over frame dimensions
2026-01-31 Add documentation explaining the calibration system improvements
2026-01-31 Refactor: Extract shared calibration functions to calibration-helpers.js
2026-02-01 Fix WiFi disconnect issue: faster pings and status recovery on reconnect
    [WebServer.cpp]
2026-02-06 Replace random retry points with aspect ratio-based points
    - Eliminate random perturbations (±50mm) in retry logic
    - Add 5 predefined aspect ratios: 2:1, 1.5:1, 1:1, 1:1.5, 1:2
    - Calculate retry points on arc found in phase 2 using optimal radius
    - Apply changes identically to ESP3D-WEBUI and data-parser simulator
    - Keep MAX_LOW_FITNESS_RETRIES = 10 limit unchanged
2026-02-06 Preserve random perturbations when phase 1&2 are skipped
    - When optimalRadius is null (phases 1&2 skipped), use old random behavior
    - When optimalRadius is available, use new aspect ratio approach
    - Applies to both calculatesCalibrationStuff.js and data-parser.html
    - Ensures backward compatibility for multi-iteration calibration
2026-02-09 Fix connection monitor to work during GCode execution and prevent garbled messages
    [ProcessSettings.cpp]
2026-02-10 Replace ECHO-based monitoring with HTTP health endpoint pings
    [ProcessSettings.cpp]
2026-02-10 Fix: Prevent Home state from interfering with READY_TO_CUT state
    Added CALIBRATION_IN_PROGRESS and READY_TO_CUT to the exclusion list in the home() cleanup logic. This prevents the redundant sys.set_state(State::Idle) call from interfering with state transitions when calibration completes.
    [Calibration.cpp]
2026-02-10 Optimize READY_TO_CUT state transition to avoid unnecessary state changes
    [Calibration.cpp]
2026-02-10 Fix log messages to use correct tense before state transitions
    [Calibration.cpp]
2026-02-10 Simplify logging and fix tense consistency in state transitions
    [Calibration.cpp]
2026-02-10 Remove redundant comment and fix comment spelling
    [Calibration.cpp]
2026-02-10 Add state check for UNKNOWN transition and fix tense consistency
    [Calibration.cpp]
2026-02-10 Fix comment accuracy and tense consistency in log messages
    [Calibration.cpp]
2026-02-10 Change FluidNC state to Homing when Maslow enters RETRACTED state
2026-02-12 Add extensive logging to debug FluidNC state synchronization issue
    [Calibration.cpp]
2026-02-14 Implement Z-axis management for pause/stop to prevent belt relaxation
    [Protocol.cpp]
2026-02-14 Add named constants for Z-axis and belt management parameters
2026-02-14 Fix infinite loop: always set z_was_raised flag to prevent repeat cycles
    [Protocol.cpp]
2026-02-14 Remove belt relaxation/tightening - just power off/on motors instead
    [Protocol.cpp]
2026-02-15 Fix Z-raise to always move to Z=0 regardless of position, add debug logging
    [Protocol.cpp]
2026-02-15 Remove motor power-off during pause - keep motors powered to prevent sled from falling
    [Protocol.cpp]
2026-02-16 Add retry limit for calibration computing to prevent stuck state
    [Calibration.cpp, Calibration.h]
2026-02-17 Remove frame measurements suggestion from calibration failure message
2026-02-17 Change stop button to use immediate reset command instead of $STOP
    Previously, the stop button sent the $STOP command which only set alarm state
    and stopped Maslow motors but did not immediately halt stepper execution.
    This caused a noticeable delay before the machine actually stopped.
    Now the stop button calls stopGCode() which sends the reset command (0x18),
    providing immediate stopping behavior similar to the pause button.
2026-02-17 Ensure Maslow state is reset during system reset
    Add call to Maslow.stop() in protocol_do_late_reset() to ensure that
    Maslow-specific state (calibration flags, axis state, motor state) is
    properly cleaned up when the system reset command is issued.
    This ensures that when the stop button is clicked (which now sends reset),
    all Maslow state is properly cleared along with the immediate stepper halt.
    [Protocol.cpp]
2026-02-17 Fix stop button to not go into alarm state
    Modified $STOP command to immediately stop steppers and return to Idle state
    instead of Alarm state. This addresses user feedback that alarm state is
    undesirable after clicking stop.
    - Reverted web UI to use $STOP command (not reset)
    - Modified maslow_stop() to call Stepper::stop_stepping() for immediate halt
    - Changed state transition from Alarm to Idle after stop
    - Maintains fast stopping while avoiding alarm state
    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
    [ProcessSettings.cpp, Protocol.cpp]
2026-03-04 Raise Z to safe height (2mm above Z home) before moving to XY home
2026-03-08 Fix excessive belt tension on small frames by reducing calibration grid width and adding anchor-clearance constraints
    [Calibration.cpp, Calibration.h]
2026-03-11 Fix: send status request after CURRENT_ID to fix silent command drop
2026-03-13 Add red LED alarm notification banner to web UI
    When the machine enters an Alarm state (caused by emergency stop,
    motor failure, position error, or calibration failure), a notification
    banner now appears in the tablet UI explaining that the red LED is
    blinking and guiding the user to clear the alarm or restart the machine.
2026-03-13 Show alarm cause and recoverability in red LED notification banner
    - grbl.js: Track ALARM:N codes in lastAlarmCode; detect Maslow eStop
    from [MSG:ERR: Emergency stop...] in lastEStopMessage; use named
    constants ESTOP_MSG_PREFIX / ESTOP_DISPLAY_MSG for easy maintenance;
    reset both vars in grbl_clear_status()
    - tablet.js: Add alarmCodeNames map (matching firmware AlarmNames) and
    buildAlarmBannerContent() that shows:
    - Maslow eStop → cause + "Not recoverable by clicking, power cycle"
    - FluidNC ALARM:N → cause name + "Click to clear ($X unlock)"
    - Unknown → generic click-to-clear message
    Banner content is rebuilt on every Alarm state update
    - tablettab.html: Replace static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
2026-03-17 Update from Maslow-Main: stop reliability, watchdog fixes, WSChannel stability
    [ProcessSettings.cpp, Serial.cpp, Serial.h, WSChannel.cpp]
2026-03-17 Fix browser reconnection after connection loss during GCode execution
    When check_ping() fires after 20s of no WebSocket data (common when
    WiFi drops during GCode), Disable_interface(true) sets log_off=true
    and stops all reconnection attempts. Even when WiFi returns, the
    browser never retries — requiring a power reset to get back in.
    Three fixes:
    - socket.js: Add resetConnectionState() helper; call it in onopen()
    when log_off=true so a stale retry timer that fires after the
    20s disable can re-enable http_communication_locked=false, restart
    ping monitoring, and close the "connection lost" modal automatically.
    - socket.js: Set interval_ping=-1 in Disable_interface() after clearing
    t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
2026-03-17 Fix GCode running twice: skip restoreGCodeState() on WebSocket reconnects
    restoreGCodeState() was called on every onopen (initial load + reconnects).
    Before the reconnect fix, reconnection required window.location.reload()
    which reset gCodeFilename='', so the restore was always needed.
    After the reconnect fix (no page reload), gCodeFilename stays set in JS
    memory across reconnects. Calling restoreGCodeState() on reconnect
    re-enables the Start button even when GCode already completed while the
    browser was disconnected, causing an apparent second run.
    Fix: only call restoreGCodeState() when gCodeFilename is empty/undefined
    (fresh page load), skipping it on reconnects where JS state is alrea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
2026-03-17 Fix GCode double-run from second browser instance
    When runGCode() sends $sd/run to the firmware, immediately call
    clearGCodeState() to remove gCodeFilename/gCodeLoaded from localStorage.
    A second fresh browser instance calls restoreGCodeState() on load (because
    its in-memory gCodeFilename is ''). If localStorage still has the job's
    filename the second browser restores the file, enables the Start button, and
    the user can inadvertently trigger a second run.
    Clearing localStorage as soon as the job is dispatched prevents any
    subsequent browser from restoring the "ready-to-run" state. In-memory
    state (gCodeFilename, gCodeLoaded JS vars) is untouched, so the current
    window's play/pause/stop b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
2026-03-17 Fix second-browser GCode re-run using gCodeRunning localStorage flag
    Replace the previous clearGCodeState() approach (which removed gCodeFilename
    from localStorage) with a gCodeRunning flag.
    runGCode() now calls store_localdata('gCodeRunning','true') instead of
    clearGCodeState(). restoreGCodeState() checks this flag: if 'true', it
    returns early without loading the file or enabling Start, preventing any
    fresh browser instance from accidentally triggering a second run.
    tabletGrblState case 'Idle' now calls delete_localdata('gCodeRunning') so
    that once the machine is confirmed idle, any subsequent page load (own
    browser reload, second browser after job completes) can restore the file
    and ena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
2026-03-17 Disable Start button immediately on GCode launch to prevent single-browser double-run
2026-03-23 Increase working range to support frames larger than 5700mm x 2300mm
    Agent-Logs-Url: https://github.com/MaslowCNC/Maslow_4/sessions/3bef9aaa-e95d-4794-a21e-ed95d2dee4a4
2026-03-23 Add example maslow_5700x2300.yaml configuration for large-format setup
    Agent-Logs-Url: https://github.com/MaslowCNC/Maslow_4/sessions/b73b9861-b3b2-4d62-a3c1-65ec94316c7c
    [maslow_5700x2300.yaml]
2026-03-23 Make frame size limits configurable via maslow.yaml
    Agent-Logs-Url: https://github.com/MaslowCNC/Maslow_4/sessions/564087c9-0614-4903-9cca-bb0f6ccdff8d
2026-03-24 Add Maslow_Frame_Size_Min/Max to example maslow.yaml
    Agent-Logs-Url: https://github.com/MaslowCNC/Maslow_4/sessions/a1e04c3f-8a93-4f68-97b9-84466cca954a
    [maslow.yaml]
2026-04-14 Merge Maslow-Main into branch: resolve conflicts keeping both frame size limits and park position features
    Agent-Logs-Url: https://github.com/MaslowCNC/Maslow_4/sessions/58ca75e8-3ca3-4129-833e-13edf1c7c5f0
    [maslow.yaml]
2026-04-18 Fix: Z jog triggering Release Tension - add confirmation dialog and close popup immediately on Apply Tension
    Agent-Logs-Url: https://github.com/MaslowCNC/Maslow_4/sessions/6de79156-7241-4601-9919-7ba16240f1ef
2026-04-21 feat: track Z-axis trust state and block apply tension when Z not set
    - Add `zTrusted` flag to `Maslow_` class in `Maslow.h`
    - Mark `zTrusted = false` when machine enters UNKNOWN state (Calibration.cpp)
    - Mark `zTrusted = true` after `setZStop()` is called (Maslow.cpp)
    - Mark `zTrusted = true` when valid belt positions load from NVS (Maslow.cpp)
    - Block EXTENDEDOUT → TAKING_SLACK transition if Z is not trusted (Calibration.cpp)
    - Include `zTrusted` in MINFO JSON telemetry (Maslow.cpp)
    - Add `zTrusted` to `maslowStatus` in web UI (maslow.js)
    - Add `updateZButtonColors()` to highlight Z buttons red when Z not trusted (maslow.js)
    - Call `updateZButtonColors()` on state change and MINFO update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
2026-04-21 refactor: address code review - clarify comment and fix arrow character in tooltip
    Agent-Logs-Url: https://github.com/MaslowCNC/Maslow_4/sessions/fd87fbea-a77c-40ae-82c4-b5d07f1accbb
    [Calibration.cpp]
2026-04-24 Fix Z home (G92) and Zm persistence across restarts
    Agent-Logs-Url: https://github.com/MaslowCNC/Maslow_4/sessions/53d79658-a775-44f1-bf60-12b0ef3a9152
    [Maslow.cpp]
2026-05-27 Fix encoder direction
2026-05-27 Allow smaller frames
2026-06-19 Add spindle
2026-06-19 Able to control spindle but not z-axis
    [maslow.yaml]
2026-06-19 Spindle and z-axis working
    [maslow.yaml]
2026-06-19 Spindle and fan working, spindle board not booting correctly
    [maslow.yaml]
2026-07-29 Spindle button added
2026-07-29 Jog button z working, but jerky
2026-07-29 More voltage when jogging
2026-07-29 Spindle ramps faster
2026-07-30 Both boards update over wifi
2026-07-31 Homing working
2026-07-31 Tool inserting working
2026-07-31 homing not working
2026-08-03 Inserting and removing working OK
2026-08-04 Messing with over current protection
2026-08-05 Spindle works and cuts wood here
2026-08-07 Swap motor direction
2026-08-10 OTA working, faster spindle bootup
2026-08-13 Add magnet strength test
2026-08-18 Revert "Add magnet strength test"
    This reverts commit 90e292f4c3b500b72f3bd1e7c10b3c89e3627c03.
    [MotorUnit.cpp]
2026-08-18 No encoder offsets when retracting and extending
2026-08-19 Homing z goes both directions
2026-08-26 Fix vacuum powering up on bootup
    [SpindleBoard.cpp, SpindleBoard.h, main.cpp, serial_commands.cpp, serial_commands.h]
2026-08-26 Fix spindle not cooling issue
    [main.cpp, serial_commands.cpp, serial_commands.h]
2026-09-16 Don't restart after a failure
    [config.h, main.cpp, serial_commands.cpp, serial_commands.h]
2026-09-18 Boards imported and moving OK
2026-09-19 Update main UI trace and release controls
2026-09-19 Update tablet UI trace boundary and release tension buttons
2026-09-19 Use semantic ID for main Release Tension button
2026-09-21 Merging nets and voltage regulators
2026-09-22 Fix Copilot relay mention in PR comments
2026-09-24 Two wires left to route
2026-10-05 Add spindle trip recorder; use current calibration as default LUTs
    Trip recorder: keeps the last ~2 s of motor state (per-phase currents,
    filtered protection current, voltage limit, commanded RPM, nFAULT edges
    and level, Z phase, FOC loop count and longest iteration gap) in a RAM
    ring buffer sampled every housekeeping pass. Any fault that stops the
    motors (firmware over-current, driver nFAULT over-current, driver
    over-temperature) captures a 50-sample tail, freezes, and streams the
    window to USB as TRIPCSV lines. USB commands TRIP (reprint) and REARM;
    the recorder also re-arms on the next non-zero speed command.
    Default LUTs: replace the 140-entry DRV8316-era tables with the full
    180-entry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
    [main.cpp, motor_controller.cpp, motor_controller.h, serial_commands.cpp, trip_recorder.cpp, trip_recorder.h]
2026-10-05 Fix trip recorder dump stalling on its header; correct velocity key help
    The USB CDC TX ring buffer is 256 bytes and the recorder only writes a
    line once the whole line fits, so the ~370-byte single-line header
    could never be sent and the dump stalled before printing anything.
    Split the header over four short lines and keep every line under 200
    bytes.
    The '0'-'9' velocity keys step in 2000 RPM (9 = 18000 RPM); the help
    text said 9 = 10000 RPM.
    [serial_commands.cpp, trip_recorder.cpp]
2026-10-05 Spindle: SpaceVectorPWM, cap voltage at the linear limit, slow top-end ramp; fix cal abort
    - Use SpaceVectorPWM (midpoint clamp): linear up to Vdc/sqrt(3) = 13.86V
    on a 24V bus instead of SinePWM's 12V. Identical below 12V, so the
    existing LUT keeps its meaning there.
    - MAX_VOLTAGE = SUPPLY_VOLTAGE/sqrt(3). The old 24V ceiling let the LUT
    request heavily clipped waveforms above ~13,500 RPM, which a trip
    recording showed driving M1 into the MP6541A hardware OCP.
    - Ramp at 150 rad/s^2 instead of 500 above 14,000 RPM, where little
    torque margin is left for acceleration.
    - Calibration abort now keeps the LUT valid and saves the recorded steps
    (unrecorded steps keep their previous val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
    [calibration.cpp, config.h, main.cpp, motor_controller.cpp]
2026-10-05 Spindle: limit speed to 16,500 RPM; continue auto-cal to motor 2 after a trip
    - MAX_COMMAND_RPM and the top of the calibration sweep drop to 16,500 RPM.
    At the 13.86V SVPWM cap, M1 held 17,000 RPM but lost sync at a steady
    17,100 RPM on the 24V bus. The digit keys are clamped too ('9' was
    18,000 RPM). The LUT stays 180 entries so stored calibrations load.
    - An over-current during motor 1's auto sweep now ends motor 1's sweep
    at that point (saving its recorded steps), waits 5 s for it to coast
    to rest, and calibrates motor 2, instead of aborting the whole run.
    No fault is latched in that case. Other trips still abort.
    - Auto-cal's first step now uses the motor's direction (it ran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
2026-10-05 Spindle: make the 'f'/'F' fan keys work (manual override)
    applyFanForMotorState() rewrote the fan state every housekeeping pass,
    so 'f' and 'F' were undone within ~2 ms whenever no motors were enabled.
    They now set a manual override that the automatic logic respects: 'f'
    toggles it, 'F' steps the manual level (1-100) and turns it on, and the
    'x' emergency stop clears it. Removed the never-written fan Preferences
    storage and the unused setFanState/setFanLevel helpers.
2026-10-05 Spindle: 'F' raises the manual fan level by 5 per press
2026-10-05 Spindle trip recorder: report captures and dropped triggers; add TRIPTEST
    - Print "[TRIP] captured: <reason> at <uptime>" when a trip is recorded,
    and "[TRIP] NOT recorded ... still holding the trip from <uptime>"
    when a trip arrives while an earlier recording is still held (only the
    first trip after arming is kept, and the digit keys do not re-arm).
    - The recording header now includes the trigger uptime.
    - New USB command TRIPTEST triggers a recording with no fault, to check
    the dump path on the bench. Six back-to-back 1000-row test dumps each
    completed in ~0.6 s.
2026-10-05 Spindle: limit speed to 12,000 RPM
    With a tool loaded both motors tripped the driver OCP at 14,000 RPM;
    12,000 RPM has run reliably. MAX_COMMAND_RPM caps link and USB
    digit-key commands and is also the top of the calibration sweep.
2026-10-06 Spindle: opt-in load-sense diagnostic (duty-weighted current fit)
    Estimates how hard each open-loop motor is working, to see whether a
    stall can be predicted. Diagnostic only: no trips, voltage changes or
    feed holds; the over-current path is unchanged and core 1 is only read.
    - updateCurrent() tags its three existing reads with the commanded
    electrical angle and that phase's PWM duty. Gated low-side sampling is
    not possible: analogRead takes ~65 us (110 us max on ADC1, 241 us on
    ADC2), longer than a 50 us PWM period.
    - Reads land at random points in the PWM period (a random 0-50 us delay
    is added before each read while LOAD is on, because the 2 ms tick is
    exactly 40 PWM periods),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
    [config.h, main.cpp, motor_controller.cpp, motor_controller.h, serial_commands.cpp, trip_recorder.cpp, trip_recorder.h]
2026-10-06 Spindle: unstick USB console output, safe LOADREF save, reset reason, serial hub
    - usbWriteIfRoom(): the shared non-blocking USB write. When a line does
    not fit it re-enables the USB Serial/JTAG TX-empty interrupt (as
    HWCDC::write does). Output had been seen sitting in the TX buffer
    while the motors ran until some other write kicked it (late trip
    dump; silent LOADREF). After the change LOADREF printed live, and a
    stale help-text fragment was released the moment it started.
    - LOADREF saved its NVS table while both motors were still at
    12,000 RPM; the flash write stalls both cores, the open-loop rotors
    slipped, and the board reset (coredump area blank, so not a crash).
    It now r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
    [main.cpp, serial_commands.cpp, trip_recorder.cpp]
2026-10-06 Spindle: advisory stall warning from the load-sense lag; digit keys drive both motors
    - Warning per motor when its current lag is >20 deg from the no-load
    (LOADREF) baseline for that speed for 100 ms at steady speed; clears
    after 300 ms back within 12 deg. Held off while ramping, during
    RTEST/LOADREF and during calibration. Reported as WARN:/MSG: lines
    (XY board console + USB) and as an L:<bits> field after F: in the
    status line (the XY board's strstr("F:") parser is unaffected).
    Advisory only: no protective action.
    Basis: baseline lag repeats within +/-4 deg run to run; replaying the
    2026-10-06 stall while cutting wood at 12,000 RPM, the M2 warning
    fires 989 ms before the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
    [config.h, main.cpp, serial_commands.cpp, serial_commands.h]
2026-10-06 Spindle trip recorder: re-arm on every spindle start
    Starting the spindle with a USB digit key did not re-arm the recorder
    (only a link S<rpm> did), so after the first stall the next ones were
    "NOT recorded". Any start now re-arms it. If a recording is still
    printing, re-arming waits until the print finishes so the dump is not
    cut short.
    [serial_commands.cpp, trip_recorder.cpp, trip_recorder.h]
2026-10-06 Spindle: load boost - +2 V on both motors while a load warning is raised
    More voltage raises an open-loop motor's pull-out torque. While either
    motor's load warning is raised, both motors get LOAD_BOOST_V (2 V,
    capped at MAX_VOLTAGE) on top of the LUT; it ramps in at 50 V/s (a
    stall's "on the edge" stage lasts ~0.5 s), holds 2 s after the warnings
    clear, then ramps out at 2 V/s. Only while spinning as the spindle; not
    during calibration, LOADREF or RTEST. On at boot (LOAD_BOOST_DEFAULT_ON);
    USB BOOST toggles it until reboot. "load boost on/off" is reported to the
    XY board and USB; [LOAD] lines show BOOST+x.x.
    Core 1 only reads one more float (MotorController::load_boost_v) in
    applyVoltageLi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
    [config.h, main.cpp, motor_controller.cpp, motor_controller.h, serial_commands.cpp]
2026-10-06 Spindle: VSWEEP voltage-sweep diagnostic
    At the spindle's current steady speed, offsets both motors' voltage from
    +1.0 V downward in 0.25 V steps (0.3 s settle, 0.5 s measure), printing
    voltage, fitted current magnitude, Ip, Iq and lag per motor per step,
    then the lowest-current offset per motor. Stops after a step whose mean
    lag on either motor is below 20 deg, at once if a lag falls below 5 deg
    mid-step, or if the spindle stops or changes speed; 'x' aborts. The
    voltage is restored to the calibrated value at once on any exit. Uses
    the per-motor load_boost_v offset the FOC loop already reads (the boost
    is suspended while it runs). Link S/Z are ignored and CAL refused while
    it runs.
    Purpose: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
2026-10-06 Spindle: put the housekeeping task under the task watchdog (3 s)
    On 2026-10-06 the board went silent right after a spindle start: no USB
    output, and VSWEEP, x, WHY and ? got no reply for minutes, with no
    coredump (not a crash). If housekeeping is stuck waiting on something,
    the core-0 idle task still runs, so the default watchdog never fires and
    the spindle would keep running with no over-current monitoring or
    command handling. Housekeeping now registers with the TWDT (timeout 3 s,
    panic on): a stuck pass reboots the chip, which stops the motors, and
    leaves a coredump showing where it was stuck. The longest legitimate
    waits in a pass (NVS writes, console output) are tens of ms.
    Co-Authored-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
    [config.h, main.cpp]
2026-10-06 Spindle: USB console output watchdog, reporting over the XY link
    On 2026-10-06 the USB output died right after a spindle start while the
    firmware and USB input kept working ('x' stopped the spindle), and it
    stayed dead across a host reconnect. If the USB TX buffer stays nearly
    full for 1 s, report the USB Serial/JTAG state (ring-buffer room, IN FIFO
    free flag, int_ena/int_raw, EP1 state and read/write addresses) as a
    MSG: line - it reaches the XY board console even when USB is stuck -
    then flush the TX FIFO and re-enable the TX-empty interrupt every
    500 ms, and report when output drains again. Also fires, harmlessly,
    when no USB host is reading.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
    [main.cpp]
2026-10-07 Spindle: adaptive voltage - per-motor trim holding Iq at 2 A (replaces the boost)
    VSWEEP at 12,000/8,000/4,000 RPM showed each motor's lagging current Iq
    falls smoothly and steeply as the voltage drops toward the back-EMF
    (~8 A/V at 12k, 5-8 at 8k, 2-4 at 4k), repeats within ~0.1 V, and
    crosses ~0 at the pull-out edge; the calibrated LUT sits 3-5 A above
    it, which is most of the no-load current and motor heat, and M2 sat
    closest to its edge.
    Each motor now gets a voltage trim on top of the LUT steering its Iq to
    ADAPT_IQ_TARGET_A (2.0 A): up at 0.4 V/s per A (max 5 V/s), down at
    0.08 V/s per A (max 0.5 V/s), full rate when Iq < 0.5 A, and +1 V at once
    when a load warning fires. Trim limited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
    [config.h, main.cpp, motor_controller.h, serial_commands.cpp]
2026-10-07 Spindle: print the boot banner before starting the FOC task (fixes the USB "stall")
    Root cause of the USB console going silent: setup() printed the banner
    and help text after creating the FOC task, which runs at priority 3 on
    core 1 and never blocks, so it starves setup()/loopTask for good. The
    banner froze mid-print, sometimes inside HWCDC::write() holding the TX
    lock, so every other USB writer failed to take the lock (availableForWrite
    read 0) and output stopped - while input kept working. Each spindle start
    let a little more banner out, because MotorController::enable() blocks
    the FOC task for its 2 ms driver wake-up; that is why stale help text
    kept appearing at spindle starts and output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
    [main.cpp]
2026-10-07 Spindle: adaptive voltage - smaller warning step, fast ramp-down when Iq is high
    In the 2026-10-06 cut, ~14 of motor 2's ~18 W of copper loss came from
    lagging current Iq, not the in-phase cutting current: each +1 V warning
    step sent its Iq to 8-9 A, which the loop then removed slowly.
    - ADAPT_WARN_STEP_V 1.0 -> 0.5 V.
    - While Iq > 5 A, more than 1 s after the motor's last warning, the
    trim comes down at 0.3 V/s per A of excess (max 2 V/s) instead of the
    normal 0.08 (max 0.5 V/s). The 1 s hold keeps the margin a warning
    step adds.
    Simulated 2 s, 5 A load burst at 12k: the same lowest Iq under load, RMS
    Iq from the burst onward 3.47 -> 2.92 A (~30% less lagging-current heat).
    Built; n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
2026-10-09 Pin platform-espressif32 to last known-good commit
    Unpinned develop moved to the GCC 14 toolchain on 2026-10-07, which makes
    uint32_t long unsigned int and breaks MyIOStream operator<< overload
    resolution. Pin to a6eb5ed (espressif32 7.1.2, GCC 8.4), the version the
    v1.25.0 release built with.
2026-10-14 Add Maslow_Dust_Fan_Speed setting (0-100) for the dust collection fan
    The fan speed is now a top-level Maslow_ setting instead of SpindleBoard/suction_power,
    so it shows in the WebUI Configuration popup and settings list. It is streamed to the
    spindle board every update pass (sent only on change) using the existing 'C' link command,
    so a change applies immediately with no restart and no spindle board reflash.
    The XY board also re-sends the fan speed when the spindle board's 50 ms status reports
    resume after a >1.5 s silence (a spindle reboot/reflash resets its fan speed to 100).
2026-10-14 WebUI: drop Dust Fan Speed from the Configuration popup (settings panel only)
2026-10-14 Refresh firmware/FluidNC/data/index.html.gz from current WebUI build
    The bundled copy dated from Aug 4, before the fixedZ gating of the Z safety
    popups was added, so anything that uploads the data folder (pio uploadfs,
    build-release.py) shipped a WebUI that still showed Low/High Z warnings on
    fixedZ machines. Rebuilt with `npx gulp package --lang en` at 5342bda2.
2026-10-14 Reset the Maslow update watchdog after the alarm message delay
    alarm_msg() blocks for 500 ms after printing ALARM:N, which by itself
    reaches the update watchdog's 500 ms idle limit. Every alarm (e.g. a
    SpindleBoard fault) was therefore followed by a spurious "Update loop
    stalled" emergency stop and Maslow.panic(). Reset the watchdog after the
    deliberate delay, as other intentional blocking operations already do.
2026-10-16 Add a host-side MCP server for debugging the machine
    tools/maslow-mcp/maslow_mcp.py talks to the XY board over telnet and HTTP and to the
    spindle board through the serial hub, so Claude Code can read status, logs, settings
    and files while someone drives the machine from the WebUI. Read-only commands are
    always allowed (long dumps only while idle); motion, setting writes, uploads and
    flashing need --allow-motion / MASLOW_ALLOW_MOTION=1 and an Idle/Alarm machine.
    Registered in .mcp.json; tests/test_fake.py exercises every tool against a fake board.
2026-10-16 maslow-mcp: add flash_spindle (WiFi OTA via the XY board, USB fallback)
    Builds the spindle OTA env, sends [ESP810] so the XY board hands its WiFi credentials to
    the spindle, waits for the relayed 'spindle board is on WiFi at <ip>' log line and pushes
    with espota. A failed transfer reboots the spindle back into OTA, so the upload is retried
    once at the re-announced address; then spindle/tools/flash.sh (USB) as a fallback. Gated
    like flash_firmware. The fake board, fake pio and fake flash script cover all three paths.
2026-10-16 Send spindle trip recordings to the XY board and diagnose them over MCP
    The spindle's 2 s trip recording (per-phase currents, protection current,
    vlim, Iq/lag, FOC loop rate, nFAULT retries, Z phase) only went out on USB,
    so an over-current during a cut left nothing to examine over WiFi.
    - spindle: also stream the frozen recording over the link, one line per
    20 ms so it fits the XY board's UART buffer; link 'T' re-sends it, 'T!'
    re-arms and records a test trip 2 s later (refused while holding a real
    trip). The USB copy no longer blocks a re-arm when no host is attached.
    - XY: save [TRIP]/TRIPCSV lines to /spindle_trip.csv instead of the console
    (only while not moving); $Spindle/Trip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
2026-10-16 Stop the machine on a spindle trip, and keep the spindle off afterwards
    On 2026-10-16 a spindle over-current trip set off a chain of failures:
    1. The XY board raised ALARM:10 but did not stop motion: the steppers ran
    on for about a second, dragging the stalled tool ~16 mm through the work.
    2. off_on_alarm sent S0, which cleared the spindle board's latched fault.
    The still-running stepper then queued the next block's S12000, the next
    update() sent it, and the spindle restarted on its own with Z unhomed.
    3. The spindle's trip recording arrived while the belts were still moving
    (state Alarm, so the "not while moving" check passed). Creating the file
    on flash stalled the Maslow l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
2026-10-16 maslow-mcp: line spindle_trip context up with the trip, not the re-send
    spindle_trip picked the latest line matching "over-current", and the XY
    board's "receiving spindle trip recording: driver over-current ..." line
    matches too. Now that the firmware re-requests a recording that arrived
    while the machine was stopping, that line comes ~23 s after the trip, so
    the status and message context showed the machine sitting idle.
    Anchor on the spindle's own fault message, which quotes the recording's
    reason, then on the XY board's "reported fault" alarm, and only then on
    the first time that recording (same uptime) arrived. Checked against
    today's log: both real trips (15:24:13, 16:00:29) and the te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
2026-10-16 spindle: feed the adaptive voltage loop forward on a rising load
    In the 16:00 trip, M2's Iq slid from 3.6 to 2.0 A over ~270 ms at 12,000
    RPM while the loop held its voltage (Iq was still above the 2 A target),
    then the motor went over the pull-out edge and the driver over-current
    protection fired. The loop only raised voltage after the slip.
    The loop now tracks the load part of Iq: the fitted Iq less ~8 A/V (at
    12k) of its own trim, seen through the fit's 150 ms lag, so its own
    trimming is not mistaken for load. While that falls faster than 1.5 A/s,
    it adds 6x the voltage that would hold Iq level, and judges the target
    on Iq extrapolated 150 ms ahead (the fit's lag). The fast path now
    star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
2026-10-16 Keep the belt lengths across a FluidNC soft reset
    protocol_main_loop() calls Maslow.begin() on every start, so it runs
    again after each soft reset. begin() re-initialised the four motor units:
    MotorUnit::begin() zeroes the encoder, so every belt length went to 0,
    and motor_test() pulsed each motor with the belts under tension. The
    positions in NVS were deliberately not reloaded after a reset, so they
    were simply lost.
    Soft resets used to be rare, but since f8d7839f a spindle fault calls
    mc_reset() to stop the machine. On 2026-10-16 a stall did that, and the
    next jog paid out all four belts.
    On a reset, begin() now only stops the motors and matches the step
    positions to the encoders (syncSt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
2026-10-17 Revert "Keep the belt lengths across a FluidNC soft reset"
    This reverts commit c188c0cc.
    On 2026-10-16 at 17:04 a spindle fault triggered the mc_reset() added in
    f8d7839f. With this change in place, the XY board went silent partway
    through that reset (no start-up banner, no status reports) while the
    belt motors kept driving, and the machine ran off until the operator hit
    the E-stop. The same fault at 16:36, without this change, stopped
    cleanly. The cause is not understood, so restore the long-standing reset
    behaviour: a manual reset zeroes the belts, and the belt setup must be
    redone afterwards, as before. The spindle fault no longer triggers a
    reset at all (next commit).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
2026-10-17 Pause with a feed hold on a spindle fault instead of resetting
    f8d7839f made a spindle fault call mc_reset() so the machine would stop
    instead of dragging the stalled tool through the work. On a Maslow a
    FluidNC reset re-runs Maslow's start-up mid-cut. On 2026-10-16 that lost
    the belt lengths at 16:36. At 17:04, with c188c0cc (now reverted), the
    XY board went silent partway through the reset while the belt motors
    kept driving, until the operator hit the E-stop.
    A spindle fault now sends the same feed hold as the Pause button. The
    belts decelerate to a stop and are held, and nothing is reset. The XY
    side marks the spindle stopped (without stop(), whose spin-down delay
    would block the update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
2026-10-19 maslow-mcp: wait out the telnet grace period before using a new connection
    For 2 s after a telnet connection the firmware treats '?' as plain text
    (TelnetClient NEGOTIATION_GRACE_PERIOD_MS), so the status poller's first
    '?' got glued to the front of the next command and turned it into
    error:1 - the first command after every (re)connect failed. Hold the
    socket back for 2.5 s before publishing it, and model the grace period
    in the fake board.
2026-10-19 spindle: stop the adaptive feed-forward running away after a Z move
    The trend feed-forward (8c6a5c78) ran away twice with the tool in the air
    (2026-10-16 16:36 and 2026-10-19 09:59). As a Z move ends, Iq comes back
    down 1-2 A, which the trend read as a rising load. Its correction then fed
    itself: it discounts ~8 A/V of its own trim, but well above the pull-out
    edge Iq only rises ~2 A/V, so every volt it added read as a further load
    increase. Both motors went to the +2.5 V trim ceiling at 10-11 A of Iq
    until the drivers' over-current protection tripped.
    The trend now only feeds forward while Iq is below 3.5 A (near the 2 A
    target, where the margin matters), and it ignores Iq while the Z move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
2026-10-19 maslow-mcp: refuse to analyse a trip recording older than the latest trip
    The XY board saves a spindle trip recording only once the machine is at
    rest, so after a trip mid-job (paused in Hold) /spindle_trip.csv still
    holds the previous trip. spindle_trip analysed that file and lined it up
    with the new trip's XY messages: on 2026-10-19 it reported the 2026-10-16
    16:37 recording as the 09:59 trip.
    analyse now checks the XY log: a spindle fault with no "recording saved"
    message after it means the file is older. It then says so, shows what the
    file holds, the newer fault, what the XY board said about the recording,
    an earlier identical download if there is one, and how to get the new one.
    The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
2026-10-19 maslow-mcp: check for a stale trip recording after fetch too
    A fetch the spindle has nothing for (it rebooted, so no recording) saves
    nothing, and the old /spindle_trip.csv was analysed as if it were new.
2026-10-19 Recover to "ready to cut" after a spindle fault, with the fans off
    After a spindle fault the job sat in a feed hold until the operator
    pressed Stop. In Hold the XY board keeps its cooling fan on and asks the
    spindle board for belt cooling, so both fans ran the whole time, and the
    Z still had to be re-homed by hand.
    Now, once the feed hold has brought the belts to rest, the XY board ends
    the job the way the tablet's Stop button does: it pushes $STOP, which
    keeps the belt lengths, raises the Z and goes Idle, so the fans stop. After
    a second of Idle it re-homes the Z, because the fault dropped the
    spindle's Z reference; homing only raises it to the top-of-travel beam.
    When ZHOMED arrives it pu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
2026-10-19 spindle: ignore S0 when the spindle is already stopped
    On every XY board boot the spindle board reported "Idle - Tool Loaded ->
    Spindle On -> Idle - Tool Loaded" with nobody asking it to run. The XY
    board sends S0 from SpindleBoard::init() to make sure the spindle is
    stopped. setSpindleSpeed() put both motors into velocity mode even for
    0 rpm, and spindleSpinning() reports Spindle On while either motor is in
    velocity mode, until the next FOC pass's ramp left it again. The motors
    were never enabled (they only enable for a non-zero target), so it was a
    false report, not a spin.
    The same path had real side effects: the ramp's "velocity at 0" step
    calls disable(), so an S0 that arrived while th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
2026-10-19 spindle: never lower the voltage during a Z move or its settle window
    2026-10-19 11:04, cutting under heavy load at 12,000 RPM: during the 0.7 s
    ramp down to the next pass the Z drive raised M2's Iq from 3.4 to 6.6 A.
    The adaptive loop read that as excess margin and took 0.7 V off M2
    (11.0 -> 10.35 V). The full cut load came back as the ramp ended, and
    M2 slipped 90 ms later (Iq 4.6 -> 0.9 A, lag 67 -> 19 deg), with M1
    following.
    The loop now holds the voltage (no decrease; increases still allowed)
    while the Z moves and for ADAPT_Z_SETTLE_MS afterwards. Replaying the
    recording through the loop model, M2 enters the new pass with about
    +0.4 V. That is about 1 A of Iq, less than the ~4 A the l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
2026-10-19 Let Stop end a paused job without resuming it
    During a feed hold the main loop sits in protocol_exec_rt_suspend() until
    the hold is released, and the poller reads no new lines while the main
    loop is inside one. So a $STOP sent while paused - the tablet's Stop
    button, or the spindle-fault recovery from 9d9b53d7 - waited until
    resume. On 2026-10-19 the 11:04 spindle fault left the job paused with
    both fans on; the recovery timed out, and the only ways out were a power
    cycle or resuming. Resuming ran 15 more job lines (1.6 mm) with the
    spindle stopped before the $STOP took effect.
    rtStopFromHold asks the hold itself to stop. protocol_exec_rt_suspend()
    acts on it once the hold is complete: it c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
2026-10-19 spindle: count streamed Z ramps as a Z move
    A G-code ramp reaches the spindle as a stream of tiny Z targets that each
    finish in a few ms, so "target != current" was almost never true during a
    ramp (1 of 149 samples in the 2026-10-19 14:14 trip). The Z-move voltage
    boost and the adaptive loop's Z-move guard never engaged: the loop took
    0.4 V off M2 during the step-down and the spindle slipped as it ended.
    The housekeeping task now holds a Z-moving flag for Z_MOVE_HOLD_MS (100 ms)
    after the phase last changed, and both the boost and load sense use it.
2026-10-20 Save the config file atomically, without the output queue
    $CO dumped the config by queueing every line for the output task, the
    same task that writes to telnet and WebSocket clients. When a client
    stalled at the end of Find Anchors, the main loop waited for queue space,
    stopped feeding the 5 s task watchdog, and the board reset with
    maslow.yaml opened but never written: an empty config and a lost
    calibration.
    $CO now builds the YAML in memory, writes it to maslow.yaml.tmp and
    renames that over maslow.yaml, so a save never waits on a network client
    and a failure part-way leaves the previous file in place.
2026-10-20 Keep a telnet client that stops reading from stalling the board
    TelnetClient::write() used WiFiClient::write(), which waits up to 10 x 1 s
    for every 127-byte chunk a peer does not read. It runs in the output task,
    so one stuck client stalled all output; send_line() then blocked the main
    loop once the 10-slot queue filled, and the 5 s task watchdog reset the
    board. A client that sends $CD and never reads reproduces it every time.
    - write() now only appends to a 6 KB per-client buffer and never blocks.
    handle(), in the polling task, sends it with non-blocking send(). A
    client whose socket buffer and this buffer both fill is closed, with
    "Telnet client closed: it stopped reading output".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
2026-10-20 Use no more memory than before for the telnet and config-save fixes
    The previous two commits cost heap: a 6 KB output buffer per telnet client,
    an 8 KB string holding the whole YAML during $CO, and ~1 KB per closed
    client kept for 5 s. Free heap is tight, so all three are gone:
    - Telnet output goes straight to the socket again, but with non-blocking
    send(). The socket's own buffer absorbs bursts; a client that drains
    none of it for 200 ms is cut off (read() closes it). The output task
    never waits longer than that on one client.
    - $CO writes each line straight to maslow.yaml.tmp from the calling task
    and checks every byte was accepted, then renames over maslow.yaml.
    - Only a client t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
2026-10-20 Free killed channels only once nothing can still write to them
    At 19:08 a spindle fault stopped a job and the XY board panicked a moment
    later, losing the belt positions. The core dump (read over WiFi from the
    coredump partition) shows the output task in println(const char*) on a
    channel whose vtable pointer was 0: an "ok" queued for the job's
    InputFile, which stopJob() had killed and the polling task had already
    deleted. Any killed channel - a finished or stopped job, a closed
    WebSocket or telnet client - could be freed with messages to it still
    queued, or while the main loop was about to ack a line from it.
    AllChannels::pollLine() now deregisters a killed channel at once but
    frees it only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
2026-10-20 spindle: bench build that times PWM-synchronised SOx sampling
    New adc-timing-ota environment (-D ADC_TIMING_TEST) measures, at boot with
    the drivers asleep, interrupt latency from the MCPWM peak, SAR conversion
    times (single, sequential, ADC1+ADC2 in parallel), zero-current noise and
    the phase offset between the two MCPWM units, and reports them over the
    inter-board link. It skips the power-up Z homing and locks the motors out
    if analogRead() changes across the test. The normal build is unchanged.
2026-10-20 spindle: PWM-synchronised SOx sampling + shadow flux observer (sync-sense env)
    Behind -D SYNC_CURRENT_SENSE (envs sync-sense / sync-sense-ota); the default build
    is unchanged.
    - current_sampler.h: small sampling interface (meant to be re-implemented for the
    36 V board's ADS7038).
    - sar_sync_sampler.cpp: ESP32-S3 SAR implementation. Both MCPWM units are aligned
    once at boot (outputs off) so one interrupt per PWM period reads both motors in
    parallel (ADC1 = M1, ADC2 = M2): each motor's lowest-duty phase starting 8.4 us
    before the peak, then the middle-duty phase at the peak; the third phase is
    reconstructed. A timer-group alarm re-armed from the MCPWM counter every period
    schedule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
2026-10-20 spindle sync-sense: report sampler health to the XY log 5/25/65 s after boot
2026-10-20 spindle sync-sense: fixes from the first boots on the board
    - ISR: the ADC channel table lived in flash; an NVS write (every OTA request) turns
    the cache off, so the IRAM interrupt panicked. Now DRAM_ATTR.
    - Housekeeping drained the rings "until empty", which never ends if processing is
    slower than the interrupt: task watchdog during Z homing. Capped at one ring per
    pass, and the per-sample path no longer uses trig (angle as cos/sin from the
    duties, phase shifts as rotations; observer atan2 every 4th sample, stepping on
    integrated volt- and amp-seconds). Pass time 1.17 ms -> 0.36 ms idle.
    - Unit alignment: SimpleFOC resyncs each unit's timers to phase 0 at every timer
    zero, so ph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
2026-10-20 spindle sync-sense: three-stage sampling interrupt, ADC stagger, cheaper processing
    Bench results at 2000 RPM (both motors, tool out) drove these:
    - The single interrupt busy-waited for both conversion pairs (~24 us of every
    50 us) and the housekeeping task dropped 22% of samples. Now three short stages
    per period (start pair 1 / collect + start pair 2 / collect + check + push), ADC
    starts as plain writes of a cached control word (read-modify-writes of the RTC
    SENS registers cost ~0.6 us each), and the alarm placed relative to the previous
    one instead of latching the timer counter every stage: 13-16 us per period.
    - ADC1 and ADC2 started within ns of each other made ADC2 read 21 LS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
2026-10-20 spindle sync-sense: read the lowest-duty phase either side of the peak; measured motor constants
    - In the zero vector the shorted windings' currents slope at -(R i + e)/L (~0.12 A/us
    at 12k), so a read 8.4 us before the peak is up to ~1 A off. The lowest-duty phase
    is now read again as far after the peak (fourth interrupt stage) and the two are
    averaged (SAMPLE_LO_PAIR); SYNCSET twice=0 turns it off.
    - ADC2 started < ~1 us after ADC1 reads ~0.1 A high and noisy (measured 0 / 0.5 / 1 /
    2 us): stagger is now 1 us of CPU cycles (a PWM-position wait could hang across a
    counter wrap: interrupt watchdog), pair end = 7.2 us after the ADC1 start.
    - Observer parameters from the bench: R 0.3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
2026-10-20 spindle sync-sense: sample every second PWM period; interrupt stays on core 0
    Measured at 12,000 RPM (both motors, tool out):
    - Interrupt on core 1 (registered through IPC, priority raised: this build runs
    the IPC task at the caller's priority and the FOC task never blocks): FOC loop
    18,300 -> 5,500 iterations/s, peak phase current ~3.7 -> 12-15 A. Rejected.
    - Interrupt on core 0, every period: housekeeping dropped 18-33% of samples.
    - Interrupt on core 0, every second period (10 kHz, SYNC_EVERY_N_PERIODS, SYNCSET
    every=): 0 drops, FOC loop 18,500/s, housekeeping 1.9 ms per pass, 99.7-99.9% full
    samples, observer speed within 0.2%.
    Ring indices are now safe across cores (memw), stats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
2026-10-20 spindle sync-sense: measured settle/hold margins (3.0 / 3.0 us)
    Sweep of the middle-phase read at 12,000 RPM (SETTLE, gain = sum(meas x model) /
    sum(model^2)): the reading reaches 0.9 of true 2.8 us (ADC1) / 3.3 us (ADC2) after
    the low-side FET turns on, 0.95 at 4.2 / 4.7 us, and holds above 0.9 until 3.0 us
    (ADC1) / 1.8 us (ADC2) before it turns off. The old 2.0 / 0.5 us margins let reads
    up to ~25% low through. At 3.0 / 3.0 us, 98% / 95.5% of 12,000 RPM samples pass.
2026-10-23 Restore maslow hostname/AP defaults and fix noGit version stamp
    The upstream merge reset the default hostname and AP SSID to fluidnc/FluidNC,
    so a board without a stored hostname came up as fluidnc.local after OTA.
    git-version.py used subprocess.DEVNULL, which Python 2 lacks; with python
    resolving to 2.7 the git check threw and every build was stamped noGit.
2026-10-23 Remove the temporary boottrace task and bring-up markers
    The boot diagnostics in Main.cpp were marked for removal after bring-up but
    still started a 4 KB task on every boot that printed a trace line to USB CDC
    every 2 s. Internal DRAM is the scarce resource on the M4, so drop the task
    and the bootTrace/BOOTMARK/MUMARK markers in Main, Maslow, MotorUnit and
    DCMotor.
2026-10-23 Place the ESP-NOW channel and its packet queues in PSRAM
    espnowChannel (17 KB, mostly fragment reassembly buffers) and its 4 KB receive
    ring were static objects in internal DRAM, and its three packet queues
    (22 x 258 B) were allocated there too, whether or not a pendant was ever
    paired. Construct the channel in PSRAM on first use, make the receive ring an
    ordinary member so it moves with it, and create the queues with
    xQueueCreateWithCaps. First use rather than a static object because Arduino
    adds PSRAM to the heap in initArduino(), after static constructors run.
    None of this is touched from an ISR - the ESP-NOW callbacks run in the WiFi
    task. Both fall back to internal RAM when there is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
2026-10-23 Report a servo fault when it starts and clears, not every PID cycle
    recomputePID() logged "Servo fault!" on every cycle the fault pin read
    high, flooding the console while jogging or cutting. Log a warning when the
    fault starts and an info line with its duration when it clears.
2026-10-23 Add controller board KiCAD files to the repo
2026-10-23 Treat a LOW servo fault line as the fault
    The four DRV8876 nFAULT outputs are open-drain, tied together on GPIO40 with
    a 10k pull-up to 3V3 (R32 in the Maslow 4.1 control board schematic), so the
    line is high when all is well and pulled low on a fault. The check had the
    polarity backwards and reported a fault on every jog.
2026-10-23 Report the kinematic position while in the Homing state
    Upstream reports raw motor positions while Homing. Maslow runs Apply
    Tension, retract, extend and calibration in the Homing state, so the status
    report carried belt lengths and the WebUI showed them as X, Y and Z (Z
    jumping to ~1800 mm during Apply Tension). Report get_mpos() always, as
    Maslow-Main did.
2026-10-23 Don't let belt and Z position saves trip the update watchdog
    At the end of every jog or cut, update() saves the Z position and the belt
    positions to NVS before it measures the time since its previous call. When
    one of those writes has to erase a flash sector it blocks for longer than the
    100 ms watchdog, which emergency-stopped the machine after a jog ("200ms
    since last call"). saveBeltPositions() is also called from the Retracted,
    Extended Out and Ready To Cut transitions. Every caller runs with the
    machine stopped, so reset the watchdog at the end of both save functions.
    saveZPos() also never closed its NVS handle, leaking one on each save.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
2026-10-23 Don't emergency-stop on slow commands while the machine is stopped
    Commands from the WebUI and console run on the task that calls
    Maslow.update(), and file commands block far past its 100 ms watchdog:
    $SD/List took 654 ms and $LocalFS/List 155 ms on the bench, and $SD/Run
    mounts the card and opens the file the same way, so every attempt to run a
    file emergency-stopped the machine. In Idle and Alarm update() holds the
    motors stopped, so reset the watchdog after a command that started and ended
    in those states. It stays strict while jogging, cutting or homing.
2026-10-23 Add $Coredump/Show and stop reporting update-fed waits as slow
    The framework writes an ELF core dump to the coredump partition on a panic
    (the in-tree esp32/coredump.c hook that feeds $Backtrace/Show is not linked
    into wifi_s3, so that command finds nothing). $Coredump/Show prints the
    dump's summary - task, PC, exception cause and backtrace - so a panic can be
    decoded over WiFi.
    The slow-step log timed whole commands, so every move that waited in the
    planner (while update() kept running) was reported, and the flood of
    warnings set off the WebUI's log auto-download. Count only time since the
    later of the step's start and the last update().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
2026-10-23 Fix the panic at the end of every file job
    ~JobSource deleted the job's channel immediately. Job::unnest() runs on the
    polling task as soon as the file hits EOF, while protocol_main_loop is still
    executing the last line with a processing ref on that channel, so the
    following channel->ack() called through a freed vtable. The core dump from
    the bench: loopTask, InstFetchProhibited at 0xfffffffd, from the callx8 at
    Protocol.cpp:393 (channel->ack) with the channel in PSRAM. Job::abort()
    raced the same way. Hand the channel to the AllChannels reaper, which
    deletes it once no queued line or log message refers to it.
    Also print the exception registers in $Coredump/Show (they identified the
    fau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
2026-10-26 Fall back to Extended Out when Apply Tension can't solve the position
    If the measured TL/TR belt lengths don't fit the anchor locations, or there
    were no Maslow kinematics, takeSlackFunc returned without changing state,
    leaving the machine stuck in Taking Slack. Log why and return to Extended
    Out, as the large-deviation path already does.
2026-10-26 Trip analysis: show which motor went first, ignore Iq/lag under nFAULT
    Once nFAULT fires the driver outputs are off and the phase currents read ~0,
    so Iq and lag collapse whatever the motor was doing. The report blamed the
    10-26 trip on pull-out for that reason, when M2's current had jumped to 11.9 A
    with no load build-up and M1 only followed 55 ms later.
    The report now lists each motor's first phase spike, nFAULT and over-current
    in time order, judges the run-up only from samples before that motor's first
    event, shows Iq/lag as "flt" once its driver has faulted, and flags a sudden
    event with no load build-up on the first motor.
2026-10-26 Record the shadow observer in spindle trip recordings and analyse it
    The sync-sense build now adds nine columns per motor to each trip sample:
    the observer's validity, filtered load angle, largest unfiltered load angle
    that pass, its speed estimate, slips counted since the previous sample, and
    how many synchronised samples were read that pass (all, all three phases
    valid, lowest-duty phase valid, outputs off). They take 24 KB more RAM; the
    default build is unchanged. Short names keep the link's one-line header at
    361 chars, under the XY board's 400-byte line buffer, and the longest data
    line under the USB console's 256 bytes.
    trip_analysis.py now reads columns by the recording's header, so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
2026-10-26 Send the trip recording to the XY board at one line per 30 ms
    With the observer columns a data line averages ~175 bytes, so one line every
    20 ms was ~8.7 KB/s on the 115200-baud link (11.5 KB/s) plus status lines. A
    test recording on the board lost bytes in 2 of 1000 lines. At 30 ms (~5.9
    KB/s) a test recording, sent while two SYNC health reports shared the link,
    arrived with all 1000 lines intact in 30.5 s. The XY board's 3 s per-line
    timeout and the MCP's 45 s wait both still cover it; the "~20 s" texts now say
    ~30 s.
2026-10-26 spindle: disable() waits out an in-flight FOC pass before zeroing the outputs
    disable() can run on core 0 while the FOC task on core 1 is between
    move()'s enabled check and its setPwm(). That write then lands after
    driverOutputsOff() and leaves a non-zero high-side duty with the dead-time
    pairing off until the next enable. Seen 10-26: after boot homing, M2's
    samples kept counting as valid full samples (off 100%/0%) while disabled.
    disable() now clears enabled first and waits (up to 1 ms) for
    runMotorLoop() to finish before zeroing. A disabled motor also records
    0 A in the sync build instead of holding its last running value.
2026-10-26 spindle sync-sense: resistance-corrected load angle alongside ld
    ld is measured against the applied voltage, so with the open loop
    over-driven (Id 2-4.5 A, Iq ~1 A at 12k) the R*Id drop puts it at -10 to
    -30 deg and it falls as load rises (corr -0.65 with Iq over the two 10-26
    cuts). lr measures the same angle against V - R*I (dead-time corrected
    V, the observer's R): the classical load angle, pull-out near 90 deg.
    - SYNC link lines gain "lr <deg> lrmx <deg>" (filtered / max this window)
    - trip recordings gain m<n>_lr, m<n>_lrmx (header 388 chars, under the
    XY board's 400-byte line buffer); recorder RAM +8 KB
    - trip_analysis judges the warning and the climb on lr where present and
    show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
2026-10-26 spindle: bench slip test that stops the motor itself (sync-sense-sliptest)
    A build where the link's "T!" ($Spindle/Trip=TEST) runs a slip test on
    one motor (M1, then M2 next time) with the other off and the tool out:
    spin up to 4000 RPM, settle 2 s, then take 0.05 V off every 250 ms until
    the rotor pulls out. The firmware cuts that motor at the first of: the
    observer counting a pole slip, the observer losing lock for 150 ms, phase
    RMS over 8 A, a protection stop, the voltage floor, or 60 s. It records
    first, so the 2 s before the stop reach the XY board as a trip recording
    ("manual test - slip test M<n> ..."). Each step is logged over the link;
    the Z reference is dropped (one motor alone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
2026-10-26 spindle sliptest: schedule of speeds, sudden drops and rescue runs
    Each "T!" now runs the next of nine runs: ramps at 8k and 12k on both
    motors, sudden drops to just below the estimated pull-out (back-EMF +
    dead time + friction drop - 0.15 V) at 4k and 12k, and rescue runs at 4k
    and 12k (ramp and drop) on M1.
    A detector watches ld: 10 deg over its own ~200 ms average for 3 passes
    (the average restarts 20 ms after a sudden drop). In rescue runs it puts
    the calibrated voltage back and holds 1.5 s, then judges whether the
    speed held; otherwise it only reports how long before the stop it fired.
2026-10-26 spindle sliptest: Iq<0 detector rule; schedule keeps rescues at 4k/8k
    At 12k a voltage ramp ran up the current past the V-curve minimum and hit
    8 A with no slip, ~900 ms after the load-sense Iq went negative. Iq<0 was
    the earliest signal in every run (32-73 ms ahead at 4k/8k), so the
    detector now fires on it or on the ld rule, and reports each one's time.
2026-10-26 spindle sliptest: ramped rescue restore and an observer-speed detector rule
    The rescue now ramps back to the calibrated voltage over 40 ms (a step
    spiked 9.8 A at 8k). The detector gains a third rule, observer speed 2%
    below the command for 3 passes, not held off after a sudden drop: the only
    signal fast enough there. Schedule: 4k and 8k ramp rescues, 8k drop rescue.
2026-10-26 spindle sliptest: half-step-then-ramp rescue and a single-pass ldmx rule
    The rescue puts half the voltage offset back at once and ramps the rest
    over 30 ms (a full step spiked 9.8 A at 8k; a 40 ms ramp from the bottom
    was too slow at 4k). New detector rule: one pass's unfiltered max ld
    20 deg over the ~200 ms average of ld, with no hold-off after a drop.
2026-10-26 spindle sync-sense: shadow slip guard logging the four detector rules
    Every spinning motor runs the bench-tested rules - ld over its 200 ms
    average, load-sense Iq<0, observer speed 2% low, single-pass ldmx +20 -
    and takes no action. Each would-fire episode is a GUARD link line (rate
    limited per rule, Z/R flags for Z moving/ramping), and once a second the
    worst margin of each rule and the fire counts, so real cuts measure the
    false-alarm rate.
2026-10-26 spindle guard: cap the ld average hold, skip ramps and the settle after them
    In the first cut with the shadow guard the ld average froze at its
    spin-up value (~-125 deg at ~800 RPM) and stayed there all cut, latching
    the ld and mx rules on. The average is now held at most 300 ms, then
    taken from ld (counted as rs in the per-second line), and the rules are
    skipped while the speed ramps and for 500 ms after it arrives, with the
    average starting afresh. Seconds with nothing judged are not reported.
2026-10-26 spindle guard: hold ld and mx for 30 ms after a voltage step
    Every ld/mx would-fire of the second guarded cut was the +1 V Z-move boost
    dropping off: ld moves ~10 deg per volt by itself, over an average taken
    during the boost. When the voltage limit steps more than 0.3 V off its
    ~20 ms average (Z boost on/off, adaptive jumps), the ld and mx rules now
    wait 30 ms and their average restarts from ld. Iq and speed rules keep
    running. Steps are counted as vs in the per-second line.
2026-10-26 spindle guard: note the chosen slip-guard design and when to revisit it
2026-10-26 spindle guard: combined rule (Iq/speed primary, confirmed m2 for fast slips)
    The observer now also reports each pass's second-largest load angle, so a
    single noisy sample cannot trip the fast rule. The guard adds:
    m2: that second-largest value 20 deg over the ~200 ms ld average
    cm: an m2 candidate confirmed within 5 ms by a second m2 pass or by the
    pass RMS current rising 0.5 A over its lowest since the candidate
    G : iq or sp or cm - the combined decision
    ld and mx stay as logged-only references. The per-second line reports m2
    worst margin, cm/G fires and unconfirmed candidates (nc).
    The slip-test build drops its own detector: stepping arms the guard, the
    run's own sudden drop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
2026-10-26 spindle guard: clear the per-second tally when a motor stops
    The first per-second line after a spin-up reported the previous run's
    fires (a bench slip showed up as G1 at the next start).
2026-10-26 spindle guard: G = iq or sp or raw mx; m2 and cm kept as references
    In the 10-26 cut m2 ran only ~1 deg below raw mx and the confirmation
    rejected no candidate, while on the bench the two cost 5-10 ms and lost
    the 4k ramp and 8k drop rescues that raw mx had held. The fast part of
    the combined decision is now the single-pass raw mx rule (+20 deg); m2
    and cm are still computed and logged.
2026-10-26 XY: add $Coredump/Show (ported from 86cde7fd/682b5a93)
    Prints the panic core dump's task, PC, exception cause and address, ELF
    SHA, backtrace and a0-a15 from the coredump partition, so a panic can be
    decoded over WiFi. The running build could not read the 10-26 15:44
    panic. 682b5a93's end-of-job fix itself does not apply here: this branch
    has no JobSource, and InputFile already hands itself to the reaper.
2026-10-26 XY: never write the trip recording to flash while stepping
    The step ISR is allocated with ESP_INTR_FLAG_IRAM, so it runs while flash
    is written with the cache off, but every step it calls through vtables in
    flash (motor step/direction, spindle->setSpeedfromISR). The 10-26 15:44
    panic was that call jumping to 0xbad00bad: the trip recording re-sent at
    rest was still being written to /spindle_trip.csv when a Home Z ($HZ)
    started the steppers, because handleTripLine() checked machineAtRest()
    only on the recording's first line.
    Every write (and the close, which flushes) now needs flashWriteSafe() =
    at rest and Stepper::isAwake() false. If motion starts mid-recording the
    file stops being writte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
2026-10-27 SpindleBoard: accept spinup_ms/spindown_ms again
    Upstream moved the spin delay settings out of Spindle::group() into
    groupDelaySettings(), which only the motor spindle types call. The
    SpindleBoard section of existing maslow.yaml files sets both, so the
    merged firmware booted into a configuration alarm and never initialised
    the spindle ($Spindle/Trip: "No SpindleBoard spindle is configured").
2026-10-27 Maslow: restore RETRACTED at boot when belts are within 15 mm of zero
    The 0.5 mm threshold didn't cover the encoder-angle adjustment applied on
    restore: after a retract the spools relax a fraction of a turn once the
    motors power down, so a retracted machine (TR read 0.8 mm) booted into
    EXTENDEDOUT.
2026-10-28 Maslow: detect the control board from the BoardVersion divider
    Read GPIO17 once at boot, before the config is parsed and before WiFi
    claims ADC2, and classify it: Maslow 4.1 (10k/10k, ~1.65 V), Unified
    Control Board (10k/5.1k, ~1.11 V) or the 36 V Unified board (10k/2.2k,
    ~0.60 V). Logged at boot and reported by $Maslow/board. Nothing acts
    on the result yet - this is the first step towards one firmware for the
    Maslow 4 and the Maslow Mini.
    Static RAM unchanged (132776 bytes), flash +4 KB.
2026-10-28 Maslow: belt motor and encoder direction follow the detected board
    The Unified Control Boards wire the belt motors and encoders the opposite
    way round to the Maslow 4.1, so the pin/channel swap (109354fd) and the
    counter-clockwise encoder (0c6271f1) now apply only when BoardId reports
    a Unified board. A Maslow 4.1 gets the original wiring back.
    A board that is not recognised latches a Maslow error before the motors
    are set up, skips the motor self-test (its direction would be a guess),
    and $X cannot clear it.
    Static RAM unchanged, flash +0.8 KB.
2026-10-28 Calibration: first ring spacing follows the detected board
    The Mini's frame is too small for the Maslow 4's 150 mm first ring, so
    1c360d0f shrank it to 50 mm for every machine. A Maslow 4.1 board now
    gets 150 mm again; the Unified Control Boards (the Mini) keep 50 mm.
2026-10-28 Unified Control Board: drop the KiCad backup copies
    The *.bak-before-* snapshots and .bak-lib-before-assembly-fixes/ (81 files,
    ~53 MB) were editing checkpoints; they stay in history on Maslow-Mini.
2026-10-28 Config: per-board templates, default config and a board/config check
    - data/maslow.yaml is split into maslow-m4.yaml (Maslow-Main's, TMC2209 Z)
    and maslow-mini.yaml (SpindleBoard on GPIO15/16). When the config file
    does not exist, the template for the detected board is copied into place.
    The release still ships the Maslow 4 template as config/maslow.yaml.
    - The built-in default config matches the board, and is built only when
    needed instead of living on the heap from boot (static RAM -384 bytes).
    - A config written for the other board raises a config alarm: a
    SpindleBoard spindle on a Maslow 4.1 (GPIO15/16 are its Z STEP/DIR), or
    any stepper driver on a Unified Control Board (th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
2026-10-28 WebUI: show the Mini's controls only on a Unified Control Board
    [ESP800] now ends with "# board:<id>" (maslow41, unified, unified36v or
    unknown); older UIs ignore the extra field. The tablet uses it to show
    the spindle On/Home Z/Remove Tool row only on the Mini, and to put back
    the Maslow 4's 0-72 mm limits on the Set Z Home value, which the Mini
    change had removed for every machine.
2026-10-28 Build: restore -DENABLE_WIFI for WiFi builds
    The v3.9.9 merge dropped it from common_wifi, so blinkIPAddress() never
    read the IP (blue LED stayed dark) and the spindle OTA command reported
    the XY firmware as built without WiFi.
2026-10-28 Find Anchors: size the calibration grid from the first six-point fit
    The grid was sized once, before the first measurement, from the configured
    anchors and capped by the user's work area. The hook meant to rebuild it at
    waypoint 6 never ran: it sat on the CALIBRATION_COMPUTING re-entry path,
    which nothing uses since the fit moved on-board.
    Rebuild the grid (points 7 onward) right after the first fit passes, sized
    from the fitted anchors (narrower width / shorter height, so a non-square
    frame stays inside), and drop the work-area cap. A non-zero
    calibration_grid_width/height still gives a fixed grid.
2026-10-28 Find Anchors: size the auto grid at 40% of the frame in both X and Y
2026-10-28 Work area: 0 means auto, and calibration respects one the user set
    Follow-up to #1124, from the review discussion there. Ignoring the work
    area during calibration could run the sled off a workpiece smaller than
    40% of the frame (e.g. a sheet on a tall frame). The work area now works
    like the calibration grid size:
    - 0 (the new default) sizes that axis from the fitted anchors: 80% of
    the narrower frame width by 60% of the shorter frame height, about a
    4x8 sheet on a standard frame. It limits jobs only.
    - A non-zero value is the user's, and the auto calibration grid is
    shrunk so every point stays 100 mm inside it, allowing for the center
    offset. If no grid fits, Find Anchors stops wit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
2026-10-28 WebUI: reboot after a firmware upload even if the exact millisecond is missed
    The post-/updatefw reboot fired only when poll() ran on exactly
    _schedule_reboot_time. A slow loop pass (a ~100 ms Maslow.update) skips that
    millisecond, so the board logged "Update 100%", returned status 3 and kept
    running the old image until it was restarted by hand. Fire on the first poll
    at or after the scheduled time instead.
2026-10-28 ESP-NOW: open pairing for 2 minutes after power-on
    Pairing a remote needed $EP from the WebUI, which meant joining the
    Maslow's WiFi from a computer. Now every power-on opens the pairing
    window for 2 minutes: turn the Maslow on and tap Pair on the remote.
    $EP still opens a 60 s window and $EC closes either one early.
2026-11-06 WebUI: count the board's bare PING as a heartbeat
    Since the FluidNC 3.9.9 merge, WSChannels::sendPing() sends "PING\n"
    instead of "PING:<id>". socket.js only counted "PING:<id>", so every page
    decided the board was gone 20 s after connecting, disabled itself and
    started reconnecting, even with the board idle.
    Count any message starting with PING as the heartbeat. Also stop taking
    the page ID from PING: CURRENT_ID sets it, and older firmware sent the ID
    as a raw byte.
2026-11-06 WebUI: prompt Find Anchors when Apply Tension can't confirm the position
    When the measured belt lengths don't fit the saved anchors, the firmware
    logs "Apply Tension failed: ..." (or "Center point deviation over ...")
    and goes back to Belts Extended. The page only showed that in the log, so
    it looked as if tension had been applied and the state had jumped back.
    Show a dialog explaining that the anchors may have moved, with the
    board's message, and a Find Anchors button that goes through the same
    path as the Find Anchor Locations button (including the Z check).
2026-11-10 flash-maslow: WiFi flashing over HTTP, keep calibration on --fs
    - WiFi firmware goes to /updatefw and data files to /files (the web UI's own
    endpoints), each read back and compared. espota/ArduinoOTA dropped: it
    does not feed Maslow's update watchdog and the upload was reset at 7%.
    - WiFi --fs skips *.yaml, so calibrated anchors survive; they are backed
    up to .maslow-backups/ first (gitignored). --reset-config uploads the
    repo default instead.
    - New backup/restore modes for use around USB flashes.
    - Reachability check retries; tested end to end on a 4.1 at maslow.local.
2026-11-10 Jog cancel (0x85) also drops jog lines not yet started
    When 0x85 cancels a jog, discard the sending channel's unread input
    (Channel::flushQueuedLines) and any of its lines waiting in the one-slot
    cmd_queue handoff (cmd_queue_drop_channel). Before, jogs clicked after
    the running one still ran after the cancel. Bytes sent after 0x85, such
    as the $STOP that follows it, arrive later and are kept.
    Tested on a 4.1: a long jog stops promptly, and several queued jogs in
    different directions followed by STOP no longer move after the stop.
2026-11-10 UI: send jogs and STOP over one WebSocket; add connection dot
    - wscommands.js: ordered command layer over the WebSocket. Tracks
    ok/error replies per line and reports rejected commands; realtime
    bytes (0x85, ?) are sent raw. Same line protocol as USB serial.
    - Jogs, STOP and the calibration buttons go through it, so STOP's jog
    cancel catches every jog sent before it. STOP sends 0x85 before $STOP.
    - connindicator.js + navbar dot: green / amber (open but silent > 2.5 s) /
    red (not connected); a 1 s '?' probe keeps it current while idle.
    - Fix: the ping watchdog never matched the firmware's bare "PING", so the
    UI closed and reopened its socket every 20-30 s, losing anything sent in
    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
2026-11-10 Backlog and flash script updates after stop/connection work
    - flash-maslow.sh: wifi --fs --skip-build now stages the current UI build
    instead of sending whatever was staged last time.
    - BACKLOG.md: remove fixed items ($STOP queue question answered: it does
    empty the planner); add the connection-protocol plan and leftovers.
2026-11-10 Backlog: hostname change not applied by the UI restart button
2026-11-10 UI: debug switch that logs wsCommands sends and matched replies
    wsCommands.setDebug(true) in the browser console logs each line sent, the
    ok/error it was matched to and how long it waited, jog-cancel flushes, and
    lines forgotten on reconnect. Remembered in localStorage across reloads.
2026-11-10 UI: send every line command over the WebSocket, one at a time
    All line commands now go through wscommands.js, so one queue sees every
    line on the tab's firmware channel and each ok/error is matched to its
    own command ("(probably)" is gone from error messages).
    - SendPrinterCommand: [ESP...] stays on HTTP (reply in the body);
    realtime characters go straight down the socket; every other line goes
    through wsCommands.send with the caller's callbacks on its ok/error.
    If the socket is down nothing is sent, the user is told, and the error
    callback runs. SendRealtimeCmd and the custom command box route the
    same way.
    - The single-slot grbl_processfn/grbl_errorfn matcher is removed.
    - Pacin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
2026-11-10 Soft reset (0x18) is Maslow's fast stop: sync belts, no abort alarm
    0x18 during Run, Jog or a feed hold stops stepping at once, as upstream
    does. Upstream then raises ALARM:3 because a stepper machine may have
    lost position. The Maslow's encoders still know where the belts are, so
    instead it syncs the belt step counts to the encoders, resets the belt
    PIDs and goes Idle. The rest of the reset is unchanged (job aborted,
    spindle and belt motors off, input discarded, restart banner).
    The sync is split out of haltMotion() as syncBeltsToEncoders(); $STOP
    behaves as before. In Home state (Maslow belt operations) a reset still
    goes through Homing::fail and alarms.
    Builds; not yet run on the machin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
2026-11-10 UI: Stop sends 0x18 then $STOP; expected errors don't save the log
    wsCommands.stop() sends 0x18 (halts at once in any state), waits for the
    restart banner (up to 1.5 s, since the restart discards unread input),
    then sends $STOP to raise Z and save positions. Replaces 0x85+$STOP for
    jogs and the feed-hold sequence for runs; the 300 ms $STOP retry loop
    that piled up duplicates behind the paced queue is gone. A stop that
    couldn't be sent is resent on reconnect for up to 30 s.
    send() gains urgent (ahead of queued lines) and quiet (no "Machine
    rejected" message). handleLine returns true for a quiet line's error so
    socket.js skips grbl.js fault handling: the expected error:120 no longer
    triggers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
2026-11-10 UI: machine.js, named machine actions with one state store
    New layer between the UI handlers and wsCommands. Each action (retract
    belts, jog, stop, read a setting, ...) returns an Operation: a Promise
    that resolves when the action is done, with .accepted resolving on the
    firmware's ok. Both reject with { reason, command, code?, detail }.
    Units are mm and mm/min; motion lines carry G21.
    - State store: grbl state, Maslow state, mpos/wpos/wco, job progress,
    MINFO, G-code units, from the lines socket.js already receives.
    on("state") / on("line") to follow it.
    - Completion: Maslow belt operations are done when the Maslow state
    reaches its success state and the firmware is Idle; a refused r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
2026-11-10 UI: belt buttons, stop, pause, resume, jog and move use machine.*
    Belt operations (Retract All, Extend All, Find Anchors, Apply Tension,
    Release Tension, Set Z-Stop, and the apply-tension retraction warning's
    Continue) run through runMachineAction: the label is shown as before,
    then "<label> finished", "<label> failed: <reason>" or "<label>
    stopped" when the operation ends. $MINFO is sent 1 s after the start
    as before, and again at the end.
    Jog, move, the numpad go-to and the toolpath "Move to" convert display
    units to mm and call machine.jog / machine.moveTo, which always send
    G21. Behaviour changes:
    - Z_TOP (work Z 70 mm) used a unitless G0 Z70, which in inch mode
    meant 70 inches; it no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
2026-11-10 Status report carries the Maslow state (MS) and belts (BL/BE)
    Firmware (Report.cpp): every status report gets |MS:<0-9>, the Maslow
    calibration state. Belt lengths |BL:tl,tr,bl,br (2 decimals) and
    position errors |BE:etl,etr,ebl,ebr (encoder minus target, 3 decimals),
    in mm, arms in firmware order TL,TR,BL,BR, go in every 20th report while
    reports are periodic (Run/Home/Jog; about once a second at 50 ms) and in
    every report otherwise (idle reports come on changes or a '?'). Counted
    like WCO (REPORT_BELTS_REFRESH_BUSY_COUNT in Config.h).
    Channel::autoReport also sends a report when the Maslow state changes,
    so an idle machine reports a new state at once. It compares against the
    last state it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
2026-11-10 Docs: protocol.md documents MS, BL and BE
    The status-report format, field table and section 5.3 describe the
    Maslow state (MS) in every report and the belt lengths/errors (BL/BE)
    about once a second. The UI no longer reads the "Current state" log
    line or sends $GSTATE.
2026-11-10 UI: Maslow state from the MS field only; drop log-line parsing
    The UI no longer reads "[MSG:INFO: Current state: N]": the state comes
    from the MS field of every status report (setMaslowState). The log line
    and the status report travel by different firmware paths and could
    arrive out of order around a change, flipping the buttons back briefly.
    The firmware still prints the line for people reading the log.
    - machine.js: a Maslow operation counts as started when a status report
    shows its start state (or its success state, unless the machine was
    already in it, e.g. retract when retracted). It asks for a report with
    '?' after the ok; a refusal is concluded only from the second report
    aft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
2026-11-10 Backlog: partial belt restore seen on m4 after a flash
2026-11-10 UI: group the Maslow tab's right panel into four bordered sections
    State + Setup/Options/action/Release Tension buttons, then the jog pad with the
    position readout, then the GCode job controls, then serial messages. Buttons are
    only moved. While finding anchors the same controls hide, now as whole sections.
    - Drop the machine-position (Xm/Ym/Zm) columns from the readout.
    - Fix Upload/Delete overflowing their column (fixed height + forced aspect ratio).
    - Hide the empty job-bounds row until there are bounds to show.
2026-11-10 Restore each belt length on its own at boot; report unknown belts
    loadBeltPositions checked the belts in order TL, TR, BL, BR and gave up
    at the first whose encoder had moved more than 1/4 turn since the save,
    leaving the earlier belts applied and the later ones at 0. In vertical
    mode the upper belts often creep under the sled's weight while the
    motors are off, so this is common (m4 after a flash: TL restored, the
    rest 0).
    Now each belt is checked and restored independently (one loop instead
    of four copied blocks). A belt that moved too far is left unknown and
    logged; the others are restored. If all four are restored the state is
    chosen as before (RETRACTED/EXTENDEDOUT); otherwise it stays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
2026-11-10 UI: belt lengths readout in the status section
    Under the Setup / Options / action / Release Tension buttons, a 2x2 grid
    laid out like the arms (TL TR / BL BR) shows each belt's length in mm,
    "unknown" (amber) when the machine reports it doesn't know it, or "-"
    before any report. It updates on every machine.js state update.
    machine.js: a "?" in BL becomes null (unknown). Once status reports
    carry BL, MINFO no longer overrides the lengths (it reports raw encoder
    values for unknown belts) but still adds homed/extended.
    Checked on m4 through the dev server (all four known); the unknown
    style checked with a simulated report. Tests pass (87/88, the known
    failure).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
2026-11-10 Status report: belts and motor currents in every report; report monitor
    Every status report now carries BL (belt lengths), BE (belt position
    errors) and the new MC (belt motor currents, raw ADC 0-4095 averaged
    over 10 samples, as the debug log line), so belt lengths keep up with
    X/Y/Z. Every client gets the same fields. The every-20th belts counter
    is gone.
    N:<seq> (temporary): a per-channel report sequence number, so a client
    can tell a dropped report from a late one.
    scripts/report_monitor.mjs measures report size and delivery: it
    connects as its own session, sets $Report/Interval for itself, prints
    reports/s, frames/s, bytes/s, report size, missing N, the longest gap
    while moving and th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
2026-11-10 UI: smaller belt readout with a motor-current dial per belt
    The belt lengths readout uses the X/Y/Z readout's 12 px. Each belt gets a
    small current dial (2em, twice the text height) copied from the Debug
    tab's gauges: same scale (MAX_CURRENT), ADC-to-mA conversion and colour
    bands (now a shared currentGaugeColor in debugging.js). The mA value is
    in the dial's tooltip; with no MC data the dial stays empty.
    machine.js parses MC into state.motorCurrent.
    Checked in a static render with sample data (m4 was offline); tests
    pass (88/89, the known failure).
2026-11-10 Update tablet.js to use the new Operation object more natively for the applytension button as example usage.
    includes additional fixes:
    render unknown state when booted into it
    dev-server session id deconflict. multiple tabs can open the dev
    server without fighting over a single connection
2026-11-10 allow apply tension to run when recovering from boot into a state where some but not all belt lenghts are known.
2026-11-10 UI: machine.runFile and machine.files for SD card jobs and files
    machine.runFile(path) runs a G-code file as an Operation: accepted on the
    $SD/Run ok, done when the job has finished and the machine is Idle, failed
    on an alarm or a rejected line in the file. It needs READY_TO_CUT.
    machine.files.{list, upload, delete, rename, createDir} wrap the /upload
    HTTP actions as Promises that resolve with the parsed folder listing and
    reject with { reason, command, code?, detail }. A firmware "Cannot ..."
    status rejects with the listing attached. Upload and delete pause the ping
    check themselves.
    files.js and the tablet delete button now use these instead of building
    HTTP requests. The tablet deletes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
2026-11-10 STOP during Apply Tension leaves TAKING_SLACK
    $STOP cleared Maslow.takeSlack, but the take-slack loop runs on
    calibration.takeSlack, and nothing changed the calibration state, so the
    machine sat in state 5 with no motion and refused $TKSLK.
    $STOP now calls Calibration::stopTakingSlack(), which goes where a
    failed run goes: EXTENDEDOUT for a normal run (belts saved), UNKNOWN
    when recovering belts from UNKNOWN (saved lengths kept, so Apply Tension
    can be retried).
    Backlog: STOP during Extend, Find Anchors or Release Tension leaves those
    in-progress states too (found reading the code, not fixed here).
2026-11-10 STOP during Trace Boundary stops where the machine is
    Trace Boundary sent all its G0 lines in one WebSocket frame. A reset
    (0x18) flushes every channel's unread input, but the polling task may
    already have handed the next line to cmd_queue, and that line ran after
    the restart. Stopping on the last side sent the machine back to where the
    trace began.
    Firmware: the soft restart now also empties cmd_queue.
    UI: new machine.tracePath(points), an Operation that sends one G0 at a
    time, each after the previous ok, and stops sending once it has ended.
    It needs READY_TO_CUT and puts G20 back if the machine was in inches.
    Trace Boundary uses it and logs "Trace boundary stopped" on a stop.
    Tested on m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
2026-11-10 Stop and resume SD jobs from the stopped line
    STOP used to throw the job away. Now the firmware remembers where an SD
    job stopped, and the tablet can resume it from that line (or any line).
    Firmware (Maslow/JobResume):
    - A job that ends early records its file and the line that was
    executing: the 0x18 stop, $STOP on its own, a spindle fault, or an
    error in the file (that line). Not after an alarm.
    - The status report carries |STOPPED:<line>,<file> while a record
    exists and no job runs. A job start or $SD/Discard clears it.
    - $SD/RunFrom=<line>,<file> reads the lines before <line> in check mode
    (units, offsets, feed and spindle state as the job left them), raises
    Z to the highest Z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
2026-11-10 UI: suggest Apply Tension in UNKNOWN when some belts are known
    After a power cycle that restores some belt lengths but not all, the
    machine boots in UNKNOWN and the suggested-action button said Retract.
    Apply Tension can recover the other belts from there, so in UNKNOWN the
    button now offers Apply Tension when the status report's BL field has at
    least one known length, and Retract when none are known.
2026-11-10 Docs and agent rules for the machine-api UI
    Agent guidance: .github/copilot-instructions.md gets a "Maslow
    architecture rules" section. UI actions go through machine.js
    Operations (the ~60 older direct calls move over when their feature
    changes). State comes from the status report, not MINFO or log lines,
    and new state is a report field. Reuse existing $ commands. Log text the
    UI matches changes on both sides together. No Pause: Stop + Resume is the
    design. CLAUDE.md points to those rules and drops its "prefer MINFO"
    line; the Reviewer agent checks PRs against them.
    User docs: the user guide describes the main control screen (connection
    dot, suggested-next-step button, belt lengths and moto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
2026-11-10 Say why a WebSocket was closed, and show it instead of reconnecting
    Tabs in one browser share a session, so a new tab's socket closes the
    others. They used to reconnect every 3 s and close each other forever,
    with nothing on screen to explain it.
    Firmware: closes it makes on purpose now carry a close code and reason:
    4001 when a newer socket from the same browser replaces this one, 4002
    when a 5th socket connects (the oldest is closed at once, instead of by
    cleanupClients up to 10 s later with no reason). The limit stays at 4.
    UI: on 4001/4002 the disconnected dialog greys out the page with a
    notice and a button (Use this tab / Reconnect), and the tab doesn't
    reconnect by itself. Other clo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
2026-11-10 Backlog: firmware update failures, USB flashing, config alarm reporting
    From moving a machine off the Belt-stretch-compensation firmware: a WiFi
    update refused without a clear reason (and app-slot headroom is down to
    about 170 KB), the script's USB mode broken by esptool 5, and a config
    alarm from unknown keys that the UI can't explain or fix.
2026-11-10 Send job output to every connection; add TENSIONED state
    Job leader removed: a job no longer records the channel that started it.
    Job output and the job-failure line go to all channels, so closing the
    starting tab no longer leaves a pointer to a dead connection. Replies still
    go to the sender. Agent rule "Every connection is equal" added to the
    copilot instructions, CLAUDE.md and the Reviewer checklist.
    New calibration state 10, TENSIONED: Apply Tension finished but the belt
    lengths don't fit the saved anchors (unsolvable, or off by more than 25 mm).
    It used to fall back to EXTENDEDOUT, so the action button offered Apply
    Tension again; it now offers Find Anchors. Release Tension, Apply Tens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
2026-11-10 UI: TENSIONED label says just "Tensioned"
    The Find Anchors button and the Apply Tension dialog already say what to do next.
