MaslowCNC/Maslow_4/(notices)

Notices in the files:
ESP3D-WEBUI/www/js/toolpath-displayer.js:
License: MIT - https://opensource.org/licenses/MIT
